qyx22122/projekt-RC/README.md

# projekt-RC
Projekt preučevanja in raziskovanja nizkocenovnih raketnih motorjev na trdo gorivo.
