qyx22122/projekt-RC/raziskovalna_naloga/predstavitev.tex

\documentclass[aspectratio=169]{beamer}

%Information to be included in the title page:
\title{Energijski izkoristek raketnih motorjev na trdno gorivo}
\author[Tibor Maček \and Leon Smrekar Voskobojnik]{Tibor Maček, 2. letnik \and Leon Smrekar Voskobojnik, 2. letnik \\[0.5cm] \small Mentor: Jure Ausec, univ. dipl. fiz.}

\institute{Gimnazija Vič}
\date{2026}

\usepackage[version=4]{mhchem}
\usepackage[slovenian]{babel}
\usepackage{graphicx, booktabs, physics, siunitx, amsmath, stackengine, geometry, csquotes, hyperref, tabularx}
\graphicspath{{./slike/}}

\hypersetup{
	colorlinks=false,
	linktoc=all,
}
\sisetup{output-decimal-marker={,}}

\usefonttheme[onlymath]{serif}

\usetheme{Berlin}
\usecolortheme{fly}

\begin{document}

\frame{\titlepage}

\section{Uvod}
\begin{frame}
\frametitle{Leteča raketa}
	\begin{figure}
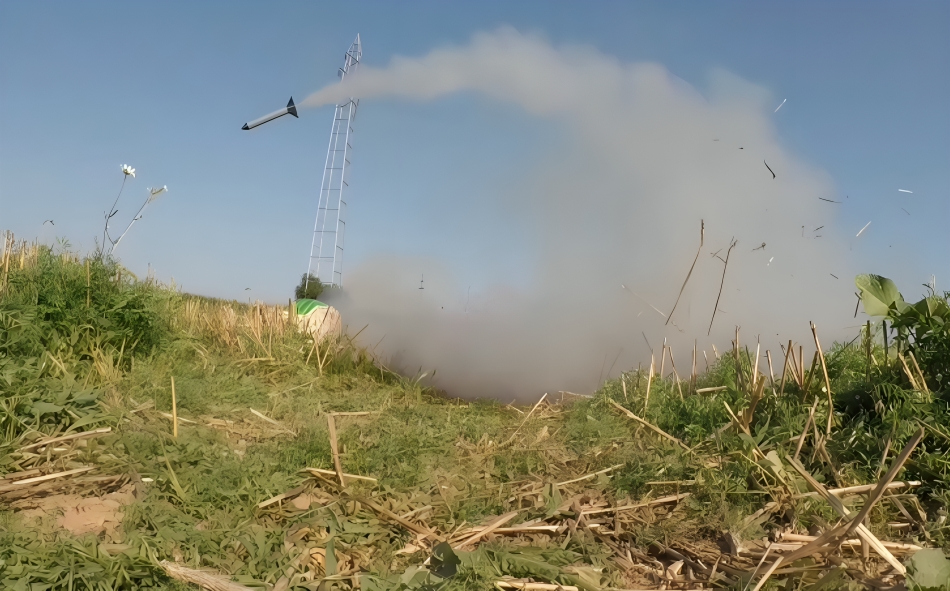
[picture p1: raziskovalna_naloga/slike/Raketa.png]
	

	\end{figure}
\end{frame}
\begin{frame}
\frametitle{Staljena raketa}
			\begin{figure}
			\centering
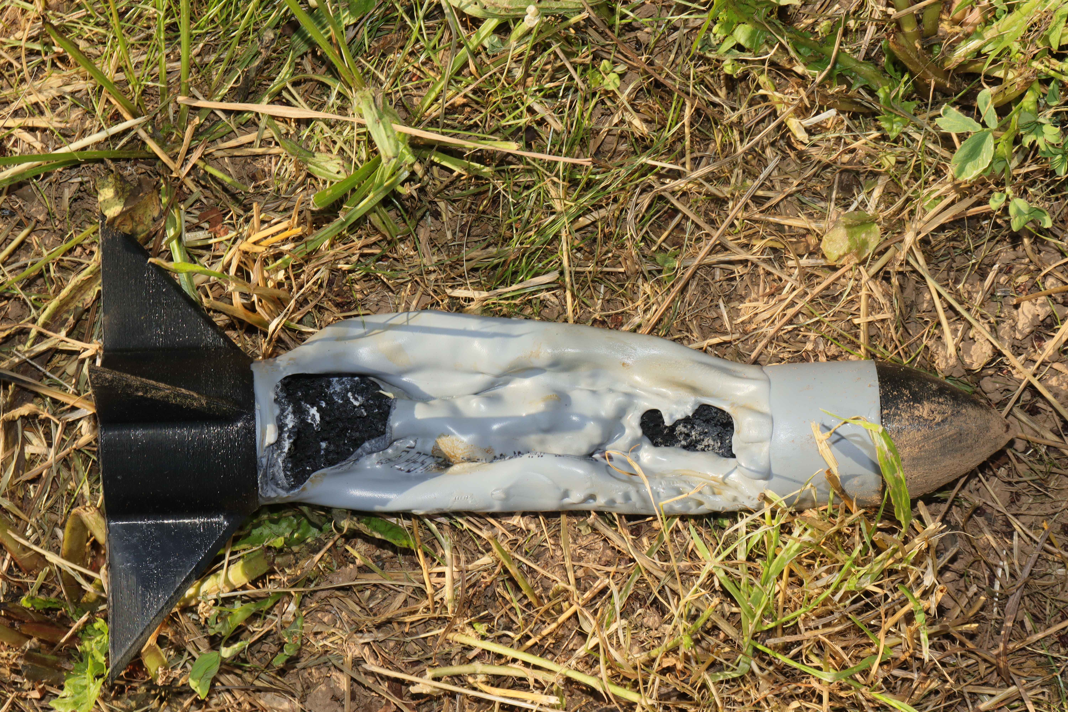
[picture p2: raziskovalna_naloga/slike/uporabljen_kondom.jpg]
			
			\end{figure}
\end{frame}

\section{Sestava motorja}
\begin{frame}
\frametitle{Sestava motorja}
	\begin{columns}
		\column{.5\textwidth}
				\begin{enumerate}
			\item Zunanja cev
				\begin{itemize}
					\item Notranji premer \SI{36}{mm}
					\item Debelina stene \SI{1,9}{mm}
					\item Dolžina \SI{125}{mm}
				\end{itemize} 
			\item Izolator
				\begin{itemize}
					\item Debelina \SI{1,75}{mm}
				\end{itemize} 
			\item Gorivna celica
				\begin{itemize}
					\item Masa \SI{75}{g}
					\item $60:40$ \ce{KNO3} : \ce{C12H22O11}
				\end{itemize} 
			\item Šoba
				\begin{itemize}
					\item Masa \SI{30}{g}
					\item Premer grla \SI{10}{mm}
				\end{itemize} 
		\end{enumerate}
		\column{.5\textwidth}
		\begin{flushleft}
			
		\end{flushleft}
	\end{columns}

\end{frame}

\section{Simuliranje}
\begin{frame}
\frametitle{Simuliranje v programu openMotor}
	\begin{figure}
	\centering
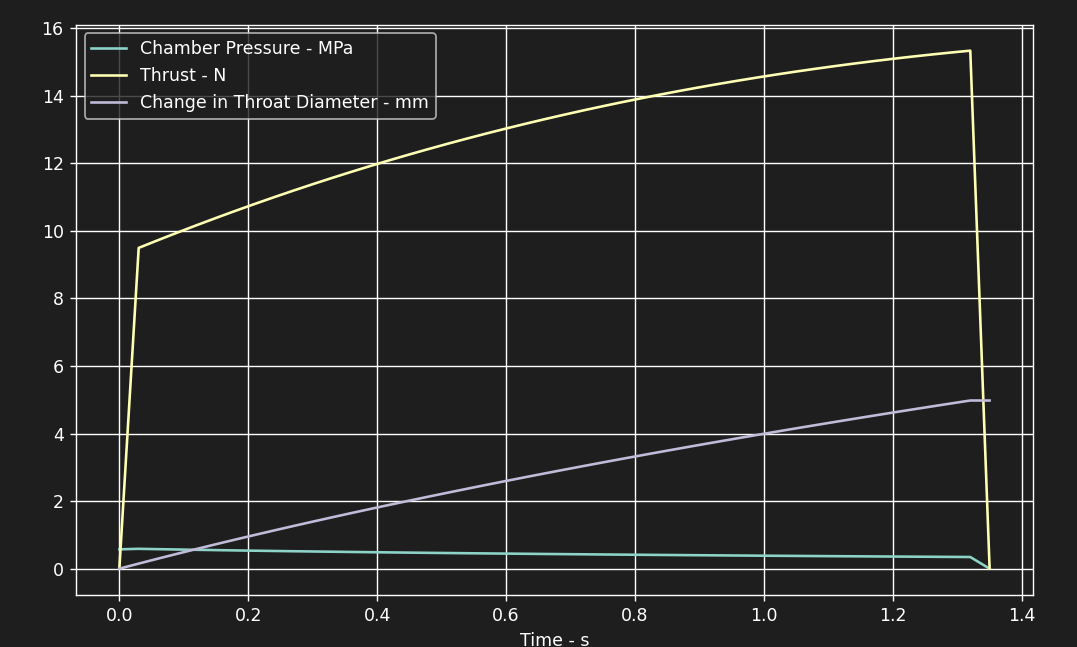
[picture p3: raziskovalna_naloga/slike/prilagojen_impulz_obrezan.png]
	
	
		\caption{Graf in regresija goriva - posnetek zaslona programa openMotor}
	\end{figure}
\end{frame}

\section{Testiranje izolatorjev}
\begin{frame}
\frametitle{Prvi in drugi test izolatorjev}
	\begin{figure}
	\centering
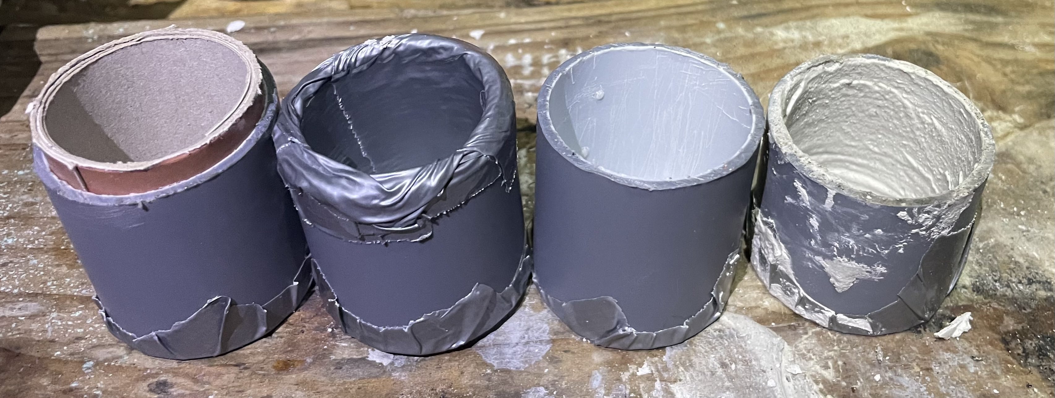
[picture p4: raziskovalna_naloga/slike/prvi_test.jpg]
	
	\end{figure}

	\begin{figure}
	\centering
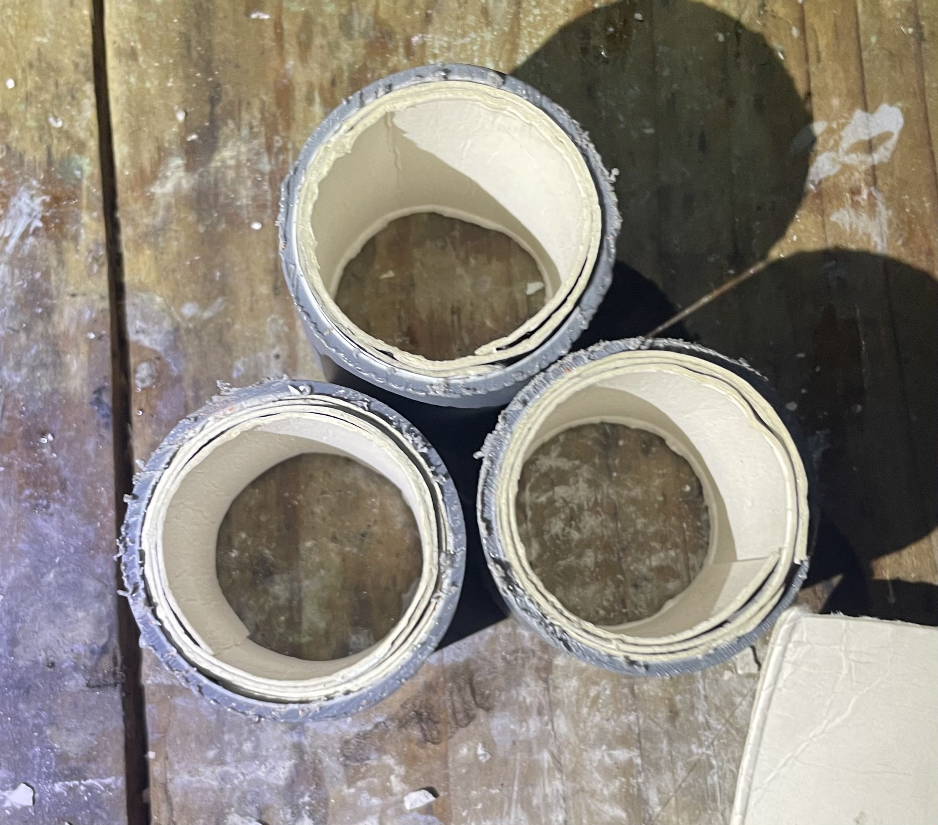
[picture p5: raziskovalna_naloga/slike/drugi_test.jpg]
	
	\hspace{0.3cm}
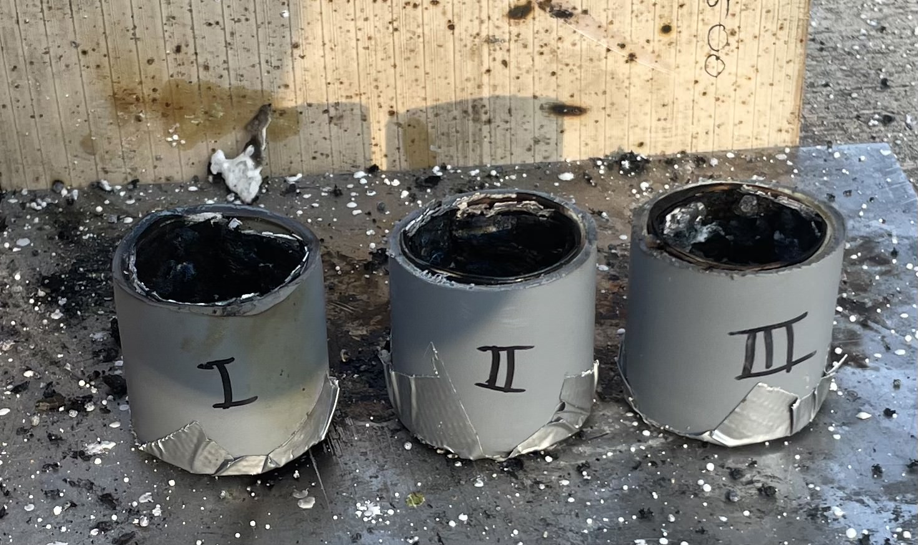
[picture p6: raziskovalna_naloga/slike/drugi_test_potem.jpg]
	
	\end{figure}
\end{frame}

\begin{frame}
\frametitle{Tretji in četrti test izolatorjev}
	\begin{figure}
	\centering
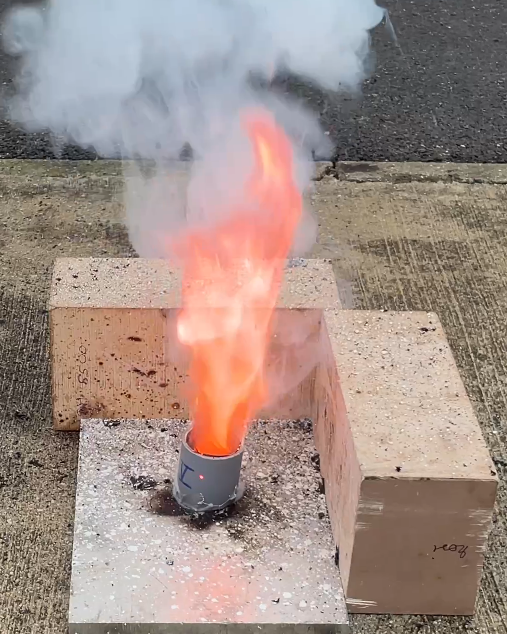
[picture p7: raziskovalna_naloga/slike/test3_5.png]
	
	\hspace{0.3cm}
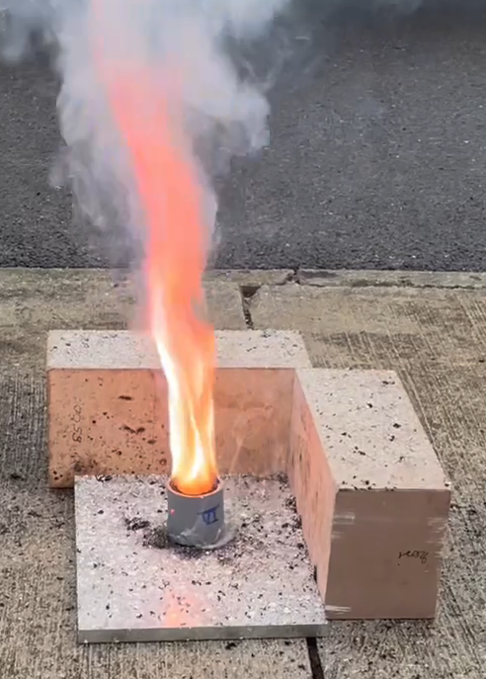
[picture p8: raziskovalna_naloga/slike/test3_6.png]
	
	\end{figure}

	\begin{figure}
	\centering
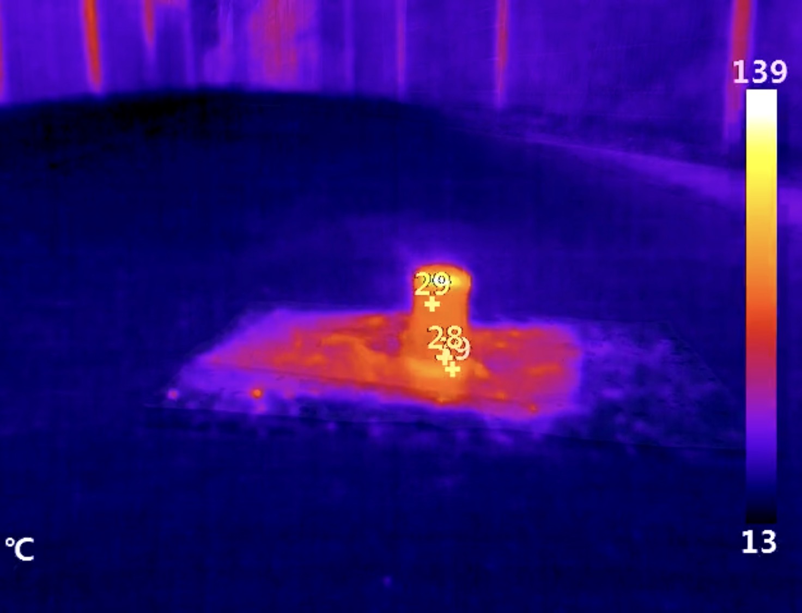
[picture p9: raziskovalna_naloga/slike/termalni_posnetek_takoj_po.jpg]
	
	\hspace{0.3cm}
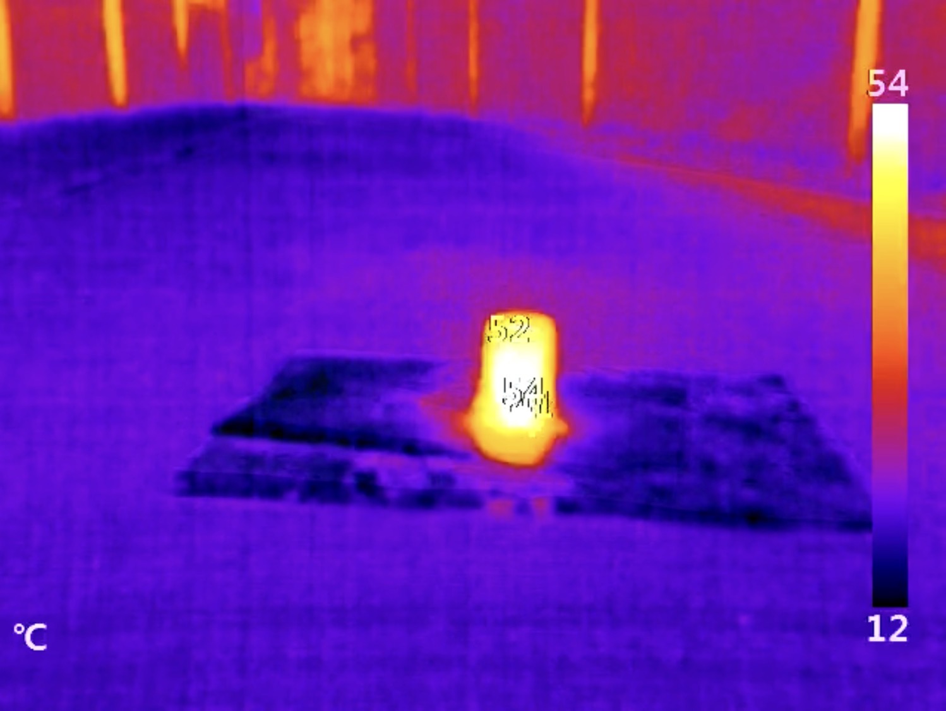
[picture p10: raziskovalna_naloga/slike/termalni_posnetek_kasneje.jpg]
	
	\end{figure}
\end{frame}

\section{Statično testiranje}

\begin{frame}
\frametitle{Statično testiranje}
	\begin{figure}
	\centering
	
	\caption{Prikaz povezanih pripomočkov za testiranje.}
	\label{setup}
	\end{figure}
\end{frame}

\begin{frame}
\frametitle{Prvi in drugi test motorja}
	\begin{figure}

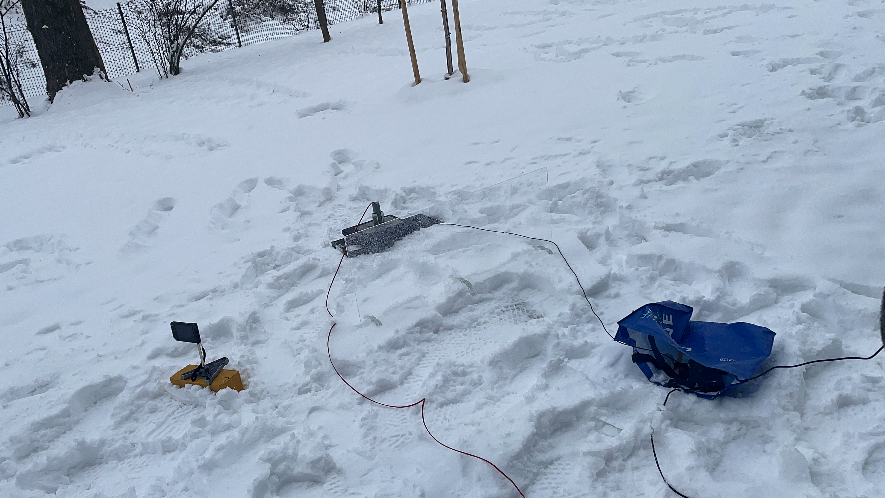
[picture p12: raziskovalna_naloga/slike/prvi_test_motorja.jpg]
	
	
	\caption{Prvo in drugo statično testiranje motorja.}
	\end{figure}
\end{frame}

\begin{frame}
\frametitle{Tretji test motorja}
	\begin{figure}
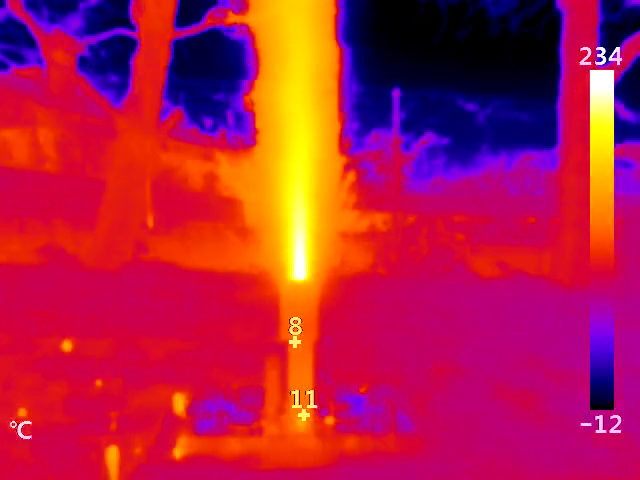
[picture p14: raziskovalna_naloga/slike/tretji_topl_gori.png]
	
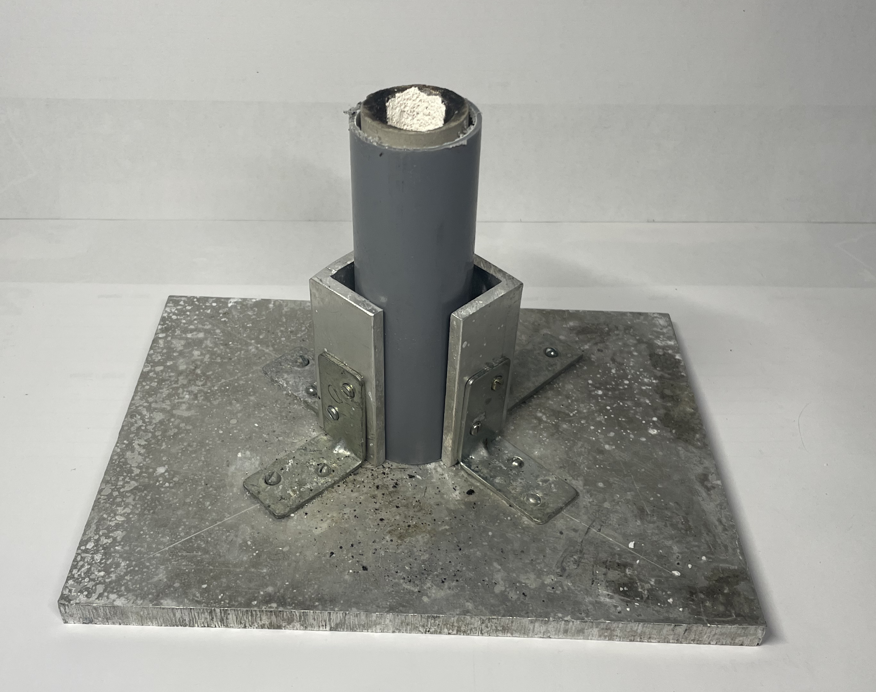
[picture p15: raziskovalna_naloga/slike/stojalo_motor.png]
	
	\caption{Tretji test sneman s termalno kamero, stojalo motorja}
	\end{figure}
\end{frame}

\begin{frame}
\frametitle{Tretji test motorja}
	\begin{figure}
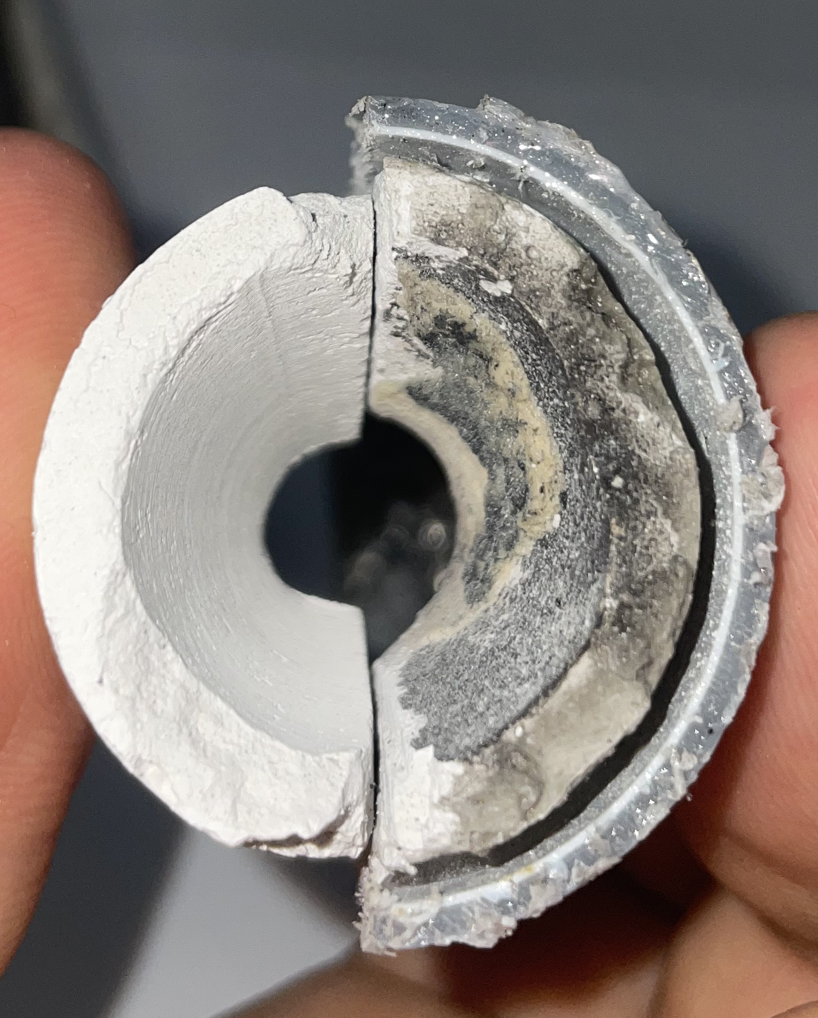
[picture p16: raziskovalna_naloga/slike/erozija_sobe.PNG]
	
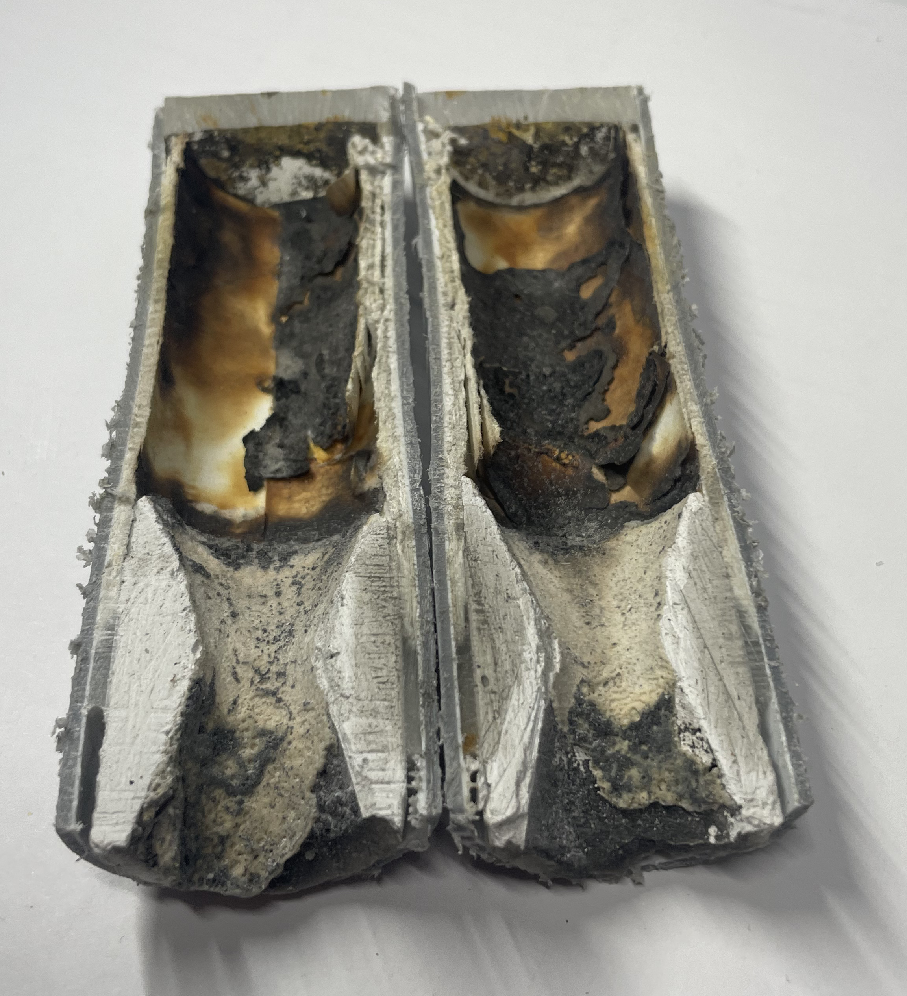
[picture p17: raziskovalna_naloga/slike/lezec.png]
	
	\caption{Primerjava sveže in erodirane šobe, prerezan testiran motor}
	\end{figure}
\end{frame}

\section{Analiza podatkov}
\begin{frame}
\frametitle{Analiza podatkov}
	\begin{figure}
	\centering
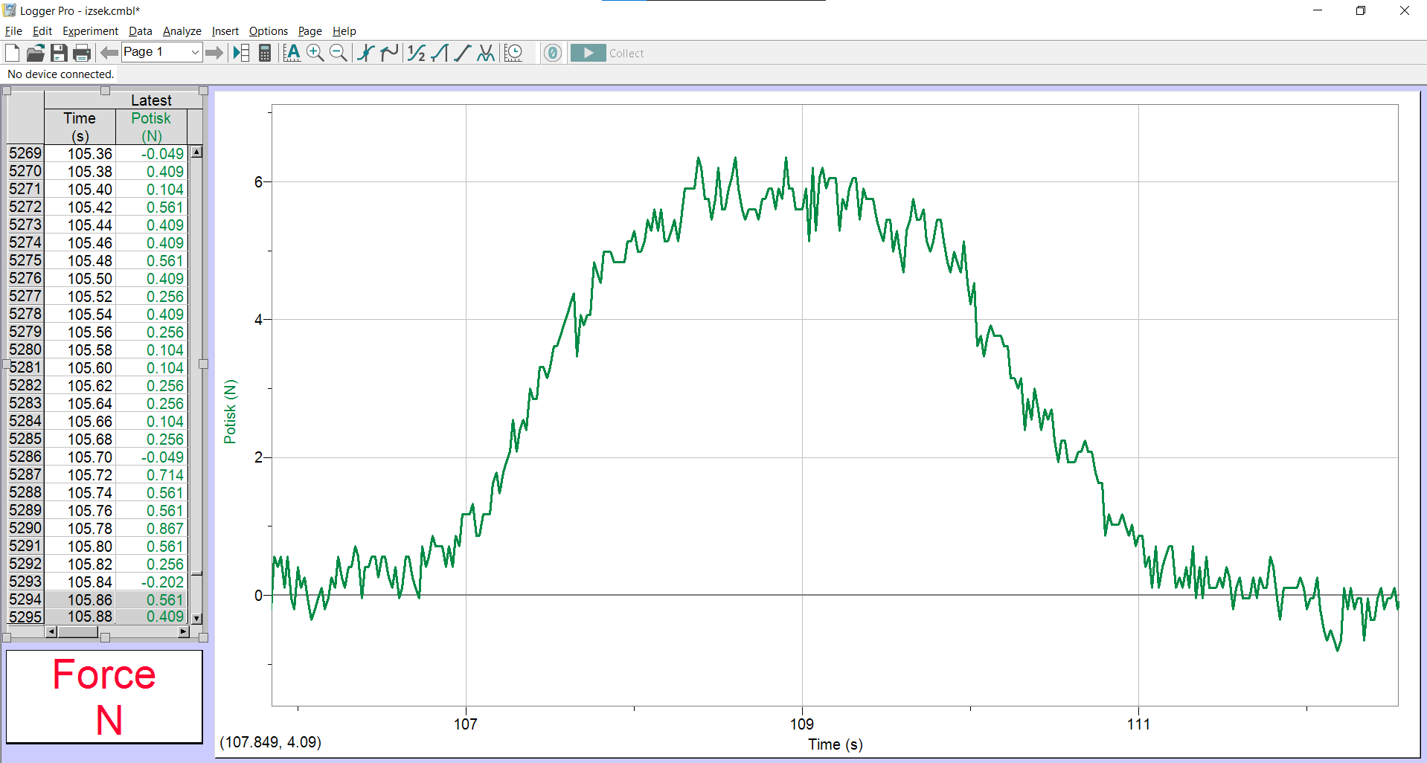
[picture p18: raziskovalna_naloga/slike/potisk.png]
	
	\end{figure}

	\begin{equation}
		 I = F \Delta t = \SI{17,3}{Ns} \pm \SI{1,6}{Ns}\nonumber
	\end{equation}
\end{frame}
\begin{frame}
\frametitle{Povprečni potisk in specifični impulz}

\begin{align}
\onslide<1->{
\bar{F} &= \frac{I}{t}
= \frac{\SI{17,3}{Ns} \pm \SI{1,6}{Ns}}
       {\SI{3,6}{s} \pm \SI{0,1}{s}}
= \SI{4,8}{N} \pm \SI{0,6}{N}
} \nonumber \\[1em]
\onslide<2->{
I_{SP} &= \frac{I}{m \cdot g_0}
= \frac{\SI{17,3}{Ns} \pm \SI{1,6}{Ns}}
       {(\SI{0,075}{kg} \pm \SI{0,001}{kg}) \cdot \SI{9.80665}{m/s^2}}
= \SI{23,5}{s} \pm \SI{2,3}{s}
} \nonumber
\end{align}
\end{frame}

\begin{frame}
\begin{align}
\frametitle{Izhodna hitrost izpuhov in sprememba hitrost rakete}
\onslide<1->{
\bar{v_e} &= \frac{I}{m}
= \frac{\SI{17,3}{Ns} \pm \SI{1,6}{Ns}}
       {\SI{0,075}{kg} \pm \SI{0,001}{kg}}
= \SI{230}{m/s} \pm \SI{23}{m/s}
} \nonumber \\[1em]
\onslide<2->{
\Delta v &= v_e \ln\!\left(\frac{m_0}{m_1}\right) = (\SI{230}{m/s} \pm \SI{23}{m/s})
   \cdot
   \ln\!\left(
   \frac{\SI{0,170}{kg} \pm \SI{0,001}{kg}}
        {\SI{0,095}{kg} \pm \SI{0,001}{kg}}
   \right) \nonumber \\[1em]
	&= \SI{134}{m/s} \pm \SI{17}{m/s}
} \nonumber
\end{align}
\end{frame}

\begin{frame}
				\begin{table}
					\centering
					\begin{tabular}{lll} 
						\hline
						Raketni motor & Vrsta & $I_{SP}$ [s] \\
						\hline \noalign{\vskip 0.3ex}
						NERVA NRX A6 & Nuklearni & 869\\ 
						RS-25 & Tekoče gorivo & 453 \\ 
						RD-843 & Tekoče gorivo & 315,5 \\
						Merlin 1D & Tekoče gorivo & 310 \\
						Avio Zefiro 9A & Trdno gorivo & 295,2\\
						Avio Zefiro 23 & Trdno gorivo & 287,5 \\
						Space Shuttle SRB & Trdno gorivo & 250 \\ 
						Najin motor & Trdno gorivo & 23,5 \\ 
						\hline
					\end{tabular}
				\end{table}
	\tiny
	\centering
	(https://www.dl1.en-us.nina.az/Specific\_impulse.html, 7. 2. 2026)

\end{frame}

\section{Zaključek}

\begin{frame}
\frametitle{Rezultati}
		\begin{itemize}
		\item Izdelava cenovno ugodnega motorja
		\item Dokaz papirja kot dobrega izolatorja
		\item Odkritje neprimernosti KD šobe za najin motor
		\item Omogočanje nadaljnjega testiranja motorja ostalim
		\item Ponovljiv način pridobivanja goriva
		\item Preverjena točnost simulacije
		\end{itemize}
\end{frame}

\begin{frame}
\frametitle{Opredelitev do preostalih hipotez}
	\begin{columns}
		\column{.5\textwidth}
		\begin{enumerate}
			\item Primerjava simulacije in izmerjenih podatkov\\
			\item Nizkocenovnost motorja \\
				\begin{itemize}
				\item Cena materialov enega motorja približno 1,15 evra.
				\end{itemize}
		\end{enumerate}
		\column{.5\textwidth}
			\begin{figure}
			\centering
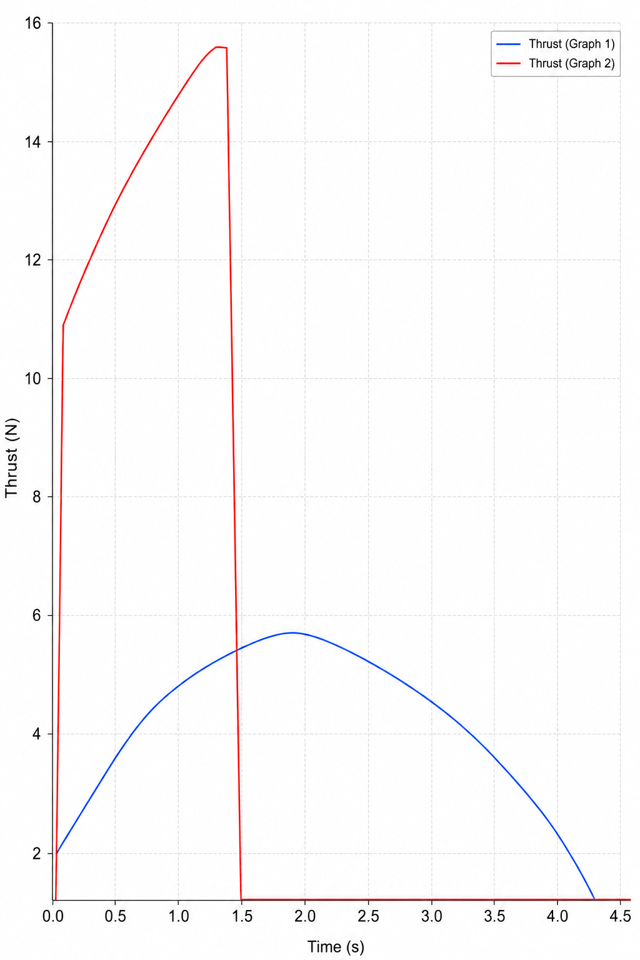
[picture p19: raziskovalna_naloga/slike/potisk_primerjava.png]
			
			\end{figure}
	\end{columns}
\end{frame}
\begin{frame}
\frametitle{Zaključek in ideje za naprej}
	Ideje za naprej :
		\begin{itemize}
		\item Drugi materiali za šobe
		\item Drugačna oblika šobe
		\item Raziskava vpliva vlage na gorivo
		\item Alternativna goriva
		\item Preizkusiti druge metode izdelave goriva 
		\item Dinamično testiranje motorja v raketi
		\end{itemize}
		
\end{frame}
\begin{frame}
\frametitle{Hvala za pozornost}
			\begin{figure}
			\centering
			
			\end{figure}
\end{frame}

\section{Dodatna Gradiva}
\begin{frame}
			\begin{figure}
			\centering
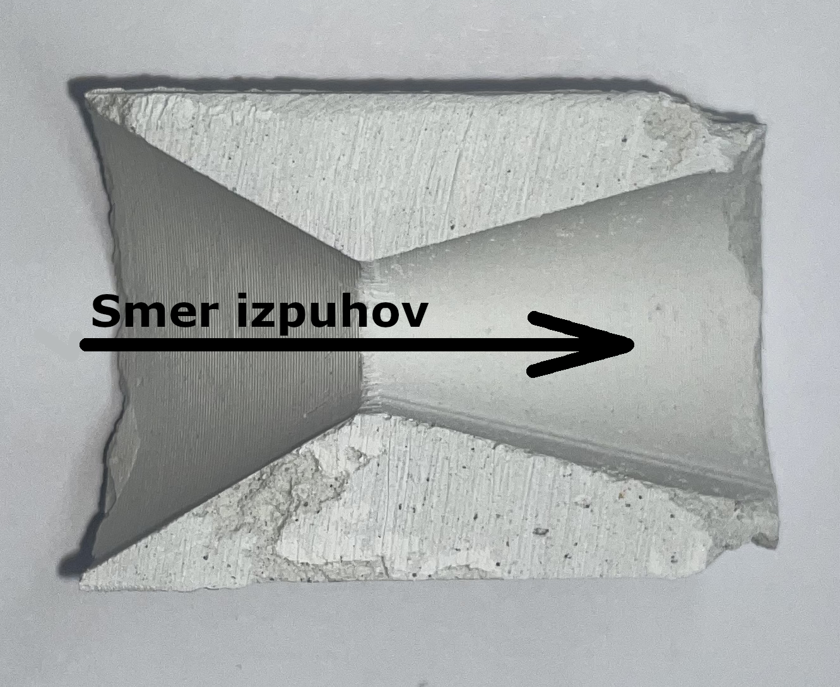
[picture p20: raziskovalna_naloga/slike/prerez_sobe_smer.png]
				
			\end{figure}

			\begin{equation} \label{eq:šoba-vA}
				(1 - M^2) \frac{\dd v}{v} = - \frac{\dd A}{A} \nonumber
			\end{equation}
\end{frame}
\begin{frame}

			\begin{figure}
			\centering
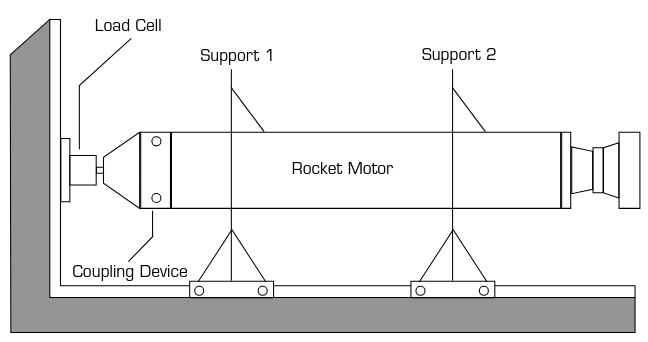
[picture p21: raziskovalna_naloga/slike/shema_merjenja_potiska.png]
			
			\caption{Shema tipičnega statičnega testa.}
			\end{figure}
\end{frame}
\begin{frame}

				\begin{figure}
				\centering
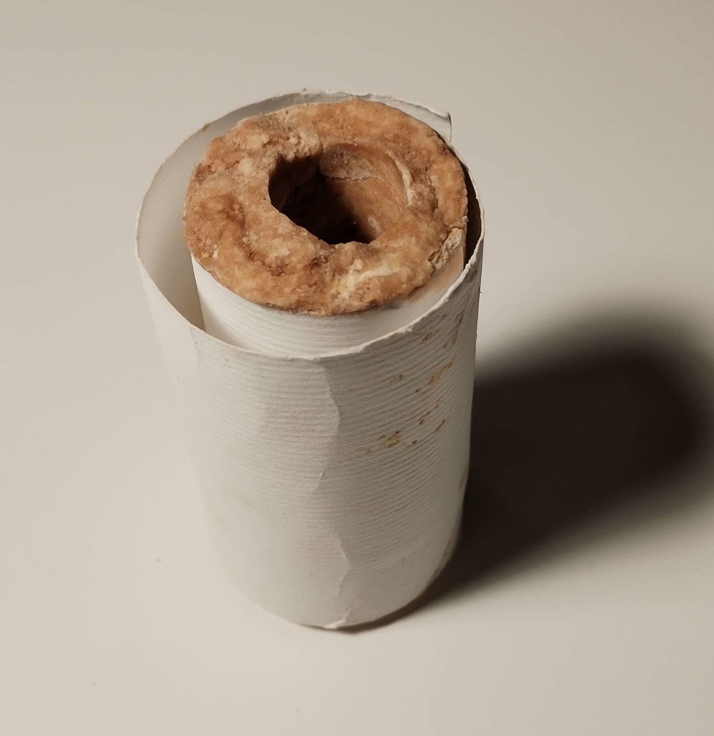
[picture p22: raziskovalna_naloga/slike/gorivna_celica_med.jpg]
				
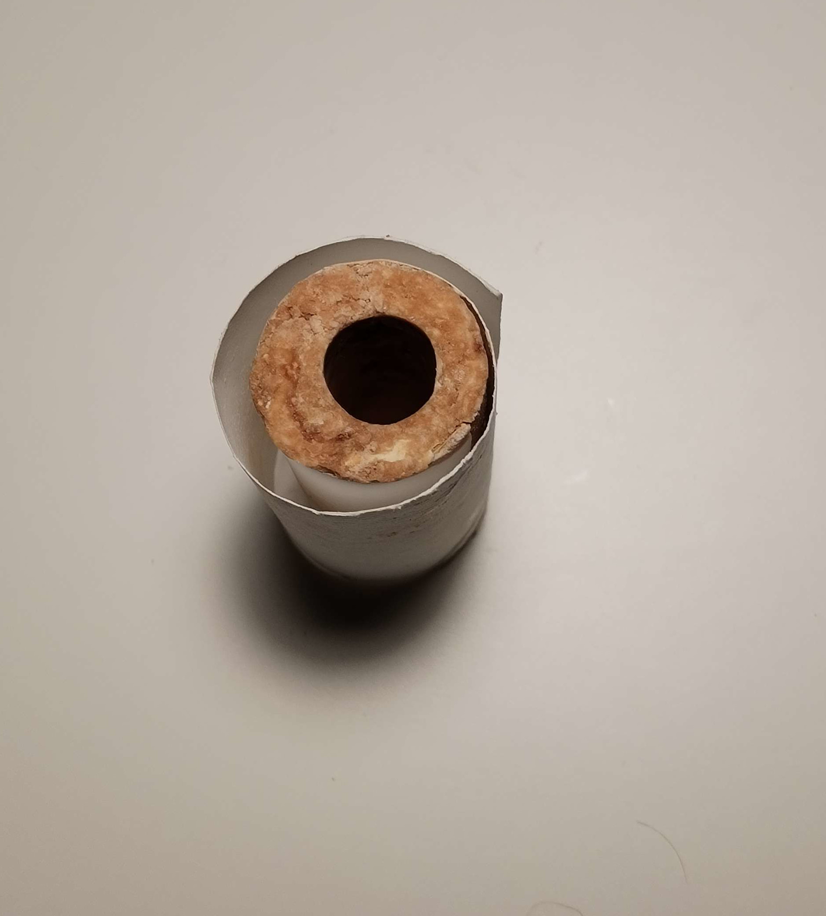
[picture p23: raziskovalna_naloga/slike/gorivna_celica_med2.jpg]
				
				\end{figure}

				\begin{figure}
				\centering
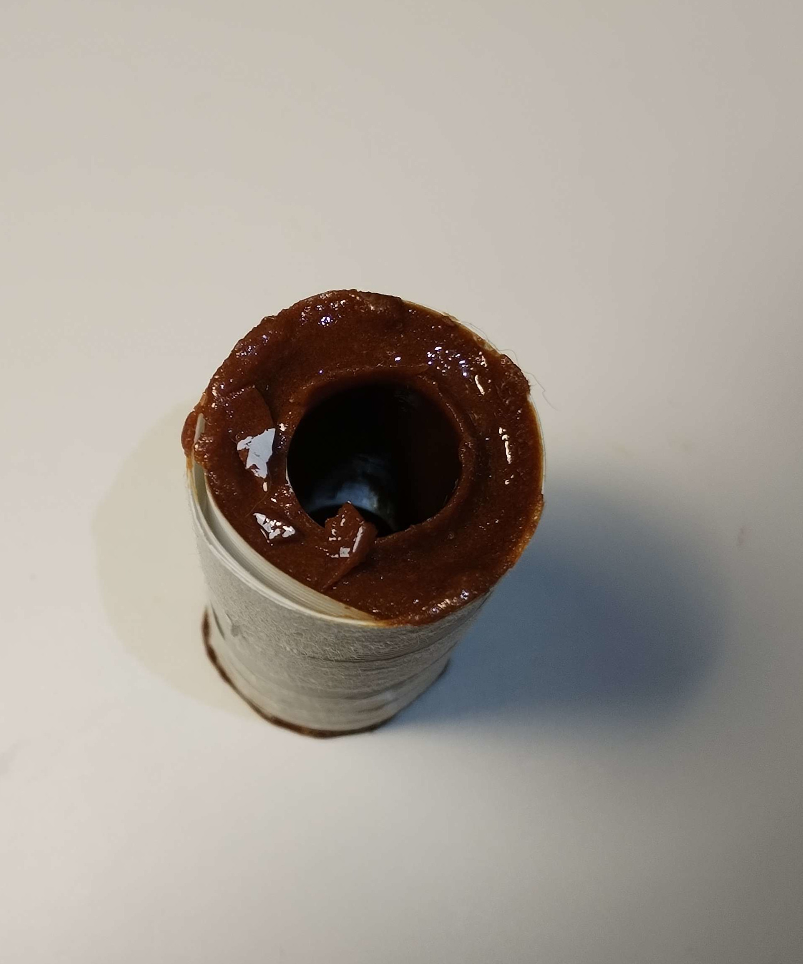
[picture p24: raziskovalna_naloga/slike/gorivna_celica.jpg]
				
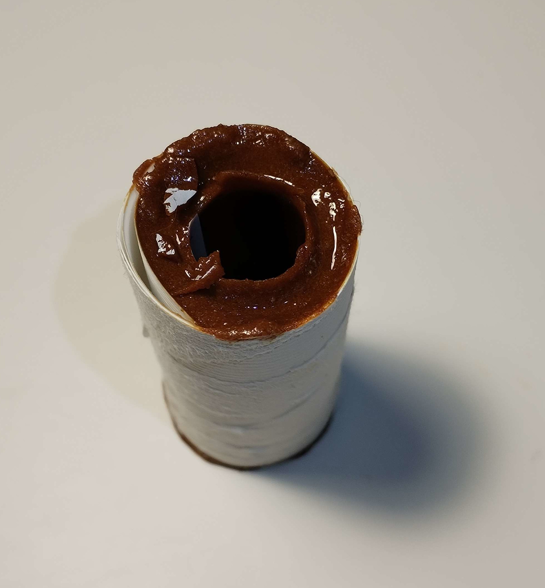
[picture p25: raziskovalna_naloga/slike/gorivna_celica2.jpg]
				
				\end{figure}
\end{frame}
\begin{frame}
			\begin{figure}
			\centering
			
			\caption{Digestorij (odduha), kjer je pripravljeno vse za pripravo gorivnih celic.}
			\end{figure}
\end{frame}

\begin{frame}

			\begin{figure}
			\centering
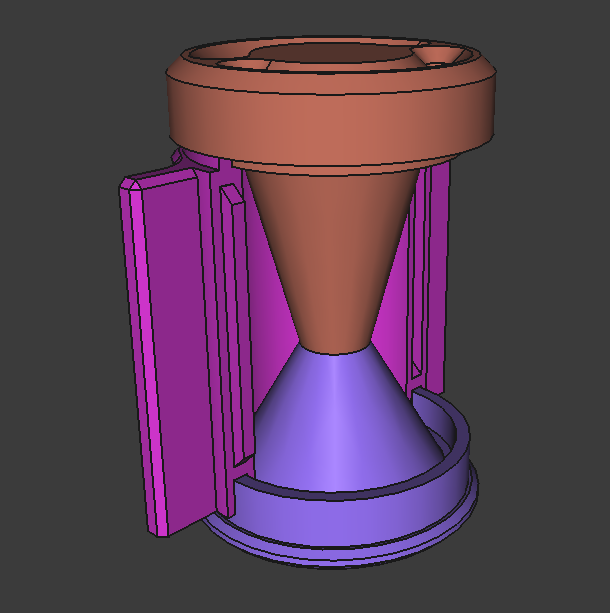
[picture p26: raziskovalna_naloga/slike/šoba_1.png]
			
			\hspace{0.3cm}
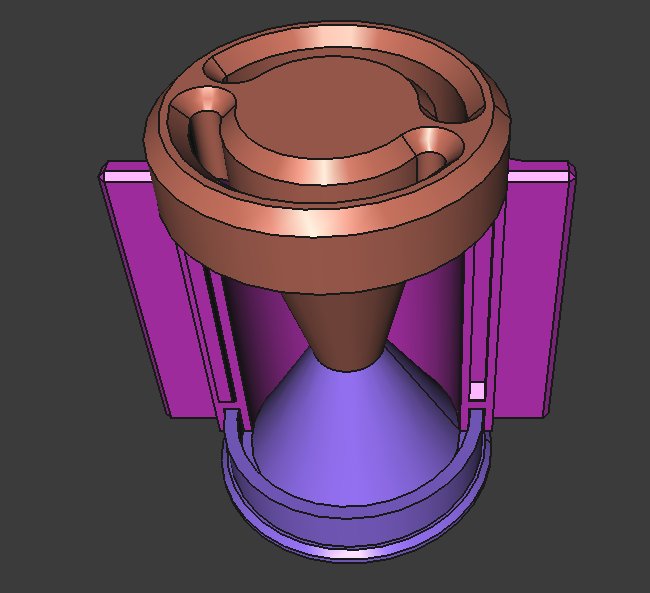
[picture p27: raziskovalna_naloga/slike/šoba_2.png]
			
			\end{figure}

			\begin{figure}
			\centering
			\hspace{0.3cm}
			
			\hspace{0.3cm}
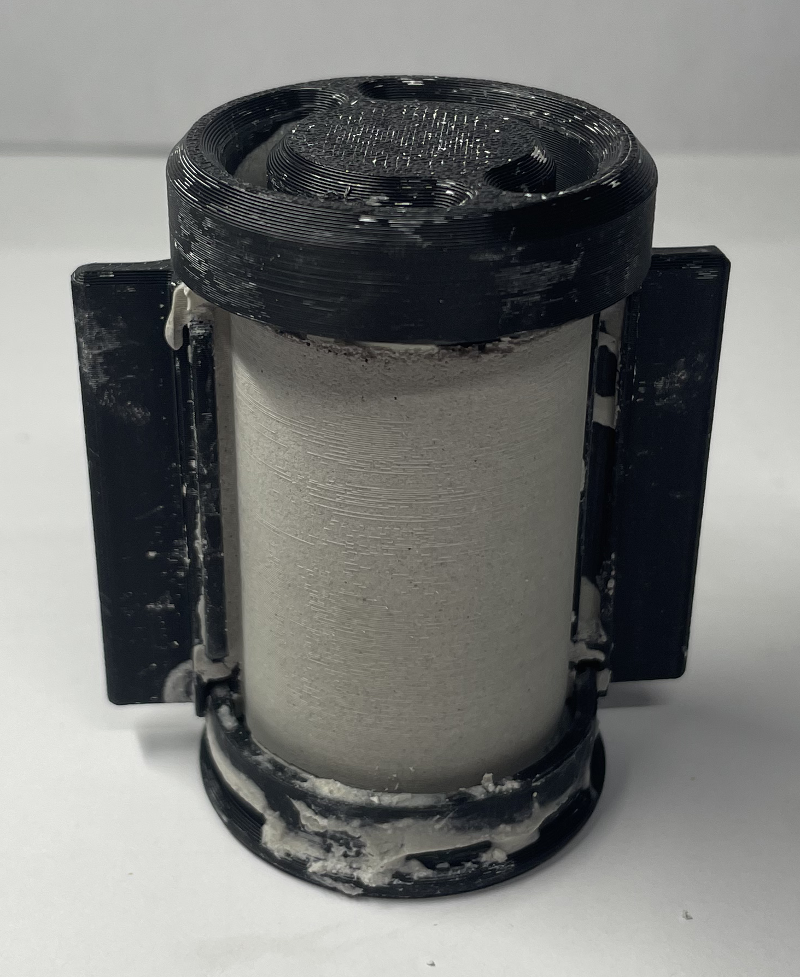
[picture p29: raziskovalna_naloga/slike/model_krilo_poln.png]
			
			\hspace{0.3cm}
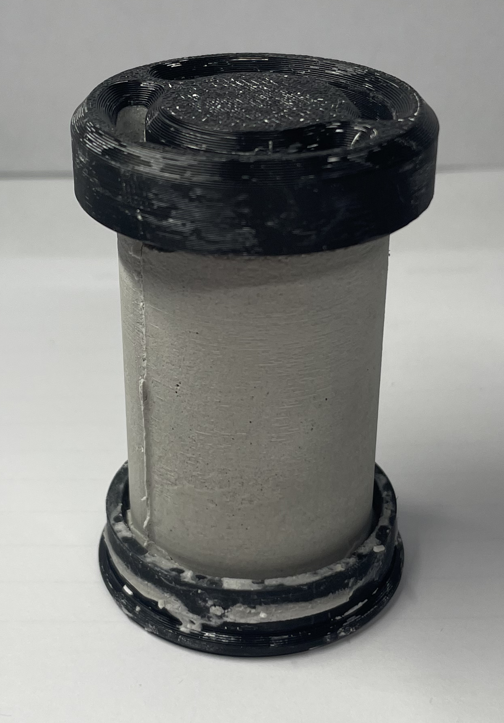
[picture p30: raziskovalna_naloga/slike/model_s_sobo.png]
			
			\end{figure}
\end{frame}
\begin{frame}
\ce{C12H22O11(s) + 6.288 KNO3(s) ->\\ -> 3.796 CO2(g) + 5.205 CO(g) + 7.794 H2O(g) + 3.065 H2(g) +\\+ 3.143 N2(g) + 2.998 K2CO3(l) + 0.274 KOH(g)}
\end{frame}

\end{document}
