qyx22122/projekt-RC/raziskovalna_naloga/EIRMNTG.tex

\documentclass[titlepage, a4paper, twoside, final, 12pt]{article}

\setcounter{secnumdepth}{2} %Globina uštevilčnja naslovov
\setcounter{tocdepth}{3} %Do katere globine bodo naslovi v kazalu

\usepackage[slovenian]{babel}
\usepackage{csquotes}
\usepackage[version=4]{mhchem}
\usepackage[backend=biber, date=iso, seconds=true]{biblatex}
\setcounter{biburllcpenalty}{7000}
\setcounter{biburlucpenalty}{8000}
\usepackage{graphicx}
\usepackage{geometry}
\usepackage{stackengine}
\usepackage{physics}
\usepackage{amsmath}
\usepackage{siunitx}
\sisetup{
	output-decimal-marker = {,},
}

\usepackage{float} %za hard override placementa slik /begin{figure}[H]
\usepackage{placeins} % za barierje placementa slik /FloatBarrier

\usepackage{fancyhdr}
\pagestyle{fancy}

\fancyhf{}              % clear all header and footer fields
\fancyhead[L]{Energijski izkoristek raketnega motorja na trdno gorivo}  % left header
\fancyhead[C]{}    % center header
\fancyhead[R]{Raziskovalna naloga} % right header

\fancyfoot[C]{\thepage}
\addtolength{\topmargin}{-2.49998pt}

\usepackage{hyperref}
\hypersetup{
	colorlinks=false,
	linktoc=all,
}

\usepackage[nameinlink]{cleveref} % za lepse, auto reference. sintaksa: v sliki /label{label} in potem /cref{label} za lepo naslavljanje slik in tabel

\graphicspath{{./slike/}}

\addbibresource{./literatura.bib}

\geometry{centering}

\begin{document}

\begin{titlepage}
	\begin{center}
		\vspace*{1cm}
		\huge
		\textbf{Energijski izkoristek raketnega motorja na trdno gorivo}
			
		\vspace{1.5cm}

		\normalsize
		Avtorja:
		
		\large
		\textbf{Leon Smrekar Voskobojnik, 2. letnik}

		\textbf{Tibor Maček, 2. letnik}
		\vspace{0.5cm}
		
		\normalsize
		Mentor:
	
		\large
		\textbf{Jure Ausec}
		\vfill
		%\includegraphics{kul slika}
		\normalsize
		Raziskovalna naloga s področja fizike
		\vspace{1.5cm}	

		
		\vspace{0cm}

		Gimnazija Vič
		2025/2026

	\end{center}
\end{titlepage}

\renewcommand{\thepage}{\Roman{page}}
\renewcommand{\abstractname}{Zahvala}
\begin{abstract}
	\thispagestyle{plain}
	\setcounter{page}{2}
	Zahvalila bi se rada za vso pomoč, ki sva je bila deležna ob raziskovanju in ustvarjanju naloge. 

	Posebno bi se rada zahvalila vsem uslužbencem Gimnazije Vič, ki so nama hitro priskočili na pomoč, in sicer prof. Alenki Ocvirk Zelič za lektoriranje povzetka in naloge,
	laborantki kemije Andreji Šporar za omogočanje dostopa do šolskega digestorija, 
	hišnikoma Slavku Gorniku in Bojanu Jakši za izdelavo stojala za testiranje,
	laborantu fizike Denisu Pavlinu za dostopnost, predloge in pomoč pri testiranju.
	Posebna zahvala pa mentorju Juretu Auscu za predloge, pregledovanje in predlaganje popravkov ter izboljšav, pomoč pri testiranju, prisotnost in posledično omogočanje uporabe digestorija tudi za petkove popoldneve ter za odgovarjanje na vsakršna vprašanja in vsespološno odzivnost.
\end{abstract}

	\renewcommand{\thepage}{\Roman{page}}
		\thispagestyle{plain}
		\setcounter{page}{3}
		\section*{Povzetek}
		V raziskovalni nalogi sva se poglobila v delovanje, simuliranje in testiranje raketnih motorjev na trdno gorivo. V teoretičnem delu sva opisala, na katerih fizikalnih zakonih temeljijo raketni motorji in kakšno funkcijo imajo posamezni deli raketnega motorja na trdno gorivo. Nato sva se lotila razvoja lastnega raketnega motorja na trdno gorivo, ki je narejen iz dostopnih in cenovno ugodnih materialov ter ne potrebuje manj dostopnih strojev, kot sta na primer stružnica in CNC rezkar. Testirala sva različne vrste in debeline izolatorjev, dokler nisva našla najprimernejšega. S simulacijo sva si pomagala pri načrtovanju šobe in ostalih kritičnih dimenzij motorja, ki sva ga nato tudi sestavila in testirala. Iz pridobljenih podatkov sva potrdila primernost izolatorja in izračunala učinkovitost motorja. Nazadnje sva primerjala izmerjene vrednosti s tistimi iz simulacije, da sva lahko prilagodila parametre simulacije za natančnejše napovedi.

		Ugotovila sva, da je raketo na trdno gorivo mogoče izdelati iz prostodostopnih in nizkocenovnih materialov. Na koncu predlagava še nekaj že ugotovljenih izboljšav in nakaževa možnosti za nadaljnje raziskovanje in testiranje.
		\\[2ex]
		Ključne besede: raketni motor, trdno gorivo, izolator, šoba, specifični impulz

\vspace{0.5cm}
\section*{Abstract}
		In our research project, we delved into the operation, simulation, and testing of solid fuel rocket engines. In the theoretical part, we described the physical laws on which rocket engines are based and the function of individual parts of a solid fuel rocket engine. We then set about developing our own solid fuel rocket engine, made from readily available and inexpensive materials and requiring no specialised equipment such as a lathe or CNC milling machine. We tested different types and thicknesses of insulators until we found the most suitable ones. We used simulation to help us design the nozzle and other critical dimensions of the engine, which we then assembled and tested. From the data obtained, we confirmed the suitability of the insulator and calculated the efficiency of the engine. Finally, we compared the measured values with those from the simulation so that we could adjust the simulation parameters for more accurate predictions.

		We found that a solid fuel rocket can be made from readily available and low-cost materials. Finally, we suggest some improvements that have already been identified and point out opportunities for further research and testing.
		\\[2ex]
		Keywords: rocket motor, solid fuel, insulator, nozzle, specific impulse

	\tableofcontents

	\listoftables

	\listoffigures

	\newpage

	\renewcommand{\thepage}{\arabic{page}}

		\section{Uvod}
		Z razvojem raketne znanosti se je razširilo tudi amatersko raketarstvo in z njim različne velikosti raket, različni materiali in tipi goriva. Skozi čas so
		materiali in znanje postajali vse bolj dostopni. V teh časih vsakdo lahko izdela model rakete, edina vprašanja so izbira materialov,
		porabljen čas in denar, kako varna bo izvedba in kako učinkovit bo motor. Čeprav obstajajo tudi majhni komercialni motorji, sva si želela narediti svoj, cenovno ugodnejši motor.
		Da bi prihranila na opremi, času in denarju nasploh, sva si izbrala najenostavnejše in najcenejše gorivo. Kaj kmalu se nama je porodilo vprašanje
		učinkovitosti in tako so nastali temelji za raziskovalno nalogo. Želela sva dokazati, da je tudi z malo sredstvi in iz
		prostodostopnih materialov mogoče narediti učinkovito in zmogljivo raketo. Tak motor je dostopnejši in posledično na voljo vsem, ki ga želijo uporabiti ali izvesti nadaljnje poizkuse.
		Motor sva tudi analizirala, tako s teoretičnega vidika, kot tudi s statičnim testiranjem.
		
		\subsection{Hipoteze}
		Že na začetku so se nama porodile številne hipoteze, ki sva jih skozi raziskovalno nalogo preizkusila in se na koncu do njih tudi opredelila.
		Postavila sva sledeče hipoteze:
		\begin{enumerate}
				\item Raketni motor na trdno gorivo je mogoče narediti iz nizkocenovnih in dostopnih materialov.
				\item Papir je primeren izolator in notranja plast zgorevalne komore raketnih motorjev na trdno gorivo.
				\item Šobe iz mavca lahko prenesejo tlak in visoke temperature, katerim so izpostavljene v motorju.
				\item Simulacije, pridobljene s programom openMotor, so primerljive z empiričnimi podatki.
		\end{enumerate}

		\section{Varnost}
		Za raketne pogone so značilne eksotermne kemijske reakcije in gorivo, ki ga uporabljava, ni nič drugačno. Ob vžigu gori z izredno vročim plamenom in
		ga je skoraj nemogoče pogasiti, saj gori neodvisno od kisika v ozračju, ker vsebuje oksidator, v najinem primeru \ce{KNO3}.
		Proces gorenja prikazuje enačba \ref{eq:gorjenje-goriva}, kjer med reaktanti ni elementarnega kisika (\ce{O2}).
		Ob nepravilnem ravnanju lahko zelo hitro dobimo tudi hujše opekline. Dober primer je vsuvanje mešanice v prevročo posodo pri pripravi goriva, saj se v tem primeru ta lahko spontano vžge.
		Kot produkt reakcije se sproščajo plini, ki dražijo oči in dihala. Testiranje v zaprtih prostorih je tako odsvetovano, tudi zaradi tveganja glede materialne škode.
		Pri prižigu v posodah, kjer omejujemo uhajanje plinov med njihovim nastankom tlak skokovito raste. Posledično reakcija pospešuje, kar povzroča še hitrejše nastajanje plinov.
		To vodi v pozitivno povratno zanko, ki se ponavadi konča z eksplozijo, pri kateri je nevarnost šrapnelov in poškodbe sluha zaradi udarnega vala.

%       poteka reakcija zaradi skokovitega naraščanja hitrosti nastajanja plinov še hitreje in s tem se tudi tlak dviguje pospešeno

		Da bi zagotovila tako lastno varnost, kot tudi preprečila materialno škodo, sva uporabljala minimalne količine goriva, potrebne za reprezentativnost. Pri pripravi goriva sva
		bila pozorna na temperaturo. Gorivo sva pripravljala v digestoriju, da sva se
		zavarovala pred prašnimi delci \ce{KNO3}. Testirala sva na prostem, testne modele
		varno pritrdila in bila pozorna, da ne bi presegla tlaka, ki ga prenese zunanja cev pri določeni temperaturi.

		\section{Teoretičeni del}
		Raketni motorji delujejo zaradi zakona o ohranitvi gibalne količine; motor pospeši vroče pline v nasprotno smer gibanja rakete in s tem poveča hitrost rakete.
		Pri raketnih motorjih na trdno gorivo ta plin pride iz reakcije goriva in oksidatorja, obeh v trdnem agregatnem stanju. V zgorevalni komori je zaradi tega ustvarjen povišan tlak.
		Vroči plini uhajajo skozi šobo, katere funkcija je izkoriščanje tlaka in temperature teh plinov, da jih pospeši do visokih hitrosti in jim s tem poveča gibalno količino.

			\subsection{Gorivo}
			Vrst trdnih goriv za raketne motorje je zelo veliko, a imajo v osnovi vsa podobno sestavo - so mešanica goriva in oksidatorja, potem pa se dodaja še
			katalizatorje in sredstva za strjevanje. Midva sva se odločila za gorivo, ki ga pogosto poimenujejo "rocket candy".
			Ponavadi je sestavljeno iz sladkorja oziroma ogljikovega hidrata (pogosti sladkorji so saharoza, sorbitol in dekstroza) ter kalijevega nitrata (\ce{KNO3}) ter občasno
			tudi nekaterih primesi (npr. \ce{Fe2O3}, ki je katalizator in pospešuje reakcijo).
			Kadar je "rocket candy" narejen iz sladkorja saharoze (\ce{C12H22O11}) in kalijevega nitrata, ga lahko poimenujemo kar s kratico KNSU (\ce{KNO3} in angl. sucrose).
			Po literaturi, ki sva jo našla, je optimalno razmerje saharoze in \ce{KNO3} 35/65 \cite{nakkaKNSU2025}, učinkovitost in hitrost gorjenja goriv pa je sorazmerno povezana s tlakom.\cite{nakka_thrust}
			\\Kemijsko enačbo za gorenje prikazuje enačba \ref{eq:gorjenje-goriva}.\cite{nakkaKNSUchem2025}
			\begin{align} \label{eq:gorjenje-goriva}
			\begin{split} 
					\ce{C12H22O11(s) + 6.288 KNO3(s) ->\\ -> 3.796 CO2(g) + 5.205 CO(g) + 7.794 H2O(g) + 3.065 H2(g) +\\+ 3.143 N2(g) + 2.998 K2CO3(l) + 0.274 KOH(g)}
			\end{split}
			\end{align}

			\begin{table}
			\centering
			\begin{tabular}{lll}
			\hline
			Snov & Agregatno stanje & Kemijska formula \\
			\hline \noalign{\vskip 0.3ex}
			Saharoza & trdno & \ce{C12H22O11} \\
			Kalijev nitrat & trdno & \ce{KNO3} \\
			Ogljikov dioksid & plinasto & \ce{CO2} \\
			Ogljikov monoksid & plinasto & \ce{CO} \\
			Vodna para & plinasto & \ce{H2O} \\
			Vodik & plinasto & \ce{H2} \\
			Dušik & plinasto & \ce{N2} \\
			Kalijev karbonat & tekoče & \ce{K2CO3} \\
			Kalijev hidroksid & plinasto & \ce{KOH} \\
			\hline
			\end{tabular}
			\caption{Seznam snovi, agregatnih stanj in kemijskih formul gorjenja goriva}
			\end{table}

			\subsection{Toplotni izolatorji} \label{tp_izo}
			Toplota večinoma potuje s konvekcijo, ki je značilna za tekočine, radiacijo in s prevajanjem ali kondukcijo, ki je značilna za materiale v trdnem agregatnem stanju.
			Pri kondukciji se toplotni tok $P$ računa po Fourierovem zakonu, z enačbo \ref{eq:t.prevodnost}, kjer je $\lambda$ toplotna prevodnost materiala, $S$ ploščina preseka, $\Delta T$ razlika
			v temperaturah krajišč in $d$ razdalja, skozi katero toplota potuje.\cite{Thermal_Conductivity}
			Kot toplotne izolatorje navadno označujemo materiale, ki slabo prevajajo toploto, oziroma imajo majhno vrednost $\lambda$.

			\begin{equation} \label{eq:t.prevodnost}
				P = \frac{\lambda S \Delta T}{d}
			\end{equation}

			Izolator ne sme biti predebel, saj je raketa s težjim ohišjem manj učinkovita. 
			Vsak izolator prav tako zavzema prostornino, ki bi jo lahko zasedalo gorivo. Če lahko enako maso goriva ulijemo v krajšo cev, to pomeni lažje ohišje in posledično učinkovitejši motor.
			Zato stremimo k tanjšim oziroma minimalnim debelinam izolatorjev in posledično tudi k materialom, ki so slabši toplotni prevodniki.

			\subsection{Šoba} \label{soba}
			Šoba je navzven enostaven del raketnega motorja, ki pa je izrednega pomena za pravilno delovanje, saj z omejevanjem in usmerjanjem nekaterih vročih produktov
			reakcije povzroči potisk, ki pospeši raketo.
			Od šobe je odvisen tlak v zgorevalni komori, od katerega je odvisna hitrost reakcije in njena učinkovitost. Šoba določa tudi največji doseženi tlak, ki ga morajo zdržati vsi ostali deli motorja.
			Šoba na notranji strani konvergira proti premeru grla
			in nato divergira do izhodnega premera - od tod tudi prideta imeni konvergentno-divergentna oz. KD šoba, poznana tudi kot De Laval šoba.
			Tekočine v taki šobi operirajo v dveh različnih režimih, ki jih opisuje spodnja enačba.\cite{nasa:nozzle_design}
			\begin{equation} \label{eq:šoba-vA}
				(1 - M^2) \frac{\dd v}{v} = - \frac{\dd A}{A}
			\end{equation}

			\begin{figure}
			\centering
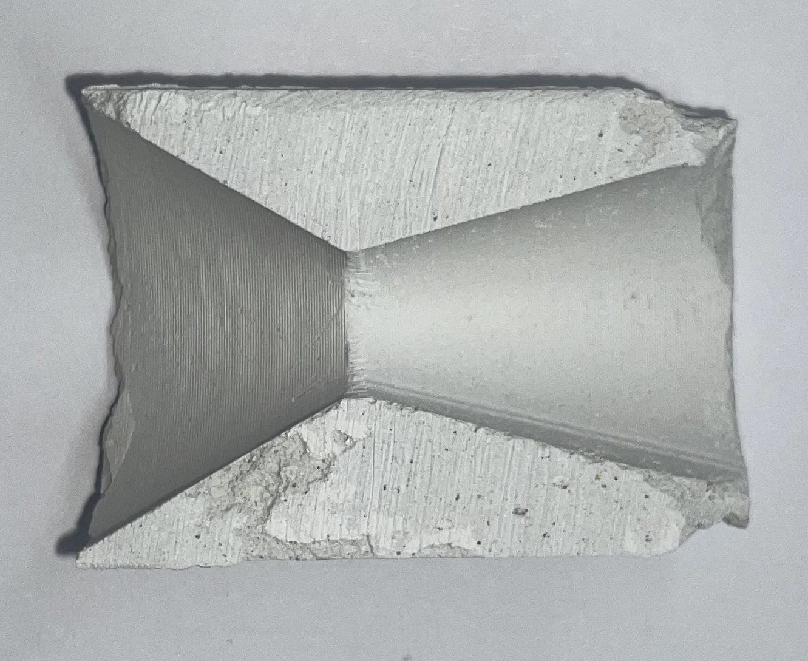
[picture p31: raziskovalna_naloga/slike/prerez_sobe.png]
			
			\caption[Prerez šobe]{Šoba iz mavca, prerezana na polovico. Od leve proti desni konvergira do grla, nato divergira.} \label{prerez_sobe}
			\end{figure}

			Enačba \ref{eq:šoba-vA} povezuje spremembo hitrosti tekočine ($\dd v$) s spremembo preseka šobe ($\dd A$). V enačbi \ref{eq:šoba-vA} nastopa tudi M,	
			kar je Machovo število in je po definiciji razmerje med hitrostjo tekočine in zvočno hitrostjo v tej tekočini.
			Machovo število lahko izračunamo z enačbo \ref{eq:Mach}, kjer je $v$ hitrost tekočine in $c$ zvočna hitrost v tej tekočini.
			\begin{equation} \label{eq:Mach}
				M = \frac{v}{c}
			\end{equation}

			Kadar je $M < 1$ je hitrost tekočine manjša od zvočne hitrosti in je prvi del enačbe \ref{eq:šoba-vA} pozitiven. To nam pove,
			da se v primeru zmanjšanja preseka hitrost tekočine poveča.

			Če pa je $M > 1$, tekočina teče z nadzvočno hitrostjo in je prvi del enačbe \ref{eq:šoba-vA} negativen. To nam pove, da se bo s povečanjem preseka
			povečala tudi hitrost tekočine.

			V našem primeru želimo, da tekočina doseže zvočno hitrost ($v = c$) ravno v grlu šobe, kjer je premer najmanjši. Tako bodo vroči plini, ki nastanejo pri reakciji,
			pospeševali do zvočne hitrosti v zožanju šobe in nato pospešili tudi preko zvočne hitrosti, ko se v končnem delu šobe presek spet povečuje.

			\subsection{Potisk}
			Potisk motorja je ena najpomembnejših lastnosti raketnega motorja. Izračunamo ga z enačbo \ref{eq:potisk_1}.\cite{nasa:rocket_thrust}
			\begin{equation} \label{eq:potisk_1}
				F = \dot{m} v_e + (P_e - P_a)A_e
			\end{equation}
			Tu je $v_e$ hitrost izpuhov relativno na raketo, $\dot{m}$ masni tok goriva, $P_e$ tlak plinov, ko zapustijo motor, $P_a$ tlak zunaj motorja (v najinem primeru je to kar atmosferski tlak)
			in $A_e$ površina izhodnega dela šobe.
			Če predpostavimo, da šoba izpušne pline spravi do atmosferskega tlaka, potem je člen $(P_e - P_a)A_e = 0$ in dobimo poenostavljeno obliko enačbe.
			\begin{equation} \label{eq:potisk_2}
				F = \dot{m} v_e
			\end{equation}

			\subsection{Statično testiranje raketnih motorjev}
			Statično testiranje raketnih motorjev je izrednega pomena v razvoju (novih) raketnih motorjev. Pri statičnem testiranju je
			motorju gibanje omejeno tako, da se lahko premika samo po osi, vzporedni s silo potiska, ki jo proizvaja. Motor potiska
			proti silomeru, ki ponavadi digitalne podatke pošilja do računalnika, ki jih shranjuje. Iz teh podatkov dobimo graf potiska
			v odvisnosti od časa. Pri dinamičnih testih je raketni motor nameščen na primerno raketo. Podatke tako dobimo iz merilcev lokacije in pospeška na raketi.
			Statično testiranje je bolj varno, saj lažje nadziramo in zavarujemo okolje okoli testnega mesta, zato sva se tudi midva odločila za tak postopek testiranja.\cite{static_firing}
			\begin{figure}
			\centering
			
			\caption[Shema statičnega testa]{Shema tipičnega statičnega testa.\cite{static_firing}} \label{statičen_test}
			\end{figure}

			Kot prikazuje slika \ref{statičen_test}, je najbolj pogosto raketni motor na vodoravnih tirnicah in potiska v isti smeri.
			Odločila sva se za vertikalno orientacijo motorja in da ta potiska navzdol, saj se nama je to zdelo bolj varno in praktično.
			Problem takšne postavitve je, da sva merila tudi silo teže motorja, ki pa se skozi čas gorenja spreminja. Sprememba teže motorja pa je enaka teži goriva (\SI{0,75}{N}),
			ki je zanemarljiva v primerjavi s potiskom motorja.

			\subsection{Simulacija v openMotor}
			Simulacije so v raketni znanosti zelo pomembno orodje, saj vnaprej povedo lastnosti motorja, ki so ključnega pomena za njegovo izdelavo.
			So tudi veliko bolj varne in bolj ekonomične od statičnega testiranja, kjer lahko motor nevarno in nepopravljivo spodleti.
			Ponavadi vzamejo tudi manj časa. Na žalost pa so v veliko primerih simulacije nepopolne, saj ne upoštevajo vseh pojavov, ki jih opazimo pri pravih raketnih motorjih,
			zato so statični in tudi dinamični testi motorjev nenadomestljiv del procesa njihovega razvoja.

			Odločila sva se za uporabo odprtokodnega programa openMotor, ki je namenjen simuliranju raketnih motorjev na trdno gorivo.
			Program sva naložila s svetovnega spleta.\cite{openMotor}
			OpenMotor najprej inicializira parametre simulacije, kot so lastnosti goriva in dimenzije šobe. Kot gorivo sva uporabila že obstoječi profil KNSU (kalijev nitrat in saharoza), ki je primerljiv z najinim gorivom.
			Potem openMotor simulira gorenje goriva v motorju po majhnih časovnih inkrementih. Najprej izračuna regresijo in masni pretok, tako da iterira skozi vse gorivne celice, ki so postavljene ena za drugo:
			\cite{openMotor}
			\begin{enumerate}
				\item Regresijo goriva izračuna tako, da pomnoži majhen korak v času s hitrostjo gorenja, ki je funkcija tlaka.
					Za tlak uporabi vrednost iz prejšnjega koraka simulacije.
				\item Masni pretok izračuna iz masnih pretokov gorivnih celic nad trenutno.
				\item Maso gorivne celice izračuna iz gostote goriva in regresije, ki je bila izračunana v tem koraku.
				\item Kot zadnji korak doda masni pretok skozi to celico v skupni masni pretok in izračuna novo geometrijo gorivne celice.
			\end{enumerate}

			Nato izračuna vrednost $K_n$, ki je razmerje med površino grla in vso gorenju izpostavljeno površino goriva. Ta vrednost je pomembna,
			saj je funkcija tlaka odvisna zgolj od nje in lastnosti goriva.\cite{openMotor} Potem izračuna tlak v motorju in izhodni tlak.
			Iz teh dveh tlakov izračuna potisk motorja, kot to opisuje enačba \ref{eq:potisk_1}.
			Na koncu izračuna še nanos žlindre na šobo, v najinem primeru \ce{K2CO3} in \ce{KOH}, kot je razvidno iz enačbe \ref{eq:gorjenje-goriva}, in se premakne za en časovni korak naprej. 

			Na koncu vsake iteracije preveri, če reakcija še poteka, in se glede na to odloči, ali naj simulacijo nadaljuje ali konča.
			Ob koncu simulacije openMotor preveri, ali so bile prekoračene vnaprej določene omejitve (npr. največji dovoljeni tlak).
			Na koncu izpiše podatke, izriše grafe in javi vse zaznane napake in opozorila.
			OpenMotor je izjemno orodje za amatersko raketarstvo, saj omogoča lažje in bolj varno načrtovanje raketnih motorjev.

			\subsection{Toplotna kamera}
			Za merjenje temperatur sva uporabljala toplotno kamero Seek ShotPRO. V razponu 233 K do 603 K zaznava z občutljivostjo manj kot 70 mK.
			Prav tako ima visoko resolucijo 320 x 240 (76 800 pikslov). Kamera zaznava dolgovaloven infrardeč spekter, natančneje valovne dolžine med 7,5 in 14 $\mu m$.\cite{seekshotpro_specsheet}
			S funkcijo snemanja sva dobila natančne podatke o spreminjanju temperature s časom. Ker pa ima kamera premajhno merilno območje
			za merjenje temperature izpuha motorja, sva merila predvsem temperaturo zunanje cevi in tako preverila, da se ne pregreva.

		\begin{figure}
		\centering
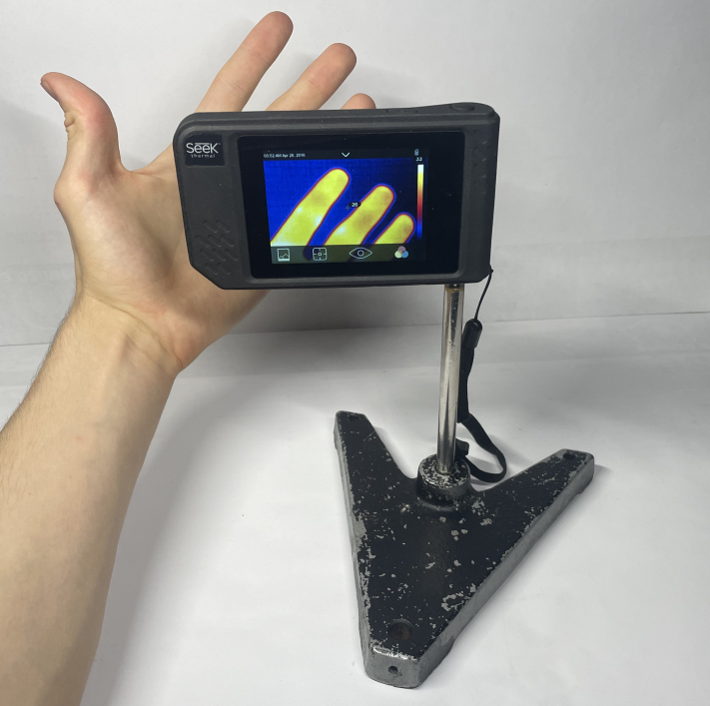
[picture p32: raziskovalna_naloga/slike/topl_roka.png]
		
		\caption{Prikaz toplotne kamere.}
		\end{figure}

			\subsection{Specifičen impulz}
			Impulz ali sunek sile je fizikalna količina, ki spreminja gibalno količino telesa. Izračunamo ga kot spremembo gibalne količine ali kot produkt sile in spremembe časa.
			To lahko zapišemo tudi v diferencialni obliki kot integral sile po času.
			\begin{equation}
				I = F \Delta t = G_1 - G_0 = \int F dt
			\end{equation}
				Iz impulza izpeljemo fizikalno količino, ki jo imenujemo specifični impulz. Ta nam pove razmerje med impulzom motorja in težo goriva.
				\cite{wiki:Specific_impulse2025}
			\begin{equation}\label{eq:ISP}
				I_{SP} = \frac{I}{m \vdot g_0}
			\end{equation}
				Specifični impulz je tudi razmerje med potiskom motorja in tokom teže goriva. To izpeljemo sledeče:
			\begin{align}
				I_{SP} &= \frac{F \Delta t}{m\vdot g_0} \nonumber \\[1em]
				I_{SP} &= \frac{F}{\frac{m}{\Delta t}\vdot g_0} \nonumber \\[1em]
				I_{SP} &= \frac{F}{\dv{m}{t}\vdot g_0} \nonumber \\[1em]
				I_{SP} &= \frac{F}{\dot{m}\vdot g_0} \label{eq:ISP_F}
			\end{align}
			
			Če v enačbo \ref{eq:ISP_F} vstavimo enačbo \ref{eq:potisk_2}, dobimo:
			\begin{equation} \label{eq:ISP_v}
				I_{SP} = \frac{v_e}{g_0}
			\end{equation}
		
			Tej količini sva v raziskovalni nalogi posvetila največ pozornosti.
		
				\subsubsection{Zakaj prav specifični impulz?}
				Specifičen impulz je sorazmeren z učinkovitostjo raketnega motorja in s tem tudi energijskim izkoristkom. Specifični impulz si lahko predstavljamo kot čas gorenja,
				med katerim bo motor, ki vsebuje gorivo s težo \SI{1}{N}, proizvajal potisk \SI{1}{N}. 
				Če imata dva motorja različna specifična impulza in enako maso goriva, bo motor z večjim specifičnim impulzom proizvedel večji sunek sile.\cite{nasa:specific_impulse}
				Za primerjavo so v tabeli \ref{tabela:ISP} navedene vrednosti specifičnega impulza za nekaj različnih raketnih motorjev.
				Specifičen impulz je priročen tudi zato, ker je merjen v sekundah, ki se uporabljajo tako v metričnem kot tudi v imperialnem sistemu. Z njim se da
				tudi oceniti količino goriva, ki je potrebna za določeno hitrosti rakete ($\Delta v$) in s tem za določen manever.
				To naredimo z enačbo Ciolkovskega.\cite{nasa:ideal_rocket_equation}
				\begin{equation} \label{eq:Ciolkovskega}
					\Delta v = v_e \ln{\frac{m_0}{m_1}} = I_{SP} g_0 \ln{\frac{m_0}{m_1}}
				\end{equation}
				$v_e$ je hitrost izpuhov relativno na gibanje rakete, $m_0$ začetna masa rakete in $m_1$ končna masa rakete.
				\begin{table}
					\centering
					\begin{tabular}{lll} 
						\hline
						Raketni motor & Vrsta & $I_{SP}$ [s] \\
						\hline \noalign{\vskip 0.3ex}
						NERVA NRX A6 & Nuklearni & 869 \\ 
						RS-25 & Tekoče gorivo & 453 \\ 
						RD-843 & Tekoče gorivo & 315,5 \\
						Merlin 1D & Tekoče gorivo & 310 \\
						Avio Zefiro 9A & Trdno gorivo & 295,2\\
						Avio Zefiro 23 & Trdno gorivo & 287,5 \\
						Space Shuttle SRB & Trdno gorivo & 250 \\ 
						\hline
					\end{tabular}
					\caption[Primeri specifičnih impulzov]{Primeri že testiranih raketnih motorjev in njihovih specifičnih impulzov.\cite{tabela_specific_impulse}}
					\label{tabela:ISP}
				\end{table}

		\section{Empirični del}
		
			\subsection{Zunanja cev}
			Za ohišje motorja sva uporabljala odtočne cevi iz plastike PP-H (polipropilen homopolimer), ki jih izdeluje podjetje Peštan. Kupila sva jih v trgovini s tehničnim blagom
			in jih razžagala na primerno dolžino - za prve teste izolatorja \SI{4}{cm}, potem \SI{6}{cm} ter \SI{12,5}{cm} za dejanski motor.
			Cev je certificirana s standardom EN 1451.\cite{Katalog_HTPP} Tako bi morala pri temperaturi \SI{353}{K} zdržati, četudi za kratek čas, tlak do \SI{6,0}{MPa}.\cite{EN1451} Kot primerjavo lahko vzamemo tretji test motorja. Temperatura zunanjosti zunanje cevi se med samim izgorevanjem spremeni za pičlih 2 K, iz 280 K do 282 K, kot vidno na slikah \ref{cetrti_temp}.
			Cevi sva izmerila notranji premer \SI{36}{mm} in debelino stene \SI{1.90}{mm}. Ko sva odžagala primerno dolžino cevi, sva plastiko,
			ki je bila natrgana pri žaganju, stopila oziroma odžgala s plamenom. 
			S tem sva cev polepšala, predvsem pa olajšala vstavljanje izolatorja.
			
				\subsubsection{Zaprtje cevi}
				Za pravilno delovanje raketnega motorja je potreben visok tlak, ki pa ni dosežen, če sta konca cevi odprta. Ker želimo tudi, da rezultanta sil na telo v fazi pospeševanja
				oziroma izgorevanja ni enaka nič, ni dovolj le zožanje koncev cevi, eno od strani je potrebno neprodušno zapreti na način, ki zdrži tudi visoke tlake, po možnosti brez
				mehanskih okvar. Za ta namen sva uporabila epoksi smolo, ki sva je v cev vlila toliko, da je ustvarila \SI{1,5}{cm} debelo plast.\cite{matweb_epoxy_cure_resin}
				Ker se epoksi ne spaja dobro s PP-H cevjo,
				sva del, ki sva ga zalila, prej napraskala z brusilnim papirjem granulacije 40.\cite{3m_lse_adhesion} Tako sva zagotovila zareze, v katere se je ujela smola.
				Ko se je strdila, spoj tako ni bil več odvisen od lepljenja na cev,
				ampak od lastnosti spojev cev s cevjo in smola s smolo. 

			\subsection{Izolator}
			Izolator je, sploh v amaterskem raketarstvu, nepogrešljiv del motorja. Da je material primeren za ohišje, mora imeti nizko gostoto
			in tudi tanke plasti morajo biti zmožne prenesti visoke tlake brez deformacij. Navedene lastnosti mora obdržati tudi pri velikih spremembah temperature.
			Ker so takšni materiali redki, težko dostopni oziroma dragi, pogosto niso primerni niti za velike organizacije,
			kaj šele za amaterje. Zato se tako profesionalno kot amatersko uporablja več različnih cenejših materialov v plasteh. Za prenašanje visokih tlakov uporabljava PP-H cev,
			za obvarovanje cevi pred visokimi temperaturami pa risalne liste (papir) z debelino \SI{0,03}{mm}, ki so razrezani na primerne velikosti in vstavljeni v cev
			tako, da tvorijo več plasti debel izolator.\cite{Thermal_conductivity_of_Paper} Skozi testiranje sva prišla do optimalne debeline \SI{1,75}{mm}. 
			Papirnat izolator pri najinem motorju je razdeljen na dva dela za lažje shranjevanje 
			in premikanje gorivnih celic po ulivanju. 

			Pomembno je poudariti, da papir ni edini izolator. Tudi samo gorivo upočasnjuje prehod toplote proti steni motorja,
			vendar pa se ta plast med gorenjem hitro zmanjšuje in večinoma ni zadostna.
			Prav tako je med gorivom in grlom šobe kratek pas cevi, ki bi bil brez papirnatega izolatorja zaščiten le s tanko plastjo mavca in tako izpostavljen
			občutno previsokim temperaturam že od začetka.

			Omeniti je treba tudi, da izolator med izgorevanjem zaradi visokih temperatur razpada, predvsem na elementarni ogljik, kar za naju ni prevelik problem,
			saj ima tudi ta zadovoljive izolacijske sposobnosti.\cite{Thermal_conductivity_of_Carbon}
			Ker sprva nisva vedela kateri izolatorji so primerni oziroma katerega bi lahko uporabila, sva testirala različne. Karton se je pokazal kot zelo obetaven,
			a ker je bilo iskanje lahko dostopnega, ugodnega in zanesljivega vira neuspešno in ker z debelejšimi plastmi nastajajo problemi, kot so gubanje zvitih plasti zaradi prevelike razlike
			v radijih zunanje in notranje ploskve ter opaznejši problem navoja (izolator je enakomerno razporejen toda različno oddaljen od zunanje cevi zaradi začetka in konca zvitja), 
			sva se odločila za relativno ugodno, predvsem pa lahko dostopno alternativo risalnih listov. Ker so večji in debelejši od pisarniškega papirja,
			se nama je zmanjšal tudi čas sestavljanja posameznih motorjev.

				\subsubsection{Prvi test}
				S tem testom sva testirala različne vrste izolatorjev. Preizkusila sva karton, debel nanos tekstilnega lepilnega traku in
				relativno tanek nanos električarskega mavca (isti mavec sva uporabljala za šobe). Imela sva tudi kontrolni model brez izolatorja. Za višino zunanje cevi sva določila \SI{4}{cm}, 
				zato da sva imela testne modele z manj goriva in je tveganje hujših nesreč ostalo minimalno. Testi so tako vsebovali približno 25 gramov goriva vsak.
				Po pričakovanjih se je zunanja cev kontrolnega vzorca med testiranjem vnela in se popolnoma stopila. Enako se je zgodilo z vzorcem z lepilnim trakom.
				Karton je zelo dobro deloval, mavec pa le delno, saj nima dovolj dobrih izolacijskih sposobnosti in
				se je zunanja cev delno stopila. Težava je tudi, da je nanašanje enakomerne, dovolj tanke plasti mavca zahtevno.
				Tako sva kot najboljšo možnost določila karton.

				\begin{figure}
				\centering
				
				\caption[Prvi test (različne vrste izolatorjev)]{Prvi test (različne vrste izolatorjev): karton, tekstilnini lepilni trak, kontrola, cement}
				\end{figure}

				%karton, silver tape, cement, kontrol (4cm x 4, 9. 11. 2025, 11. 11. 2025)
				\subsubsection{Drugi test}
				Da bi se zares prepričala o uporabnosti, sva poiskala nekaj odpadnega kartona in ga preprosto navila v zunanjo cev.
				Debelino sva izmerila in jo potem spreminjala kar s številom navojev. Zunanja cev prvega in drugega 
				se je vsaj malo stopila, tretji pa je ostal nepoškodovan, kot kaže tabela \ref{tabela_drugi_test}. Višina zunanje cevi in mase goriva je ostala enaka kot pri prvem testu. 
				S testom sva dobila boljšo predstavo o potrebni debelini izolatorja, ki je pomembna,
				kot opisano v poglavju \ref{tp_izo}.
				%različne debeline odpadnega kartona (4cm x 3, 11.11. 2025, 12. 11. 2025)

				\begin{table}
					\centering
					\begin{tabular}{llll} 
						\hline
						Število navojev & Debelina [mm] & Masa goriva [g] & Stanje zunanje cevi \\
						\hline \noalign{\vskip 0.3ex}
						5 & 2,9 & 25,5 & malo stopljena \\
						6 & 3,6 & 25,9 & minimalne deformacije \\
						7 & 4,2 & 25,5 & nepoškodovana \\
						\hline
					\end{tabular}
					\caption[Podatki o drugem testu izolatorjev]{Podatki o drugem testu izolatorjev}
					\label{tabela_drugi_test}
				\end{table}

				\begin{figure}
				\centering
				
				\hspace{0.3cm}
				
				\caption{Drugi test (različne debeline kartona): prej in potem.}
				\end{figure}

				\subsubsection{Tretji test}
				Ker je bilo prej omenjeno iskanje vira kartona neuspešno, sva začela s testiranjem papirja kot izolatorja.
				Pojavila se je tudi ideja, da bi posamezne plasti izolatorja spojila skupaj z epoksi smolo, s čimer bi izboljšala 
				strukturno povezanost. Ideja je bila podprta s hipotezo, da bo epoksi smola tudi izboljšala toplotno izolacijo. 
				Opravila sva šest testov, velikosti vzorcev in mase goriva so ostale enake.
				Precenila sva sposobnosti papirja in tako je bilo mnogo testnih primerov popolnoma stopljenih.
				Ugotovila sva tudi, da epoksi ne pripomore k izolacijskim sposobnostim, temveč jih poslabša.\cite{matweb_epoxy_cure_resin}
				Pri tem testu sva temperaturo merila tudi z laserskim termometrom. Če smo pozorni, lahko na slikah \ref {tretji_test_epoksi} na zunanjih ceveh opazimo piko laserja,
				ki je uperjen v zunanjo cev. 
				Merjenje z laserjem sva opustila, saj se je izkazalo za nenatančno, sploh pri merjenju z varnostne razdalje.
				%različne debeline risalnega papirja + epoksi (4cm x 6, 22. 11. 2025, 25. 11. 2025)

				\begin{figure}
				\centering
				
				\hspace{0.3cm}
				
				\caption[Tretji test (različne debeline papirja in epoksi smola)]{Tretji test (različne debeline papirja in epoksi smola): gorenje dveh primerov.}
				\label{tretji_test_epoksi}
				\end{figure}

				\subsubsection{Četrti test}
				Povečala sva debelino izolatorja, dolžino zunanje cevi testnih modelov na \SI{6}{cm} in količino goriva na približno 75 gramov, s čimer sva izboljšala reprezentativnost,
				saj sva podobne dimenzije gorivnih celic uporabila tudi v končni verziji motorja.
				Merila sva tudi temperaturo zunanje cevi s toplotno kamero. Tako sva dobila
				uporabne podatke za izbiranje varne debeline izolatorja, ki so prikazani v tabeli \ref{tabela_četrti_test}.
				%različne debeline risalnega papirje 2.0 (6cm x 4+1, 5. 12. 2025, 8. 12. 2025)ž

				\begin{figure}
				\centering
				
				\hspace{0.3cm}
				
				\caption[Četrti test: primerjava temperature zunanje cevi]{Četrti test: primerjava temperature zunanje cevi takoj po končanem izgorevanju in 80 sekund kasneje.}
				\end{figure}

				\begin{table}[H]
					\centering
					\begin{tabular}{llll} 
						\hline
						Število plasti & Debelina [mm] & Masa goriva [g] & Najvišja dosežena temperatura [K] \\
						\hline \noalign{\vskip 0.3ex}
						8 & 1,3 & 75,4 & 321 \\
						9 & 1,6 & 75,0 & 385 \\
						10 & 1,8 & 75,2 & 312 \\
						11 & 2,0 & 75,4 & 303 \\
						12 & 2,1 & 75,1 & 303 \\
						\hline
					\end{tabular}
					\caption[Podatki o četrtem testu izolatorjev]{Podatki o četrtem testu izolatorjev. \\ (Pri prvem testu opazimo zelo nizko najvišjo doseženo temperaturo, kar je posledica neprimerno pripravljenega (prežganega) goriva.)}
					\label{tabela_četrti_test}
				\end{table}

			\FloatBarrier
			\subsection{Simuliranje motorja}
			Za simuliranje sva se odločila, ker nisva želela prekoračiti zmogljivosti zunanje cevi in ker sva želela oceniti, kakšen potisk lahko pričakujeva od motorja.
			S programom openMotor sva si pomagala tudi pri izbiri količine goriva (\SI{75}{g}), ki sva jo nato uporabila v vseh statičnih testih motorja.
			Že v teoretičnem delu sva omenila profil KNSU, ki obstaja v openMotorju in je po sestavi primerljiv z najinim gorivom.
			Premer luknje v gorivu sva nastavila na \SI{15}{mm}, dolžino \SI{70}{mm} pa sva dobila tako, da sva jo spreminjala, dokler nisva dobila primerne mase (\SI{75}{g}) 
			in tlaka znotraj omejitev cevi.
			Premer grla šobe sva določila kot \SI{10}{mm}, ker sva zaradi varnosti želela ohraniti nizek tlak. Iz simulacije sva dobila podatke o maksimalnem tlaku, ki je \SI{1,11}{MPa}.
			Kot se jasno vidi iz slike \ref{graf_originalen}, naj bi motor proizvedel do približno \SI{100}{N} potiska. Gorenje naj bi trajalo okoli \SI{1,11}{s}.
			
			\begin{figure}
			\centering
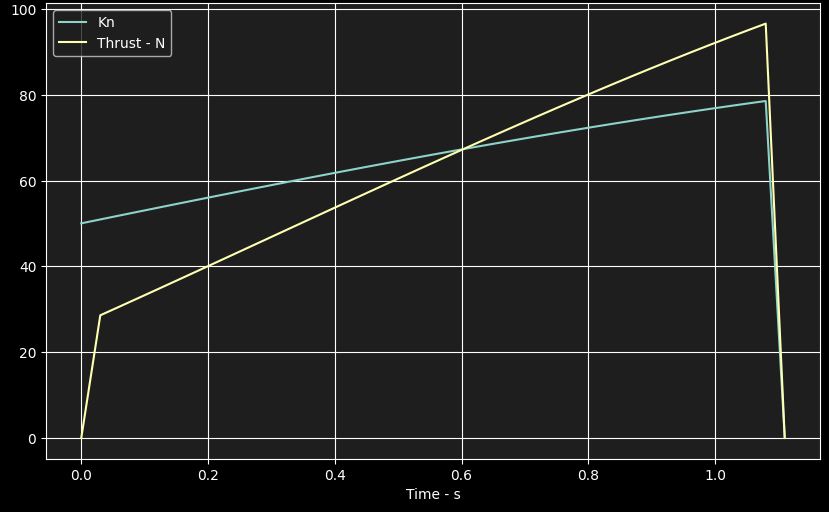
[picture p33: raziskovalna_naloga/slike/graf_originalen.png]
			
			\caption{Simulacija: graf potiska in vrednosti $K_n$ v odvisnosti od časa.}
			\label{graf_originalen}
			\end{figure}

			\subsection{Gorivo} \label{gorivo}
			Raketna goriva so mešanice goriva in oksidatorja zato, da oksidacija ni odvisna od kisika v ozračju. Posledično lahko reakcija poteka tudi v zaprtih posodah. Skupina goriv, v kateri je tudi KNSU,
			je sestavljena iz karbohidrata oziroma sladkorja saharoze in oksidatorja kalijevega nitrata. KNSU sva izbrala, ker je saharoza najcenejši in najdostopnejši karbohidrat. Najboljše razmerje je 65/35 v prid \ce{KNO3},
			a sva se midva odločila za razmerje 60/40, saj sva sicer imela večje težave s pripravo in ulivanjem. Za lažjo predstavo: skozi raziskovalno nalogo sva porabila 2 kg  \ce{KNO3} oziroma pripravila 3,3 kg goriva.
			Pripravljala sva med 100 g in 300 g
			goriva naenkrat, priprava takšne količine pa traja med 60 in 80 minut. Tako lahko ocenimo, da je bilo od 20 do 25 ur dela potrebnih le za pripravo goriva na različne načine.
			Ker je bilo veliko poizkusov priprave ponesrečenih, je bil velik delež tega goriva zavržen.
			Gorivo gori po enčbi \ref{eq:gorjenje-goriva}.

				\subsubsection{Priprava goriva}
				Gorivne celice, ki sva jih uporabljala v motorju, so imele maso \SI{75}{g}. Zaradi izgub pri pripravi in ulivanju začneva s skupno maso goriva \SI{100}{g}.
				Najprej sva odtehtala \SI{40}{g} saharoze in jih stresla v \SI{1}{L} čašo. Ker je za ta proces potrebno, da se vsa saharoza raztopi, sva dodala \SI{20}{g} vode.\cite{wiki:Sucrose}
				Nato sva v čaši segrevala raztopino na električnem grelcu, dokler ni začela vreti. Takrat sva zmanjšala gretje in počasi brez mešanja izparila vso vodo.

				S tem dolgotrajnim postopkom izparevanja vode sva dosegla, da je saharoza neposredno prešla iz raztopljene oblike v tekoče agregatno stanje. To se je zgodilo, ne
				da bi se ta oborila, kar pripomore k homogenosti taline. Ker je segrevanje počasno in kontrolirano, predvsem zaradi vode, ki ima visoko specifično in izparilno toploto,
				je talina zelo blede rjavkaste barve in ne temne karamelne barve, kot sva jo dobila pri poskusih brez vode. Težava z najinimi testi brez vode je bila,
				da se saharoza ni talila enakomerno in je bilo potrebno več časa za pripravo pri višjih temperaturah, kar pa je pomenilo, da se je saharoza bolj karamelizirala; vidno na sliki \ref{gorivna_celica}.
				Talina je tako bila že temne karamelne barve, a so bile v njej še vedno majhne grude nestaljene saharoze. Enaka težava se je pojavila tudi, če sva saharozo fino zmlela v terilnici.
				Barva takega goriva je bila temno rjava ali skoraj črna. Izkazalo se je, da mešanje v fazi izparevanja ni primerno, saj je povzročilo hitro oboritev saharoze.
				Goriva, kjer se je saharoza oborila, ni bilo mogoče več rešiti, saj sva prišla do enake težave kot pri testih brez vode.

				Naslednji korak je bil dodajanje \ce{KNO3}. Preden sva začela segrevati raztopino saharoze, sva zatehtala \SI{60}{g} \ce{KNO3} in ga v terilnici fino zmlela. To sva počela v odduhi oziroma digestoriju,
				saj prašni delci \ce{KNO3} dražijo dihala in oči. Ko se je vrenje upočasnilo in je talina začela dobivati blago barvo, sva začela počasi dodajati \ce{KNO3}.
				To sva počela postopno. Dodala sva približno eno žlico \ce{KNO3} in ga popolnoma vmešala. Pri tem je zelo pomembno, da med dodajanjem mešanico še vedno grejemo na nizki moči.
				V enem od testov se nama je gorivo v tem koraku strdilo, kar je vodilo do komplikacij, saj goriva nisva več mogla spraviti v tekoče stanje, ne da bi ga prežgala. Ko sva dodala ves \ce{KNO3}, je bilo gorivo končano.
				Rezultat je bil 100 g zelo viskozne zmesi, ki ima barvo podobno kristaliziranemu medu, kot je vidno na sliki \ref{gorivna_celica_med}. Postopek priprave goriva je bil najtežji del te raziskovalne naloge,
				ker je zelo nepredvidljiv in vzame veliko časa.

				\begin{figure}
				\centering
				
				
				\caption{Primer ne preveč karamelizirane gorivne celice z notranjim izolatorjem.}
				\label{gorivna_celica_med}
				\end{figure}

				\begin{figure}
				\centering
				
				
				\caption{Primer preveč karamelizirane gorivne celice z notranjim izolatorjem.}
				\label{gorivna_celica}
				\end{figure}

				\subsubsection{Ulivanje goriva}
				Gorivne celice so sestavljene iz goriva in notranjega izolatorja, kot je razvidno iz sheme na slikah \ref{shema_motorja}, \ref{gorivna_celica} in \ref{gorivna_celica_med}.
				Modelčki za vlivanje goriva so narejeni tako, da posnemajo zgradbo pravega motorja. Sestavljata jih zunanja cev in zunanji izolator enake debeline, kot je v motorju.
				V zunanji izolator sva nato vstavila notranji izolator, ki po vlivanju ostane pritrjen na gorivo. Za tako konfiguracijo z dvema izolatorjema sva se odločila
				zaradi lažjega transporta in shranjevanja gorivnih celic.
				Spodnja stran modelčka je zaprta s tekstilnim lepilnim trakom.
				Zaradi visoke viskoznosti goriva ga je bilo nemogoče ulivati, zato sva si pomagala z žlico, da sva ga spravila v modelček.
				Nato sva s plastično epruveto, ki ima premer \SI{15}{mm}, naredila luknjo v gorivo in jo v njem pustila, dokler se ni ohladilo.
				Iz hladnega in dokončno strjenega goriva sva odstranila epruveto in gorivno celico posušila v eksikatorju z uporabo silika gela.
				Gorivo sva transportirala v tesno zaprtih posodah ob prisotnosti silika gela, vse dokler jih nisva vgradila v motor, saj je mešanica nase sposobna vezati vodo iz zraka in se gorivo      tako zelo posabša.

			\begin{figure}
			\centering
			
			\caption{Digestorij (odduha), kjer je pripravljeno vse za pripravo gorivnih celic.}
			\end{figure}
			
			\subsection{Šoba}
			Šoba je pomemben del motorja, saj z omejevanjem in usmerjanjem nekaterih vročih produktov 
			reakcije povzroči potisk, ki pospeši raketo. Šoba prav tako uravnava tlak znotraj motorja, ki je sorazmeren z učinkovitostjo, kot sva opisala v poglavju \ref{soba}. Tako je izpostavljena visokim temperaturam in silam, 
			zaradi česar zanjo niso primerni vsi materiali. Prav tako je uhajanje plinov in drugih produktov reakcije, 
			ki jih le-ti nosijo s sabo, tako nasilno, da pogosto močno erodira površino šobe. 
			Še posebej je na udaru grlo, ki, ko je razširjeno, ne opravlja več svoje funkcije. To se je dogajalo tudi najinim šobam, kar je razvidno s slike \ref{erodirana_šoba}. Ker sva nameravala šobo tudi zalepiti na zunanjo cev, sva že od samega začetka 
			vedela, da bodo šobe za enkratno uporabo. Tako dražji materiali nikoli niso prišli v poštev. 

			Vendar pa imajo tudi dražje alternative svoje slabosti. Čeprav grafit dobro prenaša temperaturo in je lahek, je struženje grafita izjemno umazan proces.
			Nastali grafitni prah je tudi abraziven 
			za vsa vodila stružnice in zanjo zato nevaren.\cite{graphite_machining_damage}
			Zaradi krhkosti je vsakršna obdelava zahtevna, čeprav težje kot mavec tudi erodira.\cite{graphite_properties_brittle} %Mislim da je grafit praktično odporen na erozijo. Glej BPS space
			Kovine so pretežke in imajo prenizka tališča. Njih struženje prav tako vzame veliko časa. Želela sva se držati tudi cilja prostodostopnosti.
			Na idejo nama je prišel cement, ki je pogost material za šobe v amaterskem raketarstvu.
			Ker pa ima cement daljši čas strjevanja in večja zrna, sva se odločila za električarski mavec. Da bi mavec zavzel želeno obliko, pa sva ga ulivala v kalupe.
			ki sva jih sama zmodelirala v odprtokodnem programu za modeliranje FreeCAD in jih je naredil 3D tiskalnik (Bambu Lab A1). Uporabljala 
			sva plastiko PLA (polilaktična kislina), saj je enostavna za tiskanje in dovolj trpežna za najino uporabo. Model je sestavljen iz štirih delov, zato da je šobo kasneje sploh možno dobiti iz modela.

			\begin{figure}
			\centering
			
			\caption[Primerjava sveže in erodirane šobe]{Primerjava sveže (premer grla 10 mm) in erodirane (premer grla 15 mm) šobe}
			\label{erodirana_šoba}
			\end{figure}
			\subsubsection{Ulivanje šob}
			Ulivanje šob je v primerjavi z ulivanjem goriva zelo enostavno. Ko imamo čist kalup, zatehtamo mavec ter vodo in ju zmešamo v razmerju $1/0,7$. Pripravljeno mešanico vlijemo v kalup, 
			kot prikazuje slika \ref{napolnjen_kalup}. Opazimo lahko, da mešanica ne doseže roba kalupa, saj pokrov izpodrine del mešanice. Pravšnja masa mešanice za eno šobo je približno 30 gramov.
			Da šoba nima nepravilnosti zaradi ujetih zračnih mehurčkov, kalup, v katerem je mešanica, večkrat potolčemo ob trdno podlago. Mešanica se strjuje približno 15 minut. Po tem času lahko iz kalupa vzamemo šobo tako, 
			da daljše ploščato kovinsko orodje zataknemo med pokrov in ročaja in na tako ustvarjen vzvod delujemo s silo. Enako naredimo s spodnjim pokrovom kalupa. Potem lahko isto orodje vtaknemo še med ročaja in ju po istem
			principu ločimo. Najina zasnova modela je namenjena pridobivanju nepoškodovanih šob, saj je jemanje iz kalupa zanje najnevarnejše. Če se je šoba dobro strdila jo bomo ven dobili celo, lahko pa se nam tudi razlomi. Pri majhnih šobah je težava tudi, da se oddrobijo njeni tanjši deli. Za šobe sva uporabljala električarski mavec Murexin Gips GI 70, 
			ki je bil, enako kot cevi, kupljen v trgovini s tehničnim blagom.\cite{murexin_gips}

			\begin{figure}
			\centering
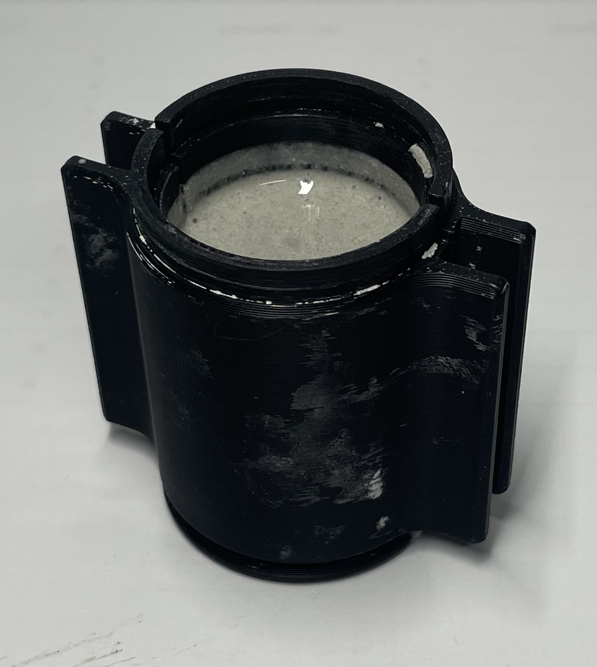
[picture p34: raziskovalna_naloga/slike/model_poln.png]
			
			\caption{Napolnjen kalup}
			\label{napolnjen_kalup}
			\end{figure}

			\begin{figure}
			\centering
			
			\hspace{0.3cm}
			
			\caption{Načrt kalupa za ulivanje šob}
			\end{figure}

			\begin{figure}
			\centering
			
			\hspace{0.3cm}
			
			\hspace{0.3cm}
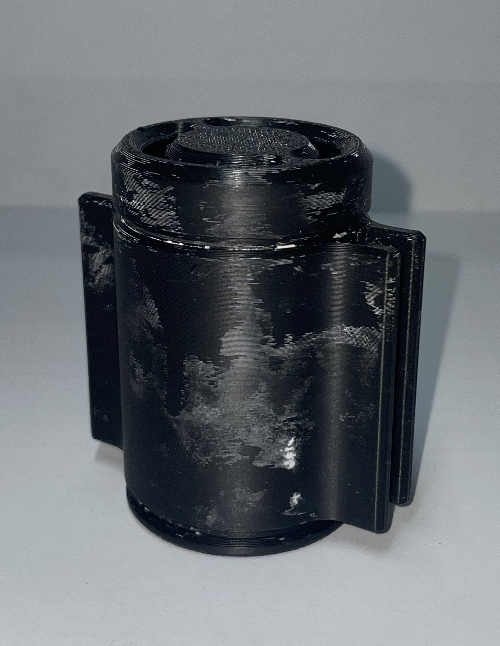
[picture p35: raziskovalna_naloga/slike/model.png]
			
			\caption{Razstavljen 3D tiskan plastičen kalup za ulivanje šob.}
			\end{figure}

			\begin{figure}
			\centering
			\hspace{0.3cm}
			
			\hspace{0.3cm}
			
			\hspace{0.3cm}
			

			\caption{Prikaz šobe brez posameznih kosov modela.}
			\end{figure}

		\subsection{Sestavljanje motorja} \label{sestavljanje_motorja}
		V spodaj napraskano zunanjo cev primerne dolžine nalijemo epoksi smolo, tako da tvori \SI{1,5}{cm} debelo plast. Da se smola ne razlije, odprtino zalepimo s tekstilnim lepilnim trakom. 
		Ko se smola strdi, lahko v zunanjo cev vstavimo izolator, zvit v tulec.
		V tako pripravljeno ohišje potisnemo gorivno celico, ki ima svojo plast izolatorja, in potem v cev, na gorivo, vstavimo šobo.
		Na koncu v prostor med šobo in zunanjo cev s pomočjo kapalke za enkratno uporabo dodamo še epoksi smole. 
		Tako sestavljen motor je po strjevanju smole pripravljen na testiranje. Paziti pa moramo, da ni predolgo izpostavljen kakršnikoli vlagi,
		saj to močno vpliva na hitrost gorenja in izkoristek.

		\begin{figure}
		\centering
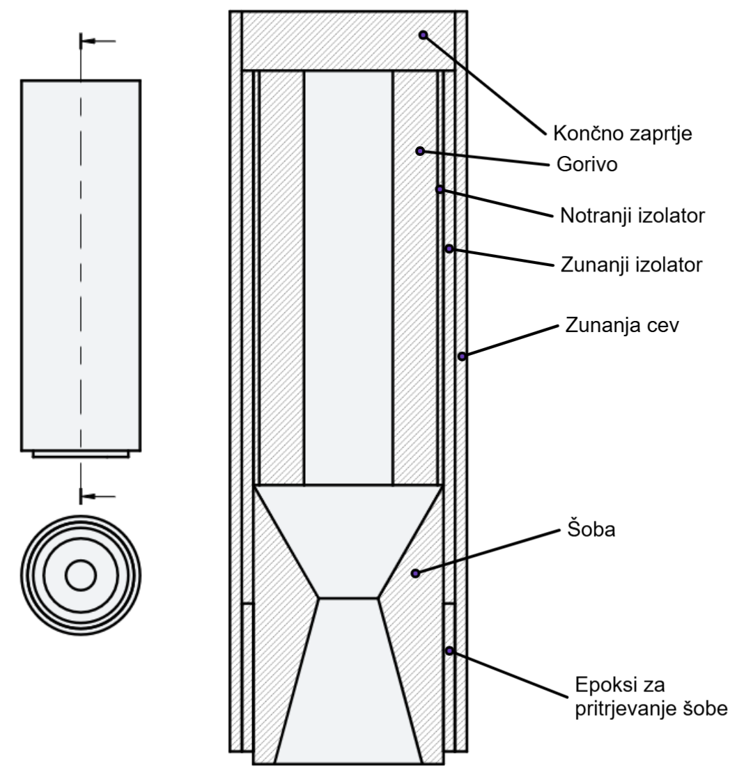
[picture p36: raziskovalna_naloga/slike/QFau_oznacen_final.png]
		
		\caption{Shema motorja.} \label{shema_motorja}
		\end{figure}

		\subsection{Merjenje potiska}
		Za merjenje potiska sva uporabila Vernierjev Force Plate, katerega natančnost je \SI{0,3}{N} na intervalu \SI{-85}{N} do \SI{850}{N} ali \SI{1}{N} na intervalu \SI{-350}{N} do \SI{3500}{N}.
		Ker najini motorji ne proizvedejo več kakor 850N potiska, sva lahko merila z natančnostjo \SI{0,3}{N}. Za držanje motorja sta nama hišnika Gimnazije Vič po najinem načrtu
		izdelala stojalo iz aluminija.
		Stojalo je narejeno iz dveh L-profilov in štirih kotnikov, kot je videno na sliki \ref{stojalo}.
		V aluminijasto ploščo in L-profila so izvrtane luknje in narejeni navoji. Z vijaki so kotniki pritrjeni na ploščo in L-profili na kotnike.
		Za tako držalo sva se odločila, ker varno drži motor med testiranjem ter ne zadržuje tlaka. Držalo je tudi narejeno tako,
		da ima dve reži, skozi kateri lahko termalna kamera meri temperaturo cevi motorja.
		Stojalo sva postavila na Force Plate in se zaščitila s pleksi steklom. Force Plate sva preko Vernirjevega vmesnika povezala z računalnikom,
		na katerem je program LoggerPro beležil in shranjeval podatke o potisku motorja, sproti pa tudi izrisoval graf.

		\begin{figure}
		\centering
		
		\begin{minipage}{0.45\textwidth}
			\centering
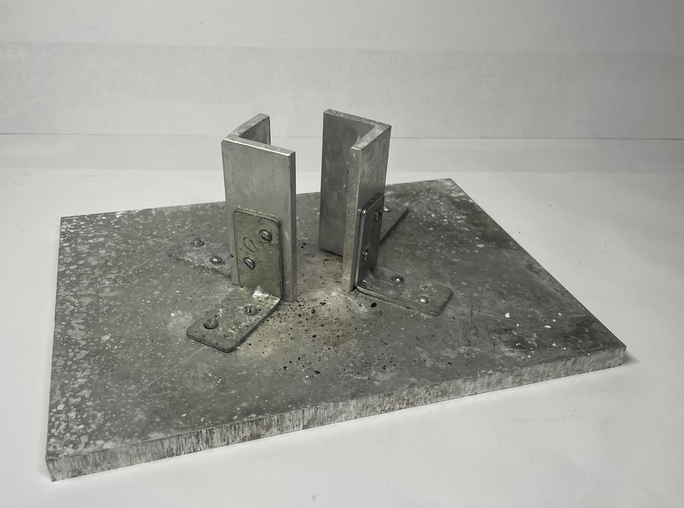
[picture p37: raziskovalna_naloga/slike/stojalo.png]
			
			\hspace{0.3cm}
			
		\end{minipage}
		\hspace{1cm}
		\begin{minipage}{0.45\textwidth}
			\centering
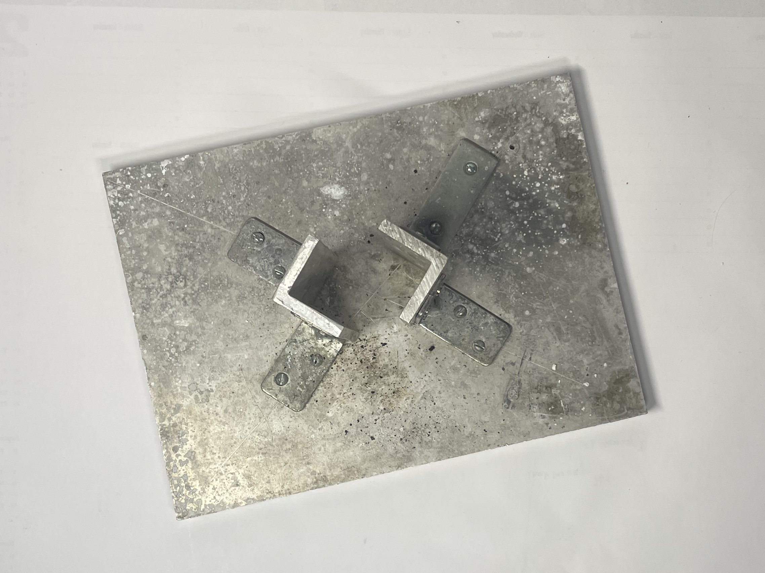
[picture p38: raziskovalna_naloga/slike/stojalo2.png]
			
			\hspace{0.3cm}
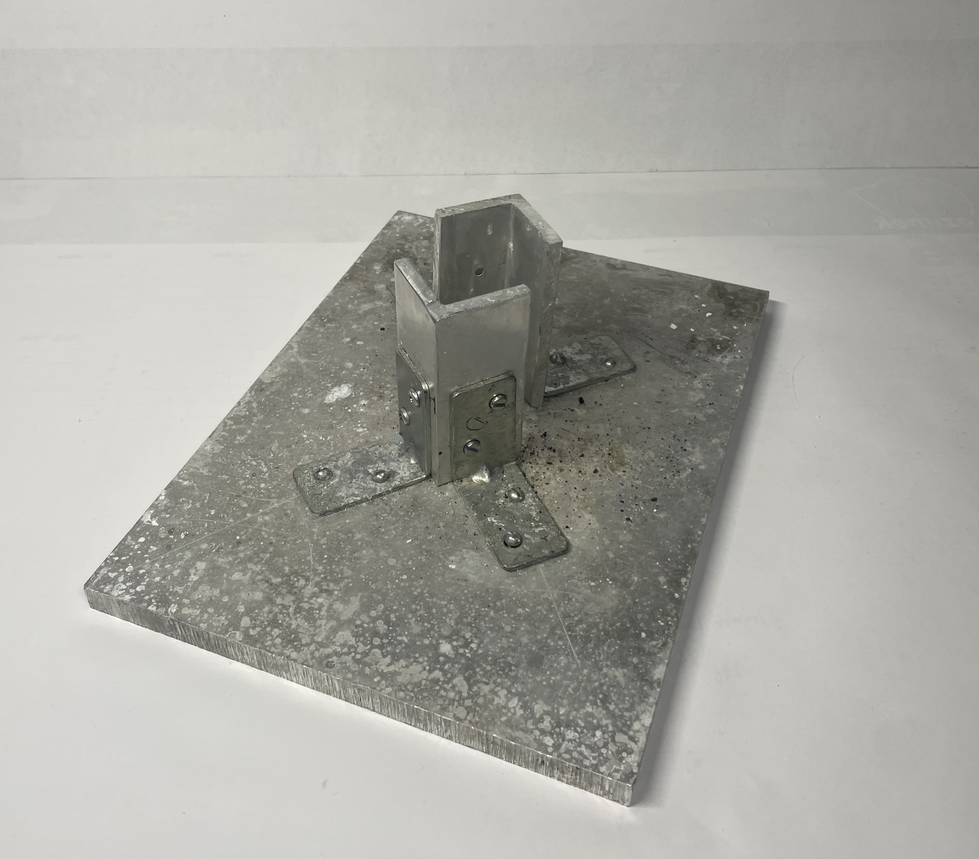
[picture p39: raziskovalna_naloga/slike/stojalo3.png]
			
		\end{minipage}
		
		\caption[Stojalo iz aluminija]{Stojalo iz aluminija iz različnih zornih kotov in prikaz stojala z motorjem}
		\label{stojalo}
		\end{figure}

		\subsection{Vžig motorja}
		Ker bi bil vžig z vžigalico lahko nevaren zaradi potencialne eksplozije, sva se odločila poizkusiti elektronski vžig.
		Za to sva pripravila elektronsko "vžigalico". Izdelala sva jo iz dvožilnega mehkožilnega kabla, tako da sva vzela po eno nit iz vsake žile in ju zvezala.
		Ker se je presek žice močno zmanjšal se je njen upor povečal. To pove sledeča enačba: \cite{wiki:resistance}

			\begin{figure}
			\centering
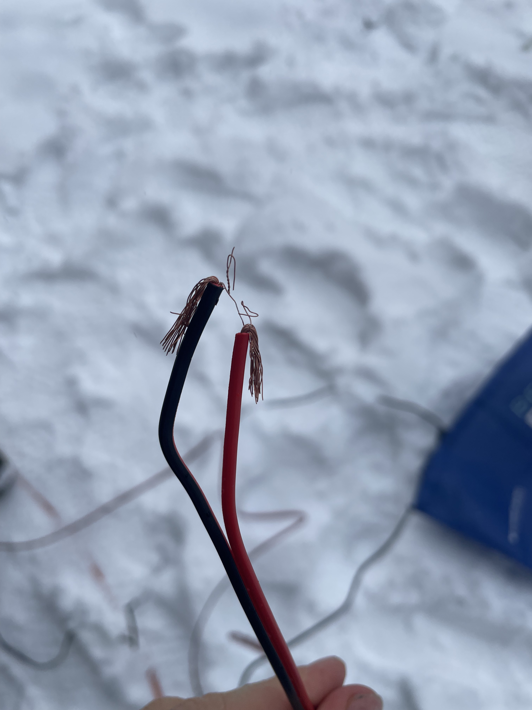
[picture p40: raziskovalna_naloga/slike/zicka.png]
			
			\caption{Žička za elektronski vžig}
			\label{zicka}
			\end{figure}

		\begin{equation}
			R = \frac{\zeta l}{S}
		\end{equation}
		kjer je $R$ upornost, $\zeta$ specifična upornost, $l$ dolžina vodnika in $S$ presek vodnika.
		Iz upornosti lahko izračunamo električno moč: \cite{wiki:joule_heating}
		\begin{equation}
			P = I^2 R
		\end{equation}
		kjer je P moč in I električni tok. V tem primeru je produkt moči in časa enak toploti, ki jo prejme tanka žica vžigalice ($Q = P t$).
		Zaradi nje se vžigalica segreje, kot opiše enačba \ref{eq:toplota}.\cite{openstax_heat}
		\begin{equation} \label{eq:toplota}
			Q = m c \Delta T
		\end{equation}
		kjer je $Q$ toplota, $m$ masa, $c$ specifična toplota in $\Delta T$ sprememba temperature.
		Žica nato segreje gorivo, s katerim je v kontaktu, in ga segreva do temprature vžiga, ki je nad \SI{300}{\degreeCelsius}.\cite{nakkaKNSUchem2025}
		Žica je priklopljena na vir enosmerne napetosti, ki lahko proizvede vsaj \SI{10}{A} toka, ta pa segreje žico, ki vžge gorivo.
		Ta metoda vžiga se je izkazala za relativno neponovljivo. Po premisleku sva prišla do zaključka, da žica ne pride v stik z gorivom ali pa prehitro pregori. Posledično sva bila prisiljena prižgati motor tako, da sva vanj skozi šobo spustila košček gorečega goriva, ki sva ga prižgala z vžigalnikom. %Izboljšava: dodaj kapljo ogriva direktno na žico

		\subsection{Statično testiranje}

			\begin{figure}
			\centering
			
			\caption{Prikaz povezanih pripomočkov za testiranje.}
			\label{setup}
			\end{figure}

		S statičnim testiranjem sva pridobila podatke o potisku motorja, času gorenja in temperaturi zunanje cevi motorja.
		To sva merila z prej opisanim merilnikom sile Force Plate in termalno kamero. Motorje sva vžigala z elektronskim vžigom.
			\subsubsection{Prvi test}
			V prvem statičnem testu sva se namenila testirati samo en motor. Ta je bil sestavljen, kot je opisano v odstavku \ref{sestavljanje_motorja}. Meniva, da je dež zelo slabo vplival na gorenje goriva, saj nisva izmerila nič potiska, oziroma
			potisk, ki sva ga izmerila, ni bil večji od merske napake. Gorenje motorja je bilo tudi vidno manj čisto, kot bi želela. Ta test sva tudi posnela s termalno kamero in potrdila delovanje izolatorja, 
			ki je ohranil zunanjo cev pri nizkih temperaturah.
			V tem testu sva izvedela, kako pomembna je izbira dneva z dobrim vremenom in kako močno vpliva vlaga na kvaliteto delovanja najinega motorja.
			Tu sva tudi opazila pomanjkljivosti vžiga z najinim elektronskim vžigom, ki se je prej izkazal za uspešnega, a nama je zdaj povzročal veliko težav.
			Pokazala se je tudi ena od slabosti z vertikalno orientacijo motorja v stojalu, saj je dež padal naravnost v motor in pripomogel k njegovemu slabšemu delovanju.
			\begin{figure}
			\centering
			
			\caption{Prvo statično testiranje motorja.}
			\end{figure}

			\subsubsection{Drugi test}
			Za drugi test sva izbrala dan s primernejšim vremenom. Pripravila sva tri motorje, enake kot v prvem testu.
			Gorivo v teh testih je bilo slabše kvalitete, saj metode iz odstavka \ref{gorivo} še nisva dokončno razvila.
			Zato je bilo gorivo bolj karamelizirano. V času izdelave motorjev za drugi test se še nisva zavedala, kako katastrofalen vpliv ima vlaga na gorenje goriva.
			Ker gorivnih celic in kasneje sestavljenih motorjev nisva shranjevala v tesno zaprtih posodah ob prisotnosti silika gela,
			predvidevava, da so absorbirali veliko količino vlage. To sva opazila tudi kot nečisto gorenje, primarno pa kot primankljaj potiska.
			Vsi trije motorji niso proizvedli potiska, kot posledica premajhnega tlaka v komori, ki ga je povzročila počasnejša reakcija.
			Kljub težavam s potiskom motorja je izolator varoval zunanjo cev, kot sva pričakovala.

			\subsubsection{Tretji test}
			V tretjem testu sva metodo iz odstavka \ref{gorivo} dodelala do opisanega stanja. To se je izkazalo za neprecenljivo, saj je zelo izboljšalo kvaliteto goriva.
			Gorivne celice in motor sva prav tako začela shranjevati v neprodušno zatesnjenih posodah v prisotnosti silika gela.
			Gorivne celice tretjega testa žal takoj po ulitju nisva dala v eksikator, kot sva kasnejše celice, ampak sva to naredila en dan kasneje.
			Ta je bila zaradi nepremišljenosti z najine strani že vstavljena v cev in se je zato na zadnji strani slabše posušila, kar bi lahko pripomoglo k odklonu
			izmerjenih podatkov od začetne simulacije. Tretji test je bil za razliko od prvega in drugega delno uspešen. Izmerila sva krivuljo potiska, ki je vidna na sliki \ref{graf:potisk}.
			Temperatura površine zunanje cevi je bila tudi pri tem motorju zmerna, kar dokončno potrdi izolativne sposobnosti papirja kot izolatorja v raketnem motorju.
			Večina papirja, kot je vidno na sliki \ref{prerezan}, kjer sva motor iz tretjega testa prerezala po dolžini za analizo, je preživelo visok tlak in temperaturo ekstremnih pogojev v
			raketnem motorju in s tem opravilo svojo nalogo z odliko.
			\begin{figure}
			\centering
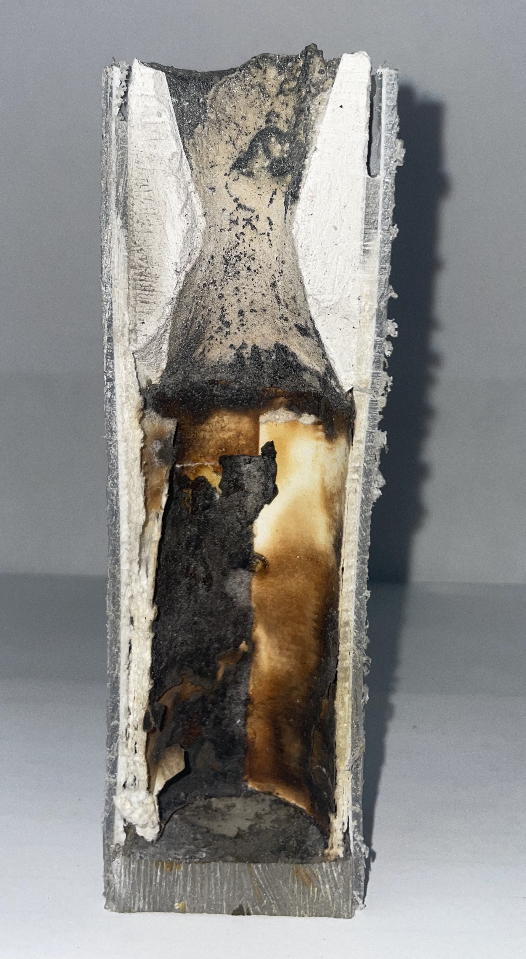
[picture p41: raziskovalna_naloga/slike/pokoncno_prerezan.png]
			
			
			\caption{Prerezan motor tretjega testa.}
			\label{prerezan}
			\end{figure}
		
			\begin{figure}
			\centering
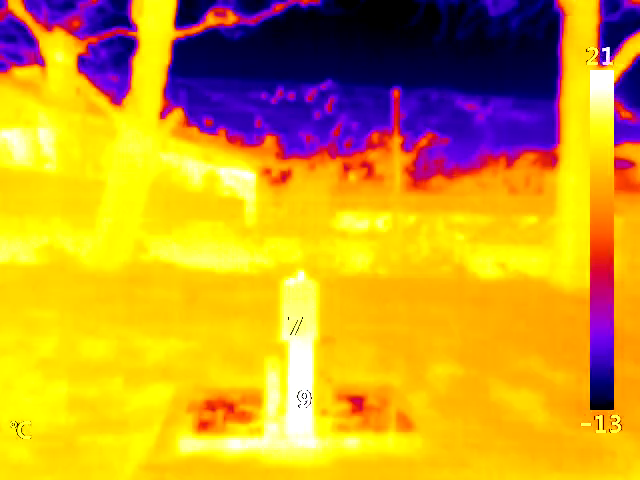
[picture p42: raziskovalna_naloga/slike/tretji_topl_prej.png]
			
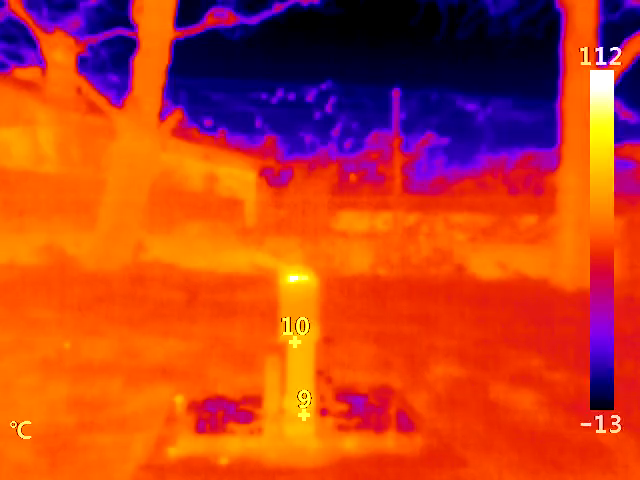
[picture p43: raziskovalna_naloga/slike/tretji_topl_potem.png]
			
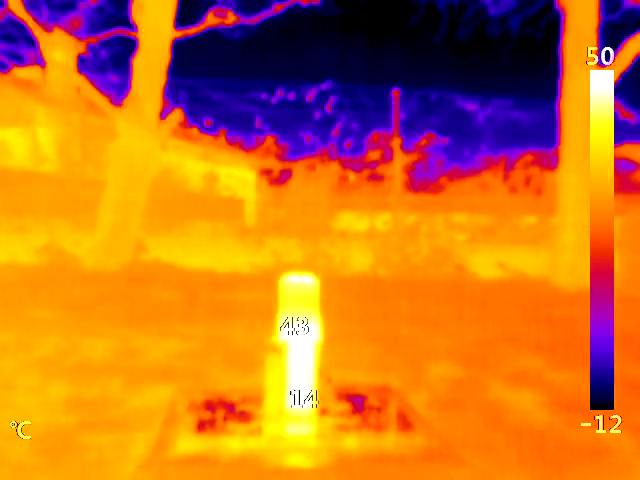
[picture p44: raziskovalna_naloga/slike/tretji_topl_kasnej.png]
			
			\caption[Tretji test: prikaz delovanja izolatorja]{Tretji test: prikaz delovanja izolatorja. Na levi strani vidimo temperaturo zunanje cevi pred vžigom, v sredini takoj po končanem izgorevanju in na desni 30 sekund po koncu izgorevanja}
			\label{cetrti_temp}
			\end{figure}

			\begin{figure}
			\centering
			
			\caption{Tretji test: prikaz motorja med gorenjem.}
			\end{figure}

			Iz prerezanega motorja sva izmerila tudi končni premer grla šobe, ki je \SI{15}{mm}. To je kar \SI{5}{mm} več od začetnega premera, kar nakazuje na močno erozijo šobe in relativno slabo vzdržljivost šob iz mavca.
			To je drugi razlog za neskladnost izmerjenih in v simulaciji izračunanih vrednosti. V prerezu motorja sva tudi dobro videla, da je epoksi smola, tako zaprtje cevi kot tudi ta, ki je držala šobo,
			preživela tlak in temperaturo in ostala praktično nespremenjena.
			\begin{figure}[H]
			\centering
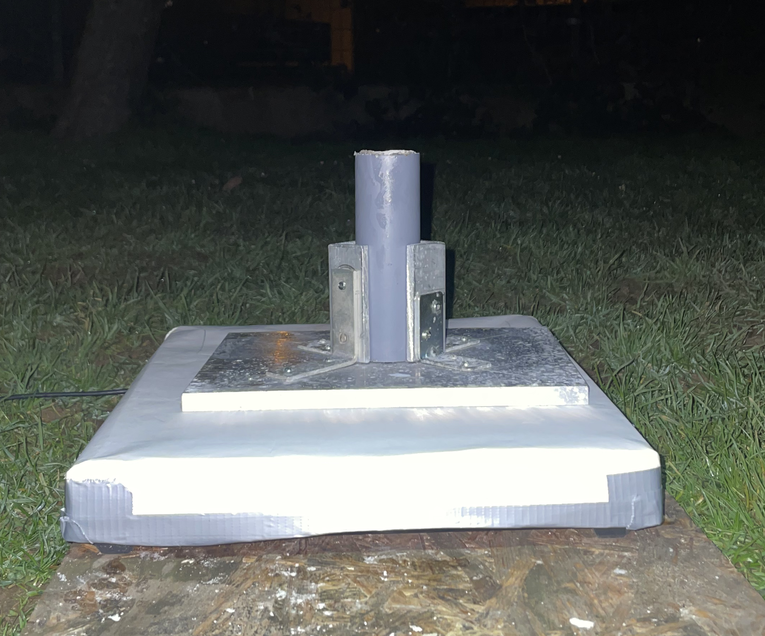
[picture p45: raziskovalna_naloga/slike/tretji_test_motorja.png]
			
			\caption{Tretje statično testiranje motorja}
			\end{figure}

		\subsection{Analiza podatkov}
		Z meritvijo pridobljene podatke sva analizirala v programu Logger Pro verzije 3.16.2, ki nama omogoča funkcije, kot sta integriranje podatkov po času in
		avtomatsko ustvarjanje polinoma, ki se prilega podatkom. Velika večina ostalih verzij programa ni kompatibilnih z Vernierjevim LabPro vmesnikom, ki ga lahko vidimo na sliki \ref{setup}.
		Podatke sva najprej pomaknila navzgor za \SI{1,0}{N}, saj ničla, ki sva jo nastavila ob testiranju, ni bila skladna z resničnostjo.
		Da sva ugotovila, da ničla odstopa za približno 1 N, sva graf zgladila in odčitala, za koliko jo morava dvigniti, kot je lahko vidno na sliki \ref{graf:zglajen}.
		Z zglajenimi podatki sva tudi odčitala največji potisk, ki je \SI{6,3}{N} $\pm$ \SI{0,3}{N}. Motor je vse skupaj gorel približno \SI{3,6}{s} $\pm$ \SI{0,1}{s}.
		Nato sva odsek grafa, kjer je motor proizvajal potisk, integrirala in dobila, da je impulz, ki ga je proizvedel motor tretjega testa, enak \SI{17,26}{Ns} $\pm$ \SI{1,55}{Ns}.
		Kako sva integrirala, je jasno razvidno iz grafa na sliki \ref{graf:integral}.
		Iz impulza in časa gorenja lahko izračunamo povprečno potisno silo motorja:
		\begin{equation}
			\bar{F} = \frac{I}{t} = \frac{\SI{17,26}{Ns} \pm \SI{1,55}{Ns}}{\SI{3,6}{s} \pm \SI{0,1}{s}} = \SI{4,8}{N} \pm \SI{0,6}{N}
		\end{equation}

		Iz enačbe \ref{eq:ISP} sva izračunala tudi specifični impulz.
		\begin{equation}
			I_{SP} = \frac{I}{m \vdot g_0} = \frac{\SI{17,26}{Ns} \pm \SI{1,55}{Ns}}{(\SI{0,075}{kg} \pm \SI{0,001}) \vdot \SI{9.80665}{m/s^2}} = \SI{23,5}{s} \pm \SI{2,3}{s}
		\end{equation}

		Če enačimo enačbi \ref{eq:ISP} in \ref{eq:ISP_v}, dobimo enačbo, s katero lahko izračunamo povprečno izhodno hitrost plinov relativno na raketo.
		\begin{equation}
			\bar{v_e} = \frac{I}{m} = \frac{\SI{17,26}{Ns} \pm \SI{1,55}{Ns}}{\SI{0,075}{kg} \pm \SI{0,001}{kg}} = \SI{230}{m/s} \pm \SI{23}{m/s}
		\end{equation}

		Z enačbo Ciolkovskega \ref{eq:Ciolkovskega} sva izračunala tudi spremembo hitrosti ($\Delta v$), ki nam pove, za koliko se bo hitrost motorja povečala, če nanj ne deluje nobena druga zunanja sila.
		Za $m_0$ sva vzela maso \SI{170}{g} $\pm$ \SI{1}{g} in za $m_1$ sva vzela maso \SI{95}{g} $\pm$ \SI{1}{g}.
		\begin{equation}
			\Delta v = v_e \ln{\frac{m_0}{m_1}} = (\SI{230}{m/s} \pm \SI{23}{m/s})\vdot \ln{\frac{\SI{0,170}{kg} \pm \SI{0,001}{kg}}{\SI{0,095}{kg} \pm \SI{0,001}{kg}}} = \SI{134}{m/s} \pm \SI{17}{m/s}
		\end{equation}

		\begin{figure}
		\centering
		
		\caption{Posnetek zaslona grafa potiska v odvisnosti od časa.} \label{graf:potisk}
		\end{figure}

		\begin{figure}
		\centering
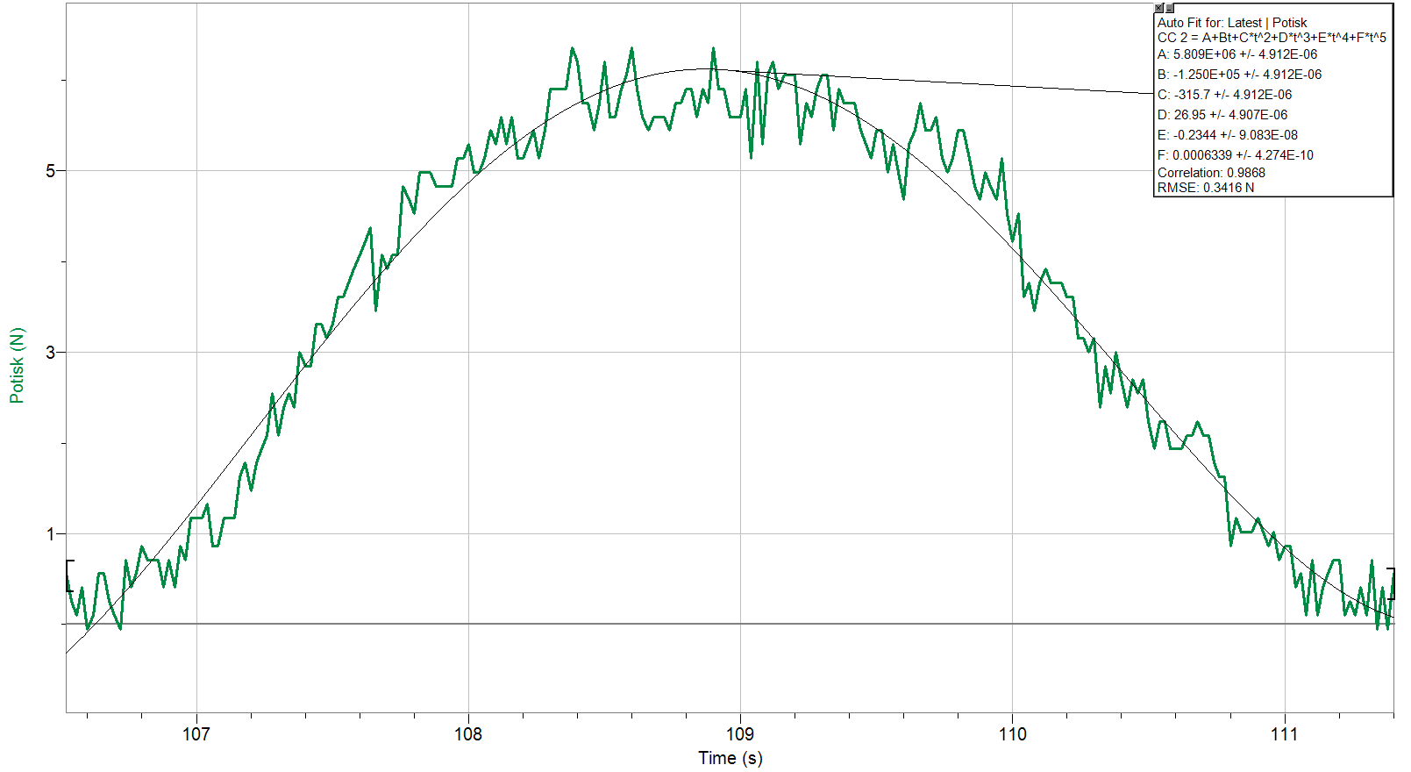
[picture p46: raziskovalna_naloga/slike/potisk_zglajen.png]
		
			\caption{Graf potiska v odvisnosti od časa in zglajeni podatki.} \label{graf:zglajen}
		\end{figure}

		\begin{figure}
		\centering
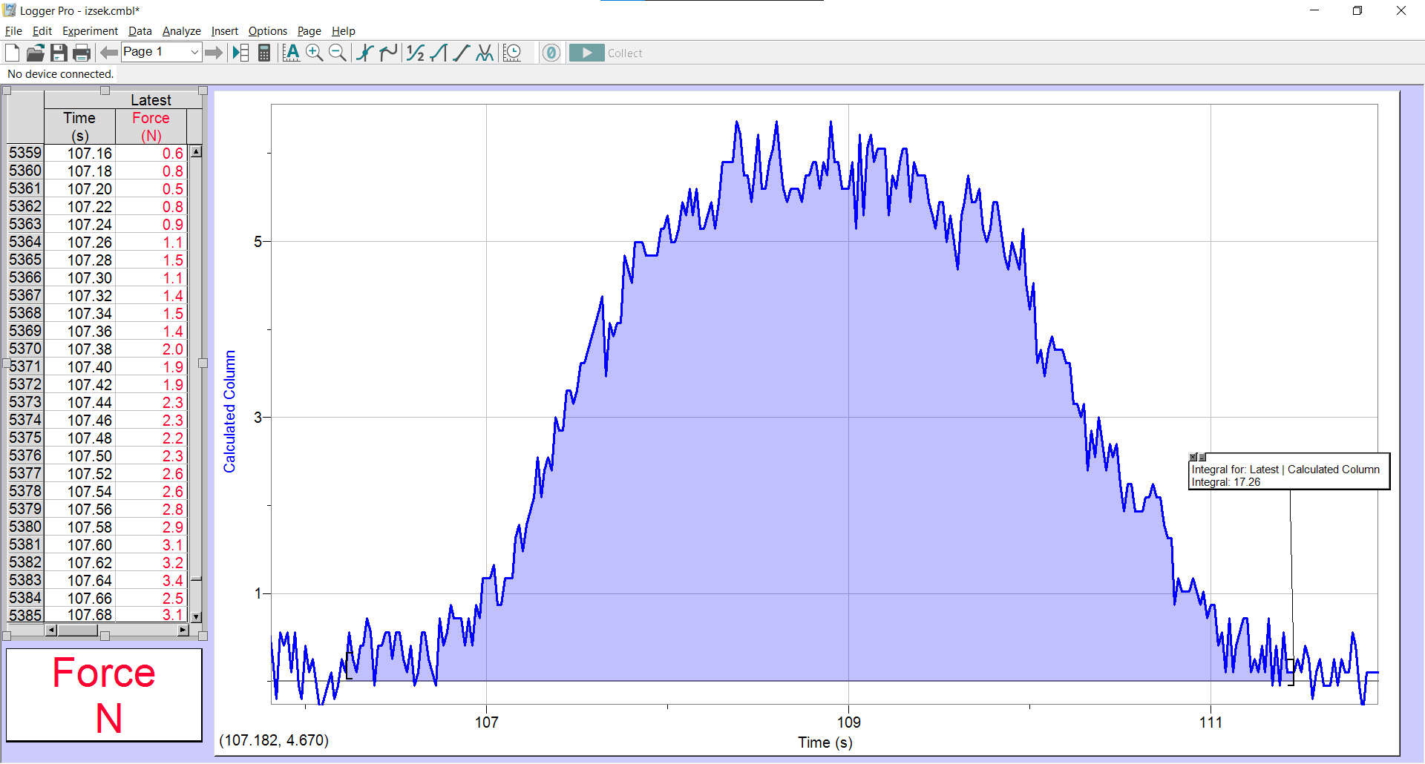
[picture p47: raziskovalna_naloga/slike/integral.png]
		
			\caption{Integral grafa potiska v odvisnosti od časa po času.} \label{graf:integral}
		\end{figure}

		\subsubsection{Prilagajanje simulacije}
		Izkazalo se je, da je motor tretjega testa proizvedel drugačno krivuljo potiska, kot sva jo pričakovala.
		Največji doseženi potisk je bil manjši in čas gorenja daljši. Tako impulz kot tudi specifični impulz sta bila manjša od pričakovanih vrednosti.
		Simulacijo sva se odločila prilagoditi, da bi bolje opisovala pridobljene podatke.
		Najprej sva spreminjala vrednost koeficienta erozije grla ("Throat Erosion Coefficien" v openMotorju), ki v simulaciji določa, kako hitro bodo izpuhi šobo erodirali.
		Z metodo poizkušanja sva prišla do vrednosti \SI[per-mode = symbol]{4,25}{\micro\meter\per\second\per\milli\pascal}, ki se je ujemala z najinimi podatki,
		in sicer se je skozi celo gorenje premer šobe spremenil za \SI{5}{mm}. Zanimivo je, kako linearna je erozija šobe, kar je posledica skoraj konstantnega tlaka.
		Ker simulacije nisva mogla prilagoditi na tak način, da bi v vseh aspektih ponazarjala resničnost, sva se odločila resničnosti približati na dva različna načina.

		Najprej sva nastavila parametre simulacije tako, da je bil največji doseženi potisk enak kot ta, ki sva ga izmerila.
		To sva v glavnem dosegla s spreminjanjem učinkovitosti šobe. Prišla sva do vrednosti 28,7 \%.
		Na sliki \ref{graf:prilagojeno_potisk} je posnetek zaslona, na katerem je graf potiska, erozije šobe in tlaka v komori v odvisnosti od časa, ki ga izriše openMotor.

		Nato sva poskusila prilagoditi simulacijo še na način, da bo impulz motorja enak kot sva ga izmerila pri statičnem testiranju.
		Za to sva spet spreminjala učinkovitost šobe. Prišla sva do vrednosit 33,2 \%.

		Obeh načinov nisva mogla združiti, saj se je najino gorivo obnašalo drugače od profila KNSU v openMotorju. Glavna razlika je bila v času gorenja, ki ga nisva mogla dovolj podaljšati.
		V primeru, ko sva to poizkusila, sva prišla do rezultata, da večina goriva ne zgori, kar pa po najinih meritvah ne drži.

		\begin{figure}
		\centering
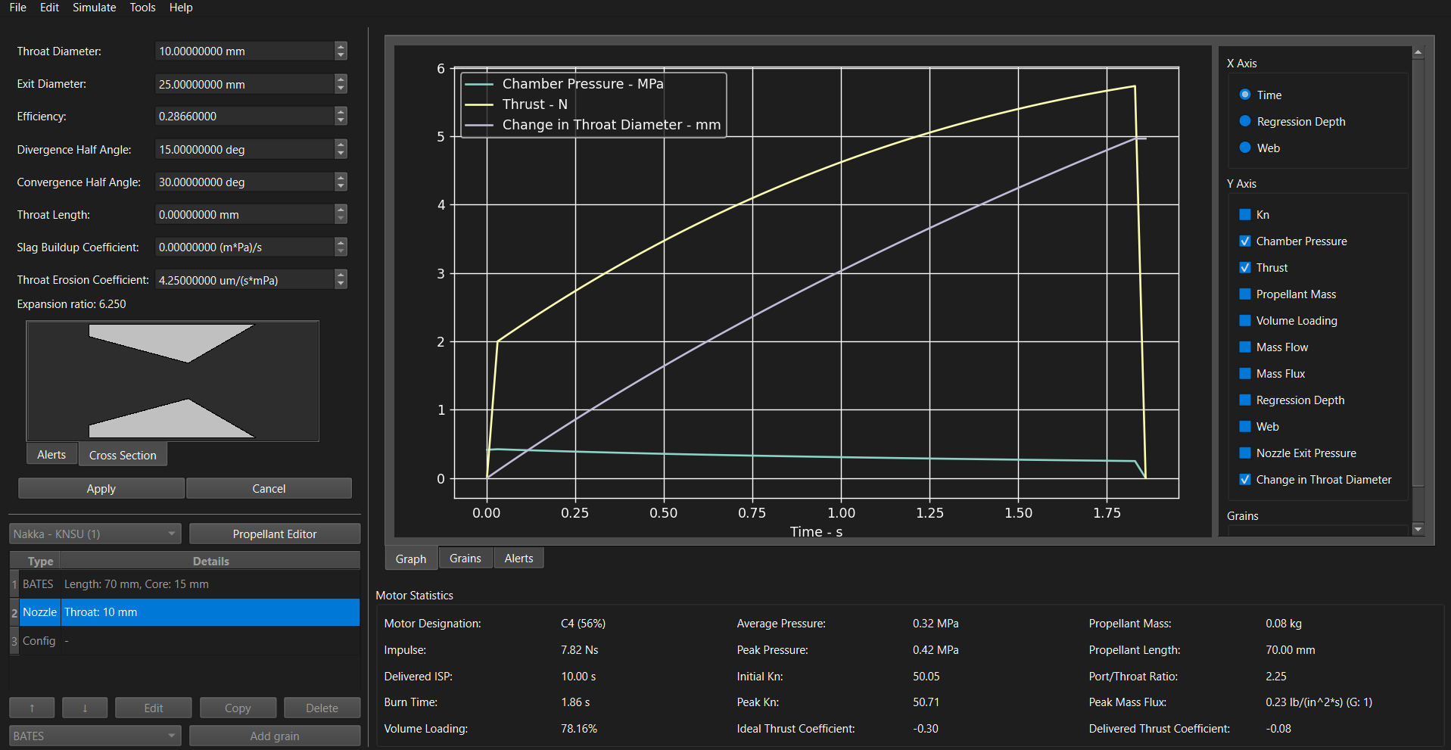
[picture p48: raziskovalna_naloga/slike/prilagojeno_potisk.png]
		
			\caption{Simulacija, prilagojena za pravilen maksimalen potisk.}
			 \label{graf:prilagojeno_potisk}
		\end{figure}

		\begin{figure}
		\centering
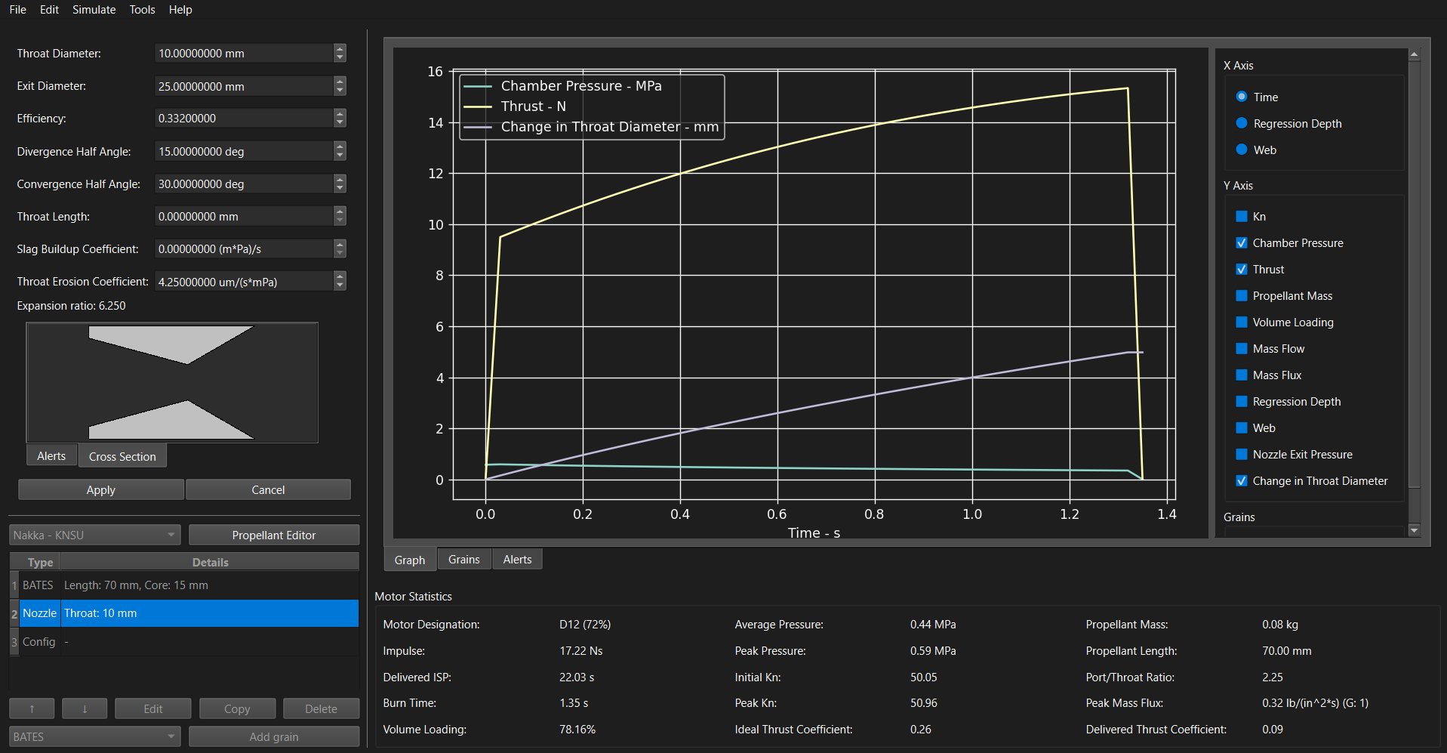
[picture p49: raziskovalna_naloga/slike/prilagojen_impulz.png]
		
			\caption{Simulacija, prilagojena za pravilen impulz.} \label{graf:prilagojen_impulz}
		\end{figure}

		\subsubsection{Neprimernost konvergentno-divergentne šobe}
		Ko sva prilagajala simulacijo, nama je openMotor javil opozorilo na nizek izhodni tlak in možnost odmika izpuhov od strani šobe.
		Po premisleku sva s pomočjo enačbe \ref{eq:šoba-vA} prišla do zaključka, da izpuhi ne dosegajo pravilnih hitrosti v šobi.
		Ker je tlak prenizek, izpuhi v grlu šobe ne dosežejo zvočne hitrosti, kar pomeni, da v divergentnem delu šobe izpuhi
		ne pospešujejo, ampak kvečjemu izgubljajo hitrost, kot nam pravi prej omenjena enačba. Tako sva prišla do zaključka,
		da je KD šoba v tem primeru škodi učinkovitosti motorja in da bi šoba brez divergentnega dela imela boljši izkoristek.
		To sva tudi simulirala in opazila, da se je impulz povečal na \SI{19,64}{Ns}, kar je 14 \% več kot izmerjen impulz
		s KD šobo.

	\section{Rezultati}
	Skozi ustvarjanje te raziskovalne naloge sva prišla do številnih rezultatov, s katerimi sva lahko ovrednotila vse štiri hipoteze.
	Raketni motor, ki sva ga razvila, ima veliko potenciala za izbošanje, a vsaj v zdajšnji obliki ni primerljiv z učinkovitostjo komercialnih motorjev za raketno modelarstvo.
	Proizvedel je \SI{17,26}{Ns} impulza, kar ga uvršča v kategorijo D (10,1 - 20,0 Ns).\cite{wiki:MRMC} Ker je razmerje med potiskom in težo motorja večje od ena (približno 2,8 ob začetku gorenja),
	vemo, da bi ta motor začel pospeševati. Ta motor bi zato lahko bil vgrajen v lahko raketo, ki bi poletela. To je v skladu z najino prvo hipotezo, da je raketni motor na trdno gorivo mogoče narediti iz nizkocenovnih in dostopnih materialov.

	Velik del te naloge je bil posvečen testiranju izolatorjev, kjer sva prišla do rezultata, da je risalni papir debeline \SI{1,75}{mm} primeren izolator za raketne motorje na trdno gorivo.
	Do teh podatkov sva prišla s testiranjem izolatorjev in jih potrdila z vsemi petimi motorji, ki so bili uporabljeni v statičnih testiranjih. To je v skladu s hipotezo 2, da je papir primeren izolator in notranja plast zgorevalne komore raketnih motorjev na trdno gorivo.

	Proces priprave goriva nama je vzel daleč največ časa, saj je bilo potrebno veliko poizkušanja, da sva prišla do deluječe metode. Tudi metoda, do katere sva prišla, je zamudna in ne deluje dobro za večje količine goriva.
	
	Zadnji pomemben del raketnega motorja, ki sva mu namenila čas, je šoba. Šobe, ki sva jih naredila iz mavca, so se izkazale za neprimerne.
	Pri njih sva opazila močno erozijo, zaradi katere je tlak znotraj motorja manj predvidljiv.
	Tako sva hipotezo 3, da šobe iz mavca lahko prenesejo tlak in visoke temperature, ki so jim izpostavljene v motorju, lahko ovrgla.

	Hipotezo 4 lahko delno ovrževa, saj je simulacija potrebovala prilagoditve in še po njih ni mogla točno napovedati pridobljenih podatkov.
	Predvidevava, da je težava v profilu KNSU in v lastnostih najinega motorja. Ta je relativno majhen in ima zelo nizek tlak v zgorevalni komori.
	Najino gorivo je najverjetneje imelo tudi pri tretjem testu težave z vlago. Ugotovila sva, da je pri teh pogojih openMotor nezanesljiv.
	
	\section{Zaključek}
%	V nalogi sva raziskovala energijski izkoristek raketnega motorja na trdno gorivo. Seznanila sva se s teorijo in jo opisala. Motor, ki sva ga ob pomoči literature in raziskovanja opisanega v nalogi zasnovala sama in katerega izdelavo sva 
%podrobno opisala, sva testirala in zbrala meritve. Namen naloge sva izpolnila, prav tako sva ovrednotila hipoteze.
% Veliko sva se naučila tudi o načrtovanju raket. Vse to nama 
%	bo v pomoč pri naslednjih raziskavah in poizkusih, za katere so se nama porodile ideje. Motor se lahko izboljša, uporabi se lahko še druga goriva, z primesmi. Za šobe se lahko uporablja še druge materiale in kombinacije materialov (primer dodatka %jeklene volne v mavec za dodano trdnos), debelina izolatorja se lahko izpopolni. V prihodnosti imava namen izvesti tudi dinamične teste z letalnim računalnikom in izdelati sistem za nadzorovanje leta. %Ideje za nadalno raziskovanje (različna goriva, %različni materiali za šobe, pridobivanje podatkov z dinamičnimi testi, sistem za nadzorovanje leta rakete)

V okviru te raziskovalne naloge sva na podlagi teorije, literature in testiranja zasnovala in razvila raketni motor na trdno gorivo, zgrajen iz dostopnih in nizkocenovnih materialov. Motor sva tudi testirala, proizvedel je impulz 17,26 Ns, kar ga postavi v kategorijo D, in dokazuje, 
da je mogoče izdelati funkcionalen motor tudi z  minimalnimi sredstvi in malo specializirane opreme. Z zaokroževanjem navzgor sva ocenila ceno enega motorja na 115 centov. Omenila bi, da kar 54 centov zneska predstavlja epoksi smola.

Skozi raziskovanje sva hipoteze ovrednotila in prišla do raznih zaključkov. Papir debeline 1,75 mm se je izkazal za učinkovit izolator, šobe iz mavca pa so se zaradi erozije izkazale za dokaj  	.
Simulacije z openMotorjem so zahtevale prilagoditve in niso bile zadostno natančne za nizkotlačne sisteme in za preveč karamelizirana goriva, sploh pa ne podpirajo spreminjanja hitrosti gorenja.

Z raziskovalno nalogo sva pridobila mnogo znanja in izkušenj. Porodile so se nama tudi ideje za izboljšave in nadaljna raziskovanja.
Navedene ideje bi lahko pripomogle k izboljšanju učinkovitosti, zanesljivosti in ponovljivosti amaterskih raketnih motorjev. 

\begin{itemize}
	\item \textbf{Materiali za šobe:} Preizkusiti dodajanje jeklene volne v mavec, ojačanje grla s kovinsko podložko, druge materiale.
	\item \textbf{Oblika šobe:} Raziskati enostavnejšo, konvergentno šobo (brez divergentnega dela), ki bi pri nizkih tlakih lahko povečala izkoristek.
	\item \textbf{Sistem vžiga:} Razviti zanesljivejši sistem elektronskega vžiga z nanosom majhne količine goriva na zvezani žički.
	\item \textbf{Dinamično testiranje:} Vgraditi motor v model rakete in meriti dinamično zmogljivost (pospešek, višino, trajanje leta).
	\item \textbf{Vpliv vlage:} Kvantitativno analizirati vpliv vlažnosti goriva na hitrost gorenja in specifični impulz.
	\item \textbf{Alternativna goriva:} Preizkusiti druga razmerja kalijeveg nitrata /saharoze ali dodatke za izboljšanje učinkovitosti.
	\item \textbf{Izdelava goriva:} Raziskati druge priprave in metode izdelave goriva, poiskati hitrejši način.
\end{itemize}

		Skozi pisanje naloge sva pridobila veliko znanja, izkušenj in idej za prihodne raziskave. Raziskovanje je bilo večinoma zanimivo in zabavno, a tudi naporno.
		Sploh nama je težave delalo gorivo, ki nama je preprečilo večji obseg testiranja in vzelo ogromno časa.
		Vendar pa nameravava v prihodnosti opraviti nadaljne raziskave in jih tudi razširiti, pri tem pa bova podatke in motor s pridom uporabila.

	\printbibliography
	[
	heading=bibintoc,
	title={Literatura}
	]

\end{document}
