qyx22122/projekt-RC/raziskovalna_naloga/EIRMNTG_brez_imen.tex

\documentclass[titlepage, a4paper, twoside, final, 12pt]{article}

\setcounter{secnumdepth}{2} %Globina uštevilčnja naslovov
\setcounter{tocdepth}{3} %Do katere globine bodo naslovi v kazalu

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

\usepackage{fancyhdr}
\pagestyle{fancy}

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

\fancyfoot[C]{\thepage}
\addtolength{\topmargin}{-2.49998pt}

\usepackage{hyperref}
\hypersetup{
	colorlinks=false,
	linktoc=all,
}

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

\graphicspath{{./slike/}}

\addbibresource{./literatura.bib}

\geometry{centering}

\begin{document}

\begin{titlepage}
	\begin{center}
		\vspace*{1cm}
		\huge
		\textbf{Energijski izkoristek raketnega motorja na trdno gorivo}
			
		\vspace{15cm}

		\normalsize
		Raziskovalna naloga s področja fizike.

		2025/2026

	\end{center}
\end{titlepage}

\renewcommand{\thepage}{\Roman{page}}
\renewcommand{\abstractname}{Zahvala}
\begin{abstract}
	\thispagestyle{plain}
	\setcounter{page}{2}
	Zahvalila bi se rada za vso pomoč, ki sva je bila deležna ob raziskovanju in ustvarjanju naloge. 
\end{abstract}

	\renewcommand{\thepage}{\Roman{page}}
		\thispagestyle{plain}
		\setcounter{page}{3}
		\section*{Povzetek}
		V raziskovalni nalogi sva se poglobila v delovanje, simuliranje in testiranje raketnih motorjev na trdno gorivo. V teoretičnem delu sva opisala, na katerih fizikalnih zakonih temeljijo raketni motorji in kakšno funkcijo imajo posamezni deli raketnega motorja na trdno gorivo. Nato sva se lotila razvoja lastnega raketnega motorja na trdno gorivo, ki je narejen iz dostopnih in cenovno ugodnih materialov ter ne potrebuje manj dostopnih strojev, kot sta naprimer stružnica in CNC rezkar. Testirala sva različne vrste in debeline izolatorjev, dokler nisva našla najprimernejšega. S simulacijo sva si pomagala pri načrtovanju šobe in ostalih kritičnih dimenzij motorja, ki sva ga nato tudi sestavila in testirala. Iz pridobljenih podatkov sva potrdila primernost izolatorja in izračunala učinkovitost motorja. Nazadnje sva primerjala izmerjene vrednosti s tistimi iz simulacije, da sva lahko prilagodila parametre simulacije za natančnejše napovedi.

		Ugotovila sva, da je raketo na trdno gorivo mogoče izdelati iz prostodostopnih in nizkocenovnih materialov. Na koncu predlagava še nekaj že ugotovljenih izboljšav in nakaževa možnosti za nadaljnje raziskovanje in testiranje.
		\\[2ex]
		Ključne besede: raketni motor, trdno gorivno, izolator, šoba, specifični impulz

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

	\tableofcontents

	\listoftables

	\listoffigures

	\newpage

	\renewcommand{\thepage}{\arabic{page}}

		\section{Uvod}
		Z razvojem raketne znanosti se je razširilo tudi amatersko raketarstvo in z njim različne velikosti raket, različni materiali in tipi goriva. Skozi čas so
		materiali in znanje postajali vse bolj dostopni. V teh časih vsakdo lahko izdela model rakete, edino vprašanje je izbira materialov,
		porabljen čas in denar, kako varna bo izvedba in kako učinkovit bo motor. Čeprav obstajajo tudi majhni komercialni motorji, sva si želela narediti cenovno ugoden motor.
		Da bi prihranila na opremi, času in denarju nasploh, sva si izbrala najenostavnejše in najcenejše gorivo. Kaj kmalu se nama je porodilo vprašanje
		učinkovitosti in tako so nastali temelji za raziskovalno nalogo. Želela sva dokazati, da je tudi z malo sredstvi in iz
		prostodostopnih materialov mogoče narediti učinkovito in zmogljivo raketo. Tak motor je dostopnejši in posledično na voljo vsem, ki ga želijo uporabiti ali izvesti nadaljne poizkuse.
		Motor sva tudi analizirala, tako iz teoretičnega vidika, kot tudi s statičnim testiranjem.
		
		\subsection{Hipoteze}
		Že na začetku so se nama porodile številne hipoteze, ki sva jih skozi raziskovalno nalogo preizkusila in se na koncu do njih tudi opredelila.
		Postavila sva sledeče hipoteze:
		\begin{enumerate}
				\item Raketni motor na trdno gorivo je mogoče narediti iz nizkocenovnih in dostopnih materialov.
				\item Papir je primeren izolator in notranja plast zgorevalne komore raketnih motorjev na trdno gorivo.
				\item Šobe iz mavca lahko prenesejo tlak in visoke temperature, katerim so izpostavljene v motorju.
				\item Simulacije pridobljene s programom openMotor so primerljive empiričnim podatkom.
		\end{enumerate}

		\section{Varnost}
		Za raketne pogone so značilne eksotermne kemijske reakcije in gorivo, ki ga uporabljava, ni nič drugačno. Ob vžigu gori z izredno vročim plamenom in
		ga je skoraj nemogoče pogasiti, saj gori neodvisno od kisika v ozračju, ker vsebuje oksidator, v najinem primeru \ce{KNO3}.
		Proces gorenja prikazuje enačba \ref{eq:gorjenje-goriva}, kjer med reaktanti ni elementarnega kisika (\ce{O2}).
		Ob nepravilnem ravnanju lahko zelo hitro dobimo tudi hujše opekline. Dober primer je vsuvanje mešanice v prevročo posodo pri pripravi goriva, saj se v tem primeru lahko spontano vžge.
		Kot produkt reakcije se sproščajo plini, ki dražijo oči in dihala. Testiranje v zaprtih prostorih je tako odsvetovano, tudi zaradi tveganja materialne škode.
		Pri prižganju v posodah, kjer omejujemo uhajanje plinov, poteka reakcija zaradi skokovitega naraščanja plinov še hitreje in s tem se tudi tlak dviguje pospešeno.
		To vodi v pozitivno povratno zanko, ki se ponavadi konča z eksplozijo, pri kateri je nevarnost šrapnelov in poškodbe sluha zaradi udarnega vala.

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

		\section{Teoretičeni del}
		Raketni motorji delujejo zaradi zakona o ohranitvi gibalne količine; motor pospeši vroče pline v nasprotno smer gibanja rakete in s tem poveča hitrost rakete.
		Pri raketnih motorjih na trdno grivo ta plin pride iz reakcije goriva in oksidatorja, obeh v trdnem agregatnem stanju. V zgorevalni komori je zaradi tega ustvarjen povišan tlak.
		Vroči plini uhajajo skozi šobo, katere funkcija je izkoriščanje tlaka in temperature teh plinov, da jih pospeši do visokih hitrosti in jim s tem poveča gibalno količino.

			\subsection{Gorivo}
			Vrst trdnih goriv za raketne motorje je zelo veliko, ampak imajo vsa v osnovi podobno sestavo - so mešanica goriva in oksidatorja, potem pa se dodaja še
			katalizatorje in sredstva za strjevanje. Midva sva se odločila za gorivo, ki ga pogosto poimenujejo "rocket candy".
			Ponavadi je sestavljeno iz sladkorja oziroma ogljikovega hidrata (pogosti sladkorji so saharoza, sorbitol in dekstroza) ter kalijevega nitrata (\ce{KNO3}) ter občasno
			tudi nekaterih primesi (npr. \ce{Fe2O3}, ki je katalizator in pospešuje reakcijo).
			Kadar je "rocket candy" narejen iz sladkorja saharoze (\ce{C12H22O11}) in kalijevega nitrata, ga lahko poimenujemo kar s kratico KNSU (\ce{KNO3} in angl. sucrose).
			Po literaturi, ki sva jo našla, je optimalno razmerje saharoze in \ce{KNO3} 35/65 \cite{nakkaKNSU2025}, učinkovitost in hitrost gorjenja goriv pa je sorazmerno povezana s tlakom.\cite{nakka_thrust}
			\\Kemijsko enačbo za gorenje prikazuje enačba \ref{eq:gorjenje-goriva}.\cite{nakkaKNSUchem2025}
			\begin{align} \label{eq:gorjenje-goriva}
			\begin{split} 
					\ce{C12H22O11(s) + 6.288 KNO3(s) ->\\ -> 3.796 CO2(g) + 5.205 CO(g) + 7.794 H2O(g) + 3.065 H2(g) +\\+ 3.143 N2(g) + 2.998 K2CO3(l) + 0.274 KOH(g)}
			\end{split}
			\end{align}

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

			\begin{equation} \label{eq:t.prevodnost}
				P = \frac{\lambda S \Delta T}{d}
			\end{equation}

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

			\subsection{Šoba} \label{soba}
			Šoba je navzven enostaven del raketnega motorja, ki pa je izrednega pomena za pravilno delovanje, saj z omejevanjem in usmerjanjem nekaterih vročih produktov
			reakcije povzroči potisk, ki pospeši raketo.
			Od šobe je odvisen tlak znotraj zgorevalne komore, od katerega je odvisna hitrost rekacije in njena učinkovitost. Šoba določa tudi največji doseženi tlak, katerega morajo zdržati vsi ostali deli motorja.
			Šoba na notranji strani konvergira proti premeru grla
			in nato divergira do izhodnega premera - od tod tudi prideta imeni kovergentno-divergentna oz. KD šoba, poznana tudi kot De Laval šoba.
			Tekočine v taki šobi operirajo v dveh različnih režimih, ki jih opisuje spodnja enačba.\cite{nasa:nozzle_design}
			\begin{equation} \label{eq:šoba-vA}
				(1 - M^2) \frac{\dd v}{v} = - \frac{\dd A}{A}
			\end{equation}

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

			Če pa je $M > 1$, tekočina teče z nadzvočno hitrostjo in je prvi del enačbe \ref{eq:šoba-vA} negativen. To nam pove, da se bo s povečanje preseka
			povečala tudi hitrost tekočine.

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

			\subsection{Potisk}
			Potisk motorja ja ena najpomembnejših lastnosti raketnega motorja. Izračunamo ga z enačbo \ref{eq:potisk_1}.\cite{nasa:rocket_thrust}
			\begin{equation} \label{eq:potisk_1}
				F = \dot{m} v_e + (P_e - P_a)A_e
			\end{equation}
			Tu je $v_e$ hitrost izpuhov relativno na raketo, $\dot{m}$ masni tok goriva, $P_e$ tlak plinov, ko zapustijo motor, $P_a$ tlak zunaj motorja (v najinem primeru je to kar atmosferski tlak)
			in $A_e$ površina izhodnega dela šobe.
			Če predpostavimo, da šoba izpušne pline spravi do atmosferskega tlaka, potem je člen $(P_e - P_a)A_e = 0$ in dobimo poenostavljeno obliko enačbe.
			\begin{equation} \label{eq:potisk_2}
				F = \dot{m} v_e
			\end{equation}

			\subsection{Statično testiranje raketnih motorjev}
			Statično testiranje raketnih motorjev je izrednega pomena v razvoju (novih) raketnih motorjev. Pri statičnem testiranju je
			motorju omejeno gibanje tako, da se lahko premika samo po osi vzporedni s silo potiska, ki jo proizvaja. Motor potiska
			proti silomeru, ki ponavadi digitalne podatke pošilja do računalnika, ki jih shranjuje. Iz teh podatkov dobimo graf potiska
			v odvisnosti od časa. Pri dinamičnih testih je raketni motor nameščen na primerno raketo. Podatke tako dobimo iz merilcev lokacije in pospeška na raketi.
			Statično testiranje je bolj varno, saj lažje nadziramo in zavarujemo okolje okoli testnega mesta, zato sva se tudi midva odločila za tak postopek testiranja.\cite{static_firing}
			\begin{figure}
			\centering
			
			\caption[Shema statičnega testa]{Shema tipičnega statičnega testa.\cite{static_firing}} \label{statičen_test}
			\end{figure}

			Kot prikazuje slika \ref{statičen_test}, je najbolj pogosto raketni motor na vodoravnih tirnicah in potiska v isti smeri.
			Odločila sva se za vertikalno orientacijo motorja in da ta potiska navzdol, saj se nama je to zdelo bolj varno in praktično.
			Problem takšne postavitve je, da sva merivla tudi silo teže motorja, ki pa se skozi čas gorenja spreminja. Sprememba teže motorja pa je enaka teži goriva (\SI{0,75}{N}),
			ki je zanemarljiva v primerjavi z potiskom motorja.

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

			Odločila sva se za uporabo odprtokodnega programa openMotor, ki je namenjen simuliranju raketnih motorjev na trdno gorivo.
			Program sva naložila s svetovnega spleta.\cite{openMotor}
			OpenMotor najprej inicializira parametre simulacije, kot so lastnosti goriva in dimenzije šobe. Kot gorivo sva uporabila že obstoječi profil KNSU (kalijev nitrat in saharoza), ki je primerljiv najinemu gorivu.
			Potem openMotor simulira gorenje goriva v motorju po majhnih časovnih inkrementih. Najprej izračuna regresijo in masni pretok, tako da iterira skozi vse gorivne celice, ki so postavljene ena za drugo:
			\cite{openMotor}
			\begin{enumerate}
				\item regresija goriva; to izračuna tako, da pomnoži majhen korak v času s hitrostjo gorenja, ki je funkcija tlaka.
					Za tlak uporabi vrednost iz prejšnjega koraka simulacije.
				\item Masni pretok, ki ga izračuna iz masnih pretokov gorivnih celic nad trenutno.
				\item Maso gorivne celice; to izračuna iz gostote goriva in regresije, ki je bila izračunana v tem koraku.
				\item Kot zadnji korak doda masni pretok skozi to celico v skupen masni pretok in izračuna novo geometrijo gorivne celice.
			\end{enumerate}

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

			\subsection{Toplotna kamera}
			Za merjenje temperatur sva uporabljala toplotno kamero Seek ShotPRO. V razponu 233 K do 603 K zaznava z občutljivostjo manj kot 70 mK.
			Prav tako ima visoko resolucijo 320 x 240 (78 600 pikslov). Kamera zaznava dolgovaloven infrardeč spekter, natančneje valovne dolžine med 7,5 in 14 $\mu m$.\cite{seekshotpro_specsheet}
			S funkcijo snemanja sva dobila natančne podatke o spreminjanju temperature s časom. Ker pa ima kamera premajhno merilno območje
			za merjenje temperature izpuha motorja, sva merila predvsem temperaturo zunanje cevi in tako preverila, da se ne pregreva.

		\begin{figure}
		\centering
		
		\caption{Prikaz toplotne kamere.}
		\end{figure}

			\subsection{Specifičen impulz}
			Impulz ali sunek sile je fizikalna količina, ki spreminja gibalno količino telesa. Izračunamo ga kot spremembo gibalne količine ali kot produkt sile in spremembe časa.
			To lahko zapišemo tudi v diferencialni obliki,
			kot integral sile po času.
			\begin{equation}
				I = F \Delta t = G_1 - G_0 = \int F dt
			\end{equation}
				Iz impulza izpeljemo fizikalno količino, ki jo imenujemo specifični impulz. Ta nam pove razmerje med impulzom motorja in težo goriva.
				\cite{wiki:Specific_impulse2025}
			\begin{equation}\label{eq:ISP}
				I_{SP} = \frac{I}{m \vdot g_0}
			\end{equation}
				Specifični impulz je tudi razmerje med potiskom motorja in tokom teže goriva. To izpeljemo sledeče:
			\begin{align}
				I_{SP} &= \frac{F \Delta t}{m\vdot g_0} \nonumber \\[1em]
				I_{SP} &= \frac{F}{\frac{m}{\Delta t}\vdot g_0} \nonumber \\[1em]
				I_{SP} &= \frac{F}{\dv{m}{t}\vdot g_0} \nonumber \\[1em]
				I_{SP} &= \frac{F}{\dot{m}\vdot g_0} \label{eq:ISP_F}
			\end{align}
			
			Če v enačbo \ref{eq:ISP_F} vstavimo enačbo \ref{eq:potisk_2} dobimo:
			\begin{equation} \label{eq:ISP_v}
				I_{SP} = \frac{v_e}{g_0}
			\end{equation}
		
			Tej količini sva v raziskovalni nalogi posvetila največ pozornosti.
		
				\subsubsection{Zakaj prav specifični impulz?}
				Specifičen impulz je sorazmeren z učinkovitostjo raketnega motorja in s tem tudi energijskim izkoristkom. Specifični impulz si lahko predstavljamo kot čas gorenja,
				med katerim bo motor, ki vsebuje gorivo s težo \SI{1}{N}, proizvajal potisk \SI{1}{N}. 
				Če imata dva motorja različna specifična impulza in enako maso goriva, bo motor z večjim specifičnim impulzom proizvedel večji sunek sile.\cite{nasa:specific_impulse}
				Za primerjavo so v tabeli \ref{tabela:ISP} navedene vrednosti specifičnega impulza za nekaj različnih raketnih motorjev.
				Specifičen impulz je priročen tudi zato, ker je merjen v sekundah, ki se uporabljajo tako v metričnem kot tudi v imperialnem sistemu. Z njim se da
				tudi oceniti količino goriva, ki je potrebno za določeno hitrosti rakete ($\Delta v$) in s tem za določen manever.
				To naredimo z enačbo Ciolkovskega.\cite{nasa:ideal_rocket_equation}
				\begin{equation} \label{eq:Ciolkovskega}
					\Delta v = v_e \ln{\frac{m_0}{m_1}} = I_{SP} g_0 \ln{\frac{m_0}{m_1}}
				\end{equation}
				Kjer je $v_e$ hitrost izpuhov relativno na gibanje rakete, $m_0$ začetna masa rakete in $m_1$ končna masa rakete.
				\begin{table}
					\centering
					\begin{tabular}{lll} 
						\hline
						Raketni motor & Vrsta & $I_{SP}$ [s] \\
						\hline \noalign{\vskip 0.3ex}
						NERVA NRX A6 & Nuklearni & 869 \\ 
						RS-25 & Tekoče gorivo & 453 \\ 
						RD-843 & Tekoče gorivo & 315,5 \\
						Merlin 1D & Tekoče gorivo & 310 \\
						Avio Zefiro 9A & Trdno gorivo & 295,2\\
						Avio Zefiro 23 & Trdno gorivo & 287,5 \\
						Space Shuttle SRB & Trdno gorivo & 250 \\ 
						\hline
					\end{tabular}
					\caption[Primeri specifičnih impulzov]{Primeri že testiranih raketnih motorjev in njihovih specifičnih impulzov.\cite{tabela_specific_impulse}}
					\label{tabela:ISP}
				\end{table}

		\section{Empirični del}
		
			\subsection{Zunanja cev}
			Za ohišje motorja sva uporabljala odtočne cevi iz plastike PP-H (polipropilen homopolimer) ki jih izdeluje podjetje Peštan. Kupila sva jih v trgovini s tehničnim blagom
			in jih razžagala na primerno dolžino - za prve teste izolatorja \SI{4}{cm}, potem \SI{6}{cm} ter \SI{12,5}{cm} za dejanski motor.
			Cev je certificirana s standardom EN 1451.\cite{Katalog_HTPP} Tako bi morala pri temperaturi \SI{353}{K} zdržati, četudi za kratek čas, tlak do \SI{6,0}{MPa}.\cite{EN1451} Kot primerjavo lahko vzamemo tretji test motorja. Temperatura zunanjosti zunanje cevi se med samim izgorevanjem spremeni za pičlih 2 K, iz 280 K do 282 K, kot vidno na slikah \ref{cetrti_temp}.
			Cevi sva izmerila notrananji premer \SI{36}{mm} in debelino stene \SI{1.90}{mm}. Ko sva odžagala primerno dolžino cevi, sva plastiko,
			ki je bila natrgana pri žaganju, stopila oziroma odžgala s plamenom. 
			S tem sva cev polepšala, predvsem pa olajšala vstavljanje izolatorja.
			
				\subsubsection{Zaprtje cevi}
				Za pravilno delovanje raketnega motorja je potreben visok tlak, ki pa ni dosežen, če sta konca cevi odprta. Ker želimo tudi, da rezultanta sil na telo v fazi pospeševanja
				oziroma izgorevanja ni enaka nič, ni dovolj le zožanje koncev cevi, eno od strani je potrebno neprodušno zapreti na način, ki tudi zdrži visoke tlake, po možnosti brez
				mehanskih okvar. Za ta namen sva uporabila epoksi smolo, katere sva v cev vlila toliko, da je ustvarila \SI{1,5}{cm} debelo plast.\cite{matweb_epoxy_cure_resin}
				Ker se epoksi ne spaja dobro na PP-H cev,
				sva del, ki sva ga zalila, prej napraskala z brusilnim papirjem granulacije 40.\cite{3m_lse_adhesion} Tako sva zagotovila zareze, v katere se je ujela smola.
				Ko se je strdila, spoj tako ni bil več odvisen od lepljenja na cev,
				ampak od lastnosti spojev cev s cevjo in smola s smolo. 

			\subsection{Izolator}
			Izolator je, sploh v amaterskem raketarstvu, nepogrešljiv del motorja. Da je material primeren za ohišje, mora imeti nizko gostoto
			in tudi tanke plasti morajo biti zmožne prenesti visoke tlake brez deformacij. Navedene lastnosti mora obdržati tudi pri velikih spremembah temperature.
			Ker so takšni materiali redki, težko dostopni oziroma dragi, pogosto niso primerni niti za velike organizacije,
			kaj šele za amaterje. Zato se tako profesionalno, kot amatersko uporablja več različnih, cenejših materialov, v plasteh. Za prenašanje visokih tlakov uporabljava PP-H cev,
			za obvarovanje cevi pred visokimi temperaturami pa risalne liste (papir) z debelino \SI{0,03}{mm}, ki so razrezani na primerne velikosti in vstavljeni v cev
			tako, da tvorijo več plasti debel izolator.\cite{Thermal_conductivity_of_Paper} Skozi testiranje sva prišla do optimalne debeline \SI{1,75}{mm}. 
			Papirnat izolator pri najinem motorju je razdeljen na dva dela za lažje shranjevanja 
			in premikanja gorivnih celic po ulivanju. 

			Pomembno je poudariti, da papir ni edini izolator. Gorivo samo tudi upočasnjuje prehod toplote proti steni motorja,
			vendar pa se ta plast med gorenjem hitro zmanjšuje in večinoma ni zadostna.
			Prav tako je med gorivom in grlom šobe kratek pas cevi, ki bi bil brez papirnatega izolatorja zaščiten le s tanko plastjo mavca in tako izpostavljen
			občutno previsokim temperaturam že od začetka.

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

			\FloatBarrier
			\subsection{Simuliranje motorja}
			Za simuliranje sva se odločila, ker nisva želela prekoračiti zmogljivosti zunanje cevi in ker sva želela oceniti, kakšen potisk lahko pričakujeva od motorja.
			S programom openMotor sva si pomagala tudi izbrati količino goriva (\SI{75}{g}), ki sva jo nato uporabila v vseh statičnih testih motorja.
			Že v teoretičnem delu sva omenila profil KNSU, ki obstaja v openMotorju in je po sestavi primerljiv najinemu gorivu.
			Premer luknje v gorivu sva nastavila na \SI{15}{mm}, dolžino \SI{70}{mm} pa sva dobila tako, da sva jo spreminjala, dokler nisva dobila primerne mase (\SI{75}{g}) 
			in tlaka znotraj omejitev cevi.
			Premer grla šobe sva določila kot \SI{10}{mm}, ker sva zaradi varnosti želela ohraniti nizek tlak. Iz simulacije sva dobila podatke o maksimalnem tlaku, ki je \SI{1,11}{MPa}.
			Kot se jasno vidi iz slike \ref{graf_originalen}, naj bi motor proizvedel do približno \SI{100}{N} potiska in gorenje naj bi trajalo okoli \SI{1,11}{s}.
			
			\begin{figure}
			\centering
			
			\caption{Simulacija: graf potiska in vrednosti $K_n$ v odvisnosti od časa.}
			\label{graf_originalen}
			\end{figure}

			\subsection{Gorivo} \label{gorivo}
			Raketna goriva so mešanice goriva in oksidatorja zato, da oksidacija ni odvisna od kisika v ozračju. Posledično lahko reakcija poteka tudi v zaprtih posodah. Skupina goriv, v kateri je tudi KNSU,
			je sestavljena iz karbohidrata oziroma sladkorja saharoze in oksidatorja kalijevega nitrata. KNSU sva izbrala, ker je saharoza najcenejši in najdostopnejši karbohidrat. Najboljše razmerje je 65/35 v prid \ce{KNO3},
			a sva se midva odločila za razmerje 60/40, saj sva sicer imela večje težave s pripravo in ulivanjem. Za lažjo predstavo: skozi raziskovalno nalogo sva porabila 2 kg  \ce{KNO3} oziroma pripravila 3,3 kg goriva.
			Pripravljala sva med 100 g in 300 g
			goriva naenkrat, priprava takšne količine pa traja med 60 in 80 minut. Tako lahko ocenimo, da je med 20 in 25 ur dela bilo potrebnih le za pripravo goriva na različne načine.
			Ker je bilo veliko poizkusov priprave ponesrečenih je velik delež tega goriva bil zavržen.
			Gorivo gori po enčbi \ref{eq:gorjenje-goriva}.

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

				S tem dolgotrajnim postopkom izparevanja vode sva dosegla, da je saharoza neposredno prešla iz raztopljene oblike v tekoče agregatno stanje. To se je zgodilo, ne
				da bi se ta oborila, kar pripomore k homogenosti taline. Ker je segrevanje počasno in kontrolirano, predvsem zaradi vode, ki ima visoko specifično in izparilno toploto,
				je talina zelo blede rjavkaste barve in ne temne karamelne barve, kot sva jo dobila pri poskusih brez vode. Težava z najinimi testi brez vode je bila,
				da se saharoza ni talila enakomerno in je bilo potrebno več časa čakati pri višjih temperaturah, kar pa je pomenilo, da se je ta bolj karamelizirala, kot vidno na sliki \ref{gorivna_celica}.
				Talina je tako bila že temne karamelne barve, a so v njej še vedno bile majhne grude nestaljene saharoze. Enaka težava se je pojavila tudi, če sva saharozo fino zmlela v terilnici.
				Barva takega goriva je bila temno rjava ali skoraj črna. Izkazalo se je, da mešanje v fazi izparevanja ni primerno, saj je povzročilo hitro oboritev saharoze.
				Goriva, kjer se je saharoza oborila, ni bilo mogoče več rešiti, saj sva prišla do enake težave kot pri testih brez vode.

				Naslednji korak je dodajanje \ce{KNO3}. Preden sva začela segrevati raztopino saharoze, sva zatehtala \SI{60}{g} \ce{KNO3} in ga v terilnici fino zmlela. To sva počela v odduhi oziroma digestoriju,
				saj prašni delci \ce{KNO3} dražijo dihala in oči. Ko se je vrenje upočasnilo in je talina začela dobivati blago barvo, sva začela počasi dodajati \ce{KNO3}.
				To sva počela postopno. Dodala sva približno eno žlico \ce{KNO3} in ga popolnoma vmešala. Pri tem je zelo pomembno, da med dodajanjem mešanico še vedno grejemo na nizki moči.
				V enem od testov se nama je gorivo v tem koraku strdilo, kar je vodilo do komplikacij, saj goriva nisva več mogla spraviti v tekoče stanje, ne da bi ga prežgala. Ko sva dodala ves \ce{KNO3} je bilo gorivo končano.
				Rezultat je 100 g zelo viskozne zmesi, ki ima barvo podobno kristaliziranemu medu, kot je vidno na sliki \ref{gorivna_celica_med}. Postopek priprave goriva je bil najtežji del te raziskovalne naloge,
				ker je zelo nepredvidljiv in vzame veliko časa.

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

				\subsubsection{Ulivanje goriva}
				Gorivne celice so sestavljene iz goriva in notranjega izolatorja, kot je razvidno iz sheme na slikah \ref{shema_motorja}, \ref{gorivna_celica} in \ref{gorivna_celica_med}.
				Modelčki za vlivanje goriva so narejeni tako, da posnemajo zgradbo pravega motorja. Sestavlja jih zunanja cev in zunanji izolator enake debeline, kot je v motorju.
				V zunanji izolator sva nato vstavila notranji izolator, ki bo po vlivanju ostal pritrjen na gorivo. Za tako konfiguracijo z dvema izolatorjema sva se odločila
				zaradi lažjega transporta in shranjevanja gorivnih celic.
				Spodnja stran modelčka je zaprta s tekstilnim lepilnim trakom.
				Zaradi visoke viskoznosti goriva ga je bilo nemogoče ulivati, zato sva si pomagala z žlico, da sva ga spravila v modelček.
				Nato sva s plastično epruveto, ki ima premer \SI{15}{mm}, naredila luknjo v gorivo in jo v njem pustila, dokler se ni ohladilo.
				Iz hladnega in dokončno strjenega goriva sva odstranila epruveto in gorivno celico posušila v eksikatorju z uporabo silika gela.
				Gorivo sva transportirala v tesno zaprtih posodah ob prisotnosti silika gela, vse dokler jih nisva vgradila v motor, saj je mešanica nase sposobna vezati vodo iz zraka, in gorivo se tako zelo posabša.

			\begin{figure}
			\centering
			
			\caption{Digestorij (odduha), kjer je pripravljeno vse za pripravo gorivnih celic.}
			\end{figure}
			
			\subsection{Šoba}
			Šoba je pomemben del motorja, saj z omejevanjem in usmerjanjem nekaterih vročih produktov 
			reakcije povzroči potisk, ki pospeši raketo. Šoba prav tako uravnava tlak znotraj motorja, ki je sorazmeren z učinkovitostjo, kot sva opisala v poglavju \ref{soba}. Tako je izpostavljena visokim temperaturam in silam, 
			zaradi česar zanjo niso primerni vsi materiali. Prav tako je uhajanje plinov in drugih produktov reakcije, 
			ki jih le-ti nosijo s sabo, tako nasilno, da pogosto močno erodira površino šobe. 
			Še posebej je na udaru grlo, ki, ko je razširjeno, ne opravlja več svoje funkcije. To se dogaja tudi najinim šobam, kar je razvidno s slike \ref{erodirana_šoba}. Ker sva nameravala šobo tudi zalepiti na zunanjo cev sva že od samega začetka 
			vedela, da bodo šobe za enkratno uporabo. Tako dražji materiali nikoli niso prišli v poštev. 

			Vendar pa imajo tudi dražje alternative svoje slabosti. Čeprav grafit dobro prenaša temperaturo in je lahek, je struženje grafita izjemno umazan proces.
			Nastali grafitni prah je tudi abraziven 
			za vsa vodila stružnice in zanjo posledično nevaren.\cite{graphite_machining_damage}
			Zaradi krhkosti je vsakršna obdelava zahtevna, čeprav težje kot mavec, tudi erodira.\cite{graphite_properties_brittle} %Mislim da je grafit praktično odporen na erozijo. Glej BPS space
			Kovine so pretežke, in imajo prenizka tališča. Njih struženje prav tako vzame veliko časa. Želela sva se držati tudi cilja prostodostopnosti.
			Na idejo nama je prišel cement, ki je pogost material za šobe v amaterskem raketarstvu.
			Ker pa ima cement daljše čase strjevanja in večja zrna, sva se odločila za električarski mavec. Da bi mavec zavzel želeno obliko, pa sva ga ulivala v kalupe.
			ki sva jih sama zmodelirala v odprtokodnem programu za modeliranje FreeCAD in jih je naredil 3D tiskalnik (Bambu Lab A1). Uporabljala 
			sva plastiko PLA (polilaktična kislina), saj je enostavna za tiskanje in dovlj trpežna za najino uporabo. Model je sestavljen iz štirih delov, zato da je šobo kasneje sploh možno dobiti iz modela.

			\begin{figure}
			\centering
			
			\caption[Primerjava sveže in erodirane šobe]{Primerjava sveže (premer grla 10 mm) in erodirane (premer grla 15 mm) šobe}
			\label{erodirana_šoba}
			\end{figure}
			\subsubsection{Ulivanje šob}
			Ulivanje šob je v primerjavi z ulivanjem goriva zelo enostavno. Ko imamo čist kalup, zatehtamo mavec ter vodo in ju zmešamo v razmerju $1/0,7$. Pripravljeno mešanico vlijemo v kalup, 
			kot prikazuje slika \ref{napolnjen_kalup}. Opazimo lahko, da mešanica ne doseže roba kalupa, saj pokrov izpodrine del mešanice. Pravšnja masa mešanice za eno šobo je približno 30 gramov.
			Da šoba nima nepravilnosti zaradi ujetih zračnih mehurčkov, kalup, v katerem je mešanica, večkrat potolčemo ob trdno podlago. Mešanica se strjuje približno 15 minut. Po tem času lahko iz kalupa vzamemo šobo tako, 
			da daljše ploščato kovinsko orodje zataknemo med pokrov in ročaja in na tako ustvarjen vzvod delujemo s silo. Enako naredimo s spodnjim pokrovom kalupa. Potem lahko isto orodje vtaknemo še med ročaja in ju po istem
			principu ločimo. Najina zasnova modela je namenjena pridobivanju nepoškodovanih šob, saj je vzemanje iz kalupa zanje najnevarnejše. Če se je šoba dobro strdila jo bomo ven dobili celo, lahko pa se nam tudi razlomi. Pri majhnih šobah je težava tudi, da se oddrobijo njeni tanjši deli. Za šobe sva uporabljala električarski mavec Murexin Gips GI 70, 
			ki je bil, enako kot cevi, kupljen v trgovini s tehničnim blagom.\cite{murexin_gips}

			\begin{figure}
			\centering
			
			\caption{Napolnjen kalup}
			\label{napolnjen_kalup}
			\end{figure}

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

			\caption{Prikaz šobe brez posameznih kosov modela.}
			\end{figure}

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

		\begin{figure}
		\centering
		
		\caption{Shema motorja.} \label{shema_motorja}
		\end{figure}

		\subsection{Merjenje potiska}
		Za merjenje potiska sva uporabila Vernierjev Force Plate, katerega natančnost je \SI{0,3}{N} na intervalu \SI{-85}{N} do \SI{850}{N} ali \SI{1}{N} na intervalu \SI{-350}{N} do \SI{3500}{N}.
		Ker najini motorji ne proizvedejo več kakor 850N potiska sva lahko merila z natančnostjo \SI{0,3}{N}. Za držanje motorja sta nama hišnika Gimnazije Vič po najinem načrtu
		izdelala stojalo iz aluminija.
		Stojalo je narejeno iz dveh L-profilov in štirih kotnikov, kot je videno na sliki \ref{stojalo}.
		V aluminijasto ploščo in L-profila so bile izvrtane luknje in narejeni navoji. Z vijaki so bili kotniki pritrjeni na ploščo in L-profili na kotnike.
		Za tako držalo sva se odločila, saj varno drži motor med testiranjem ter vidno ne pomaga k zadrževanju tlaka. Držalo je tudi narejeno tako,
		da ima dve reži, skozi kateri lahko termalna kamera meri temperaturo cevi motorja.
		Stojalo sva postavila na Force Plate in se zaščitila s pleksi steklom. Force Plate sva preko Vernirjevega vmesnika povezala na računalnik,
		na katerem program LoggerPro beleži in shranjuje podatke o potisku motorja, sproti pa tudi izrisuje graf.

		\begin{figure}
		\centering
		
		\begin{minipage}{0.45\textwidth}
			\centering
			
			\hspace{0.3cm}
			
		\end{minipage}
		\hspace{1cm}
		\begin{minipage}{0.45\textwidth}
			\centering
			
			\hspace{0.3cm}
			
		\end{minipage}
		
		\caption[Stojalo iz aluminija]{Stojalo iz aluminija iz različnih zornih kotov in prikaz stojala z motorjem}
		\label{stojalo}
		\end{figure}

		\subsection{Vžig motorja}
		Ker bi bil vžig z vžigalico lahko nevaren zaradi potencialne eksplozije, sva se odločila poizkusiti elektronski vžig.
		Za to sva pripravila elektronsko "vžigalico". Izdelala sva jo iz dvo žilnega mehkožilnega kabla, tako da sva vzela po eno nit iz vsake žile in ju zvezala skupaj.
		Ker se je presek žice močno zmanjša se njen upor poveča. To pove sledeča enačba: \cite{wiki:resistance}

			\begin{figure}
			\centering
			
			\caption{Žička za elektronski vžig}
			\label{zicka}
			\end{figure}

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

		\subsection{Statično testiranje}

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

			\subsubsection{Drugi test}
			Za drugi test sva izbrala dan s primernejšim vremenom. Pripravila sva tri motorje, enake kot v prvem testu.
			Gorivo v teh testih je bilo slabše kvalitete, saj metode iz odstavka \ref{gorivo} še nisva dokončno razvila.
			Zato je bilo gorivo bolj karamelizirano. V času izdelave motorjev za drugi test se še nisva zavedala, kako katastrofalen vpliv ima vlaga na gorenje goriva.
			Ker gorivnih celic in kasneje sestavljenih motorjev nisva shranjevala v tesno zaprtih posodah v prisotnosti silika gela,
			predvidevava, da so absorbirali veliko količino vlage. To sva opazila tudi kot nečisto gorenje, primarno pa kot primankljaj potiska.
			Vsi trije motorji so proizvedli nič potiska, kot poslidica premajhnega tlaka v komori, ki ga je povzročila počasnejša reakcija.
			Kljub težavam s potiskom motorja je izolator varoval zunanjo cev, kot sva pričakovala.

			\subsubsection{Tretji test}
			V tretjem testu sva metodo iz odstavka \ref{gorivo} dodelala do trenutnega stanja. To se je izkazalo za neprecenljivo, saj je zelo izboljšalo kvaliteto goriva.
			Gorivne celice in motor sva prav tako začela shranjevati v neprodušno zatesnjenih posodah v prisotnosti silika gela.
			Gorivne celice tretjega testa žal takoj po ulitju nisva dala v eksikator, kot sva kasnejše celice, ampak sva to naredila en dan kasneje.
			Ta je bila zaradi nepremišljenosti iz najine strani že vstavljena v cev in se je zato na zadnji strani slabše posušila, kar bi lahko pripomoglo k odklonu
			izmerjenih podatkov od začetne simulacije. Tretji test je bil za razliko od prvega in drugega delno uspešen. Izmerila sva krivuljo potiska, ki je vidna na sliki \ref{graf:potisk}.
			Temperatura površine zunanje cevi je tudi pri tem motorju bila zmerna, kar dokončno potrdi izolativne sposobnosti papirja kot izolatorja v raketnem motorju.
			Večina papirja, kot je vidno na sliki \ref{prerezan}, kjer sva motor iz tretjega testa prerezala po dolžini za analizo, je preživelo visok tlak in temperaturo ekstremnih pogojev v
			raketnem motorju in s tem opravilo svojo nalogo z odliko.
			\begin{figure}
			\centering
			
			
			\caption{Prerezan motor tretjega testa.}
			\label{prerezan}
			\end{figure}
		
			\begin{figure}
			\centering
			
			
			
			\caption[Tretji test: prikaz delovanja izolatorja]{Tretji test: prikaz delovanja izolatorja. Na levi strani vidimo temperaturo zunanje cevi pred vžigom, v sredini takoj po končanem izgorevanju in na desni 30 sekund po koncu izgorevanja}
			\label{cetrti_temp}
			\end{figure}

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

			Iz prerezanega motorja sva izmerila tudi končni premer grla šobe, ki je \SI{15}{mm}. To je kar \SI{5}{mm} več od začetnega premera, kar nakazuje na močno erozijo šobe in relativno slabo vzdržljivost šob iz mavca.
			To je drugi razlog za neskladnost izmerjenih in v simulaciji izračunanih vrednosti. V prerezu motorja sva tudi dobro videla, da je epoksi smola, tako zaprtje cevi kot tudi ta, ki je držala šobo,
			preživela tlak in temperaturo in ostala praktično nespremenjena.
			\begin{figure}[H]
			\centering
			
			\caption{Tretje statično testiranje motrja}
			\end{figure}

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

		\subsubsection{Prilagajanje simulacije}
		Izkazalo se je, da je motor tretjega testa proizvedel drugačno krivuljo potiska, kot sva jo pričakovala.
		Največji doseženi potisk je manjši in čas gorenja je daljši. Tako impulz kot tudi specifični impulz sta manjša od pričakovanih vrednosti.
		Simulacijo sva se odločila prilagoditi, da bo bolje opisovala pridobljene podatke.
		Najprej sva spreminjala vrednost koeficienta erozije grla ("Throat Erosion Coefficien" v openMotorju), ki v simulaciji določa, kako hitro bodo izpuhi šobo erodirali.
		Z metodo poizkušanja sva prišla do vrednosti \SI[per-mode = symbol]{4,25}{\micro\meter\per\second\per\milli\pascal}, ki je se je ujemala z najinimi podatki,
		in sicer se je skozi celo gorenje premer šobe spremenil za \SI{5}{mm}. Zanimivo je, kako linearna je erozija šobe, kar je posledica skoraj konstantnega tlaka.
		Ker simulacije nisva mogla prilagoditi na tak način, da bi v vseh aspektih ponazarjala resničnost, sva se odločila resničnosti približati na dva različna načina.

		Najprej sva nastavila parametre simulacije tako, da je bil največji doseženi potisk enak kot ta, ki sva ga izmerila.
		To sva v glavnem dosegla s spreminjanjem učinkovitosti šobe. Prišla sva do vrednosti 28,7 \%.
		Na sliki \ref{graf:prilagojeno_potisk} je viden posnetek zaslona, na katerem je graf potiska, erozije šobe in tlaka v komori v odvisnosti od časa, ki ga izriše openMotor.

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

		Obeh načinov nisva mogla združiti, saj se najino gorivo obnaša drugače od profila KNSU v openMotorju. Glavna razlika je bila v času gorenja, ki ga nisva mogla dovolj podaljšati.
		V primeru, ko sva to poizkusila, sva prišla do rezultata, da večina goriva ne zgori, kar pa po najinih meritvah ne drži.

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

		\subsubsection{Neprimernost kovergentno-divergentne šobe}
		Ko sva prilagajala simulacijo, nama je openMotor javil opozorilo za nizek izhodni tlak in možnost odmika izpuhov od strani šobe.
		Po premisleku sva s pomočjo enačbe \ref{eq:šoba-vA} prišla do zaključka, da izpuhi ne dosegajo pravilnih hitrosti v šobi.
		Ker je tlak prenizek, izpuhi v grlu šobe ne dosežejo zvočne hitrosti, kar pomeni, da v divergentnem delu šobe izpuhi
		ne pospešujejo, ampak kvečjemu izgubljajo hitrost, kot nam pravi prej omenjena enačba. Tako sva prišla do zaključka,
		da je KD šoba v tem primeru škodi učinkovitosti motorja in da bi šoba brez divergentnega dela imela boljši izkoristek.
		To sva tudi simulirala in opazila, da se je impulz povečal na \SI{19,64}{Ns}, kar je 14 \% več kot izmerjen impulz
		s KD šobo.

	\section{Rezultati}
	Skozi ustvarjanje te raziskovalne naloge sva prišla do številnih rezultatov, s katerimi sva lahko ovrednotila vse štiri hipoteze.
	Raketni motor, ki sva ga razvila, ima veliko potenciala za izbošanje, a vsaj v zdajšnji obliki ni primerljiv s učinkovitostjo komercialnih motorjev za raketno modelarstvo.
	Proizvedel je \SI{17,26}{Ns} impulza, kar ga uvršča v kategorijo D (10,1 - 20,0 Ns).\cite{wiki:MRMC} Ker je razmerje med potiskom in težo motorja večje od ena (približno 2,8 ob začetku gorenja),
	vemo, da bi ta motor začel pospeševati. Ta motor bi zato lahko bil vgrajen v lahko raketo, ki bi poletela. To je v skladu z najino prvo hipotezo, da je raketni motor na trdno gorivo mogoče narediti iz nizkocenovnih in dostopnih materialov.

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

	Proces priprave goriva nama je vzel daleč največ časa, saj je bilo potrebno veliko poizkušanja, da sva prišla do deluječe metode. Tudi metoda, do katere sva prišla, je zamudna in ne deluje dobro za večje količine goriva.
	
	Zadnji pomemben del raketnega motorja, ki sva mu namenila čas, je šoba. Šobe, ki sva jih naredila iz mavca, so se izkazale za neprimerne.
	Pri njih sva opazila močno erozijo, zaradi katere je tlak znotraj motorja manj predvidljiv.
	Tako sva hipotezo 3, da šobe iz mavca lahko prenesejo tlak in visoke temperature, katerim so izpostavljene v motorju, lahko ovrgla.

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

Skozi raziskovanje sva hipoteze ovrednotila in prišla do raznih zaključkov. Papir debeline 1,75 mm se je izkazal za učinkovit izolator, šobe iz mavca pa so se zaradi erozije izkazale za dokaj neprimerne.
Simulacije z openMotorjem so zahtevale prilagoditve in niso bile zadostno natančne za nizkotlačne sisteme in za preveč karamelizirana goriva, sploh pa ne podpirajo spreminjanja hitrosti gorenja.

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

	\printbibliography
	[
	heading=bibintoc,
	title={Literatura}
	]

\end{document}
