qyx22122/projekt-RC/raziskovalna_naloga/predstavitev_kompresirana.pdf

Uvod | Sestava motorja | Simuliranje | Testiranje izolatorjev | Statično testiranje | Analiza podatkov | Zaključek | Dodatna Gradiva

# Energijski izkoristek raketnih motorjev na trdno gorivo

# Tibor Maček, 2. letnik Leon Smrekar Voskobojnik, 2. letnik

Mentor: Jure Ausec, univ. dipl. fiz.

| Gimnazija Vič
| 2026
Tibor Maček, Leon Smrekar Voskobojnik | Gimnazija Vič
Energijski izkoristek raketnih motorjev na trdno gorivo

# Leteča raketa

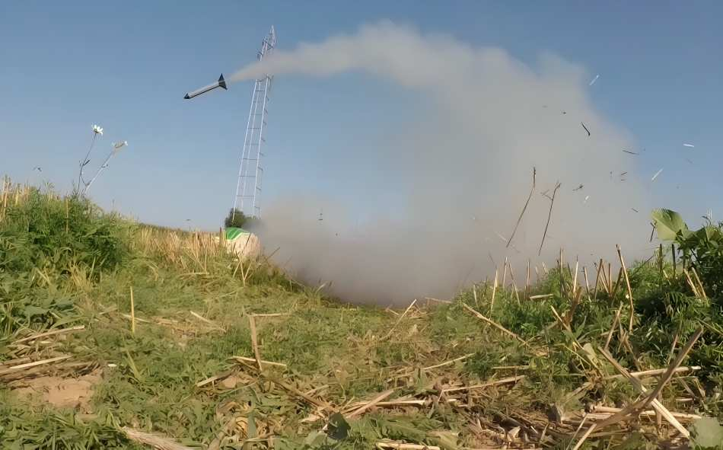
[picture p50: figure]

# Staljena raketa

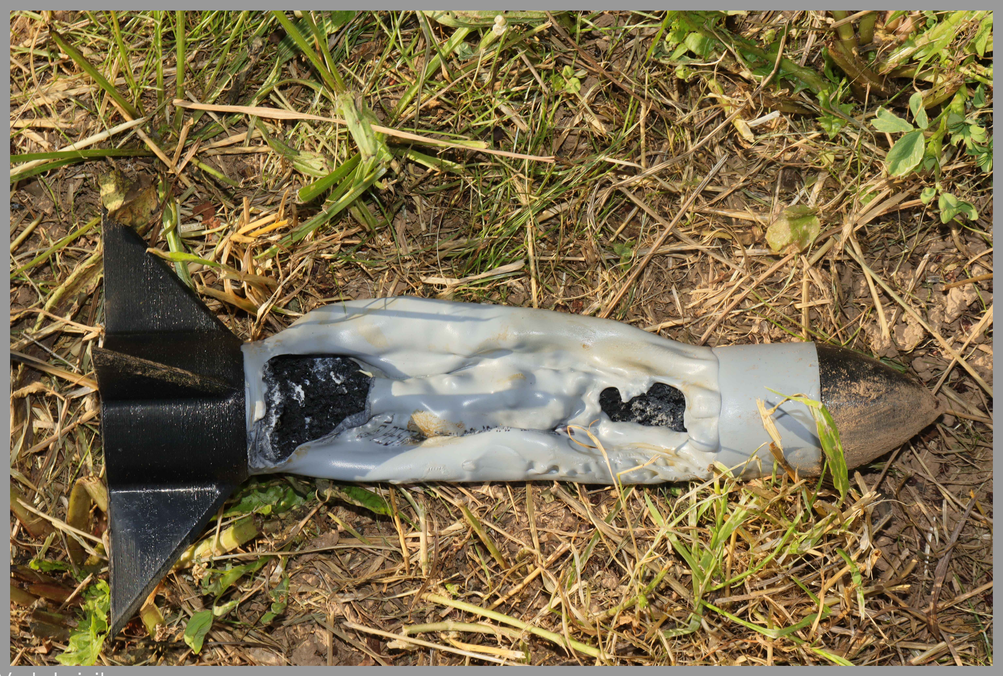
[picture p51: figure]

# Sestava motorja

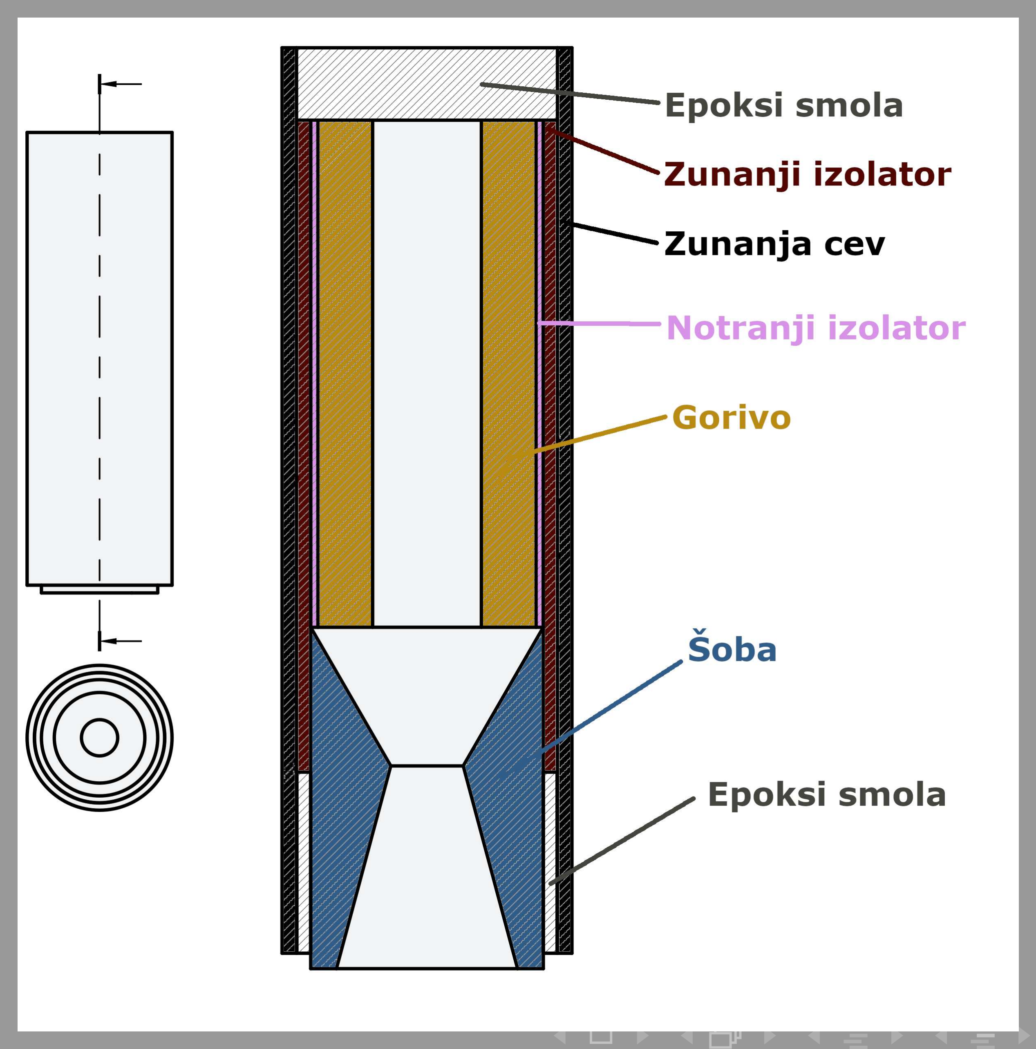
[picture p52: figure]

# 1 Zunanja cev

## Notranji premer 36 mm Debelina stene 1,9 mm Dolžina 125 mm

# 2 Izolator

## Debelina 1,75 mm

# 3 Gorivna celica

## Masa 75 g 60 : 40 KNO3 : C12H22O11

# 4 Soba ˇ

## Masa 30 g Premer grla 10 mm

# Simuliranje v programu openMotor

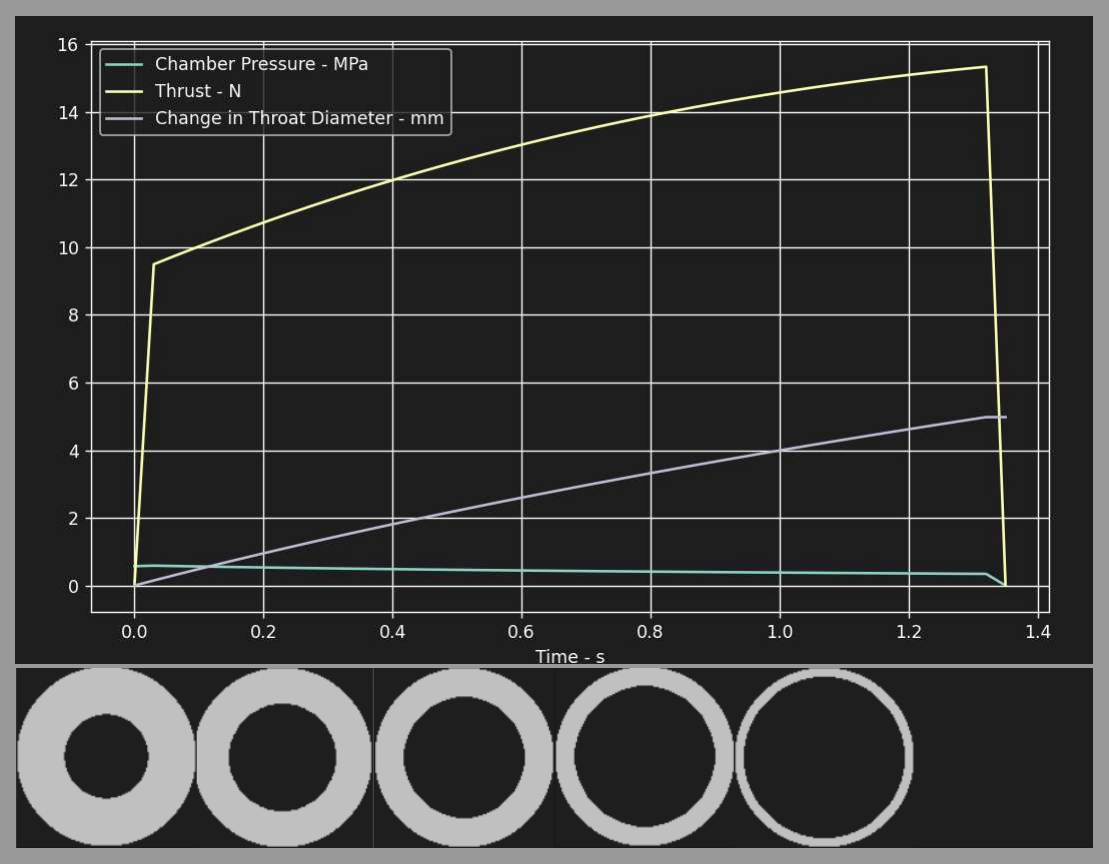
[picture p53: figure]

## Slika: Graf in regresija goriva - posnetek zaslona programa openMotor

# Prvi in drugi test izolatorjev

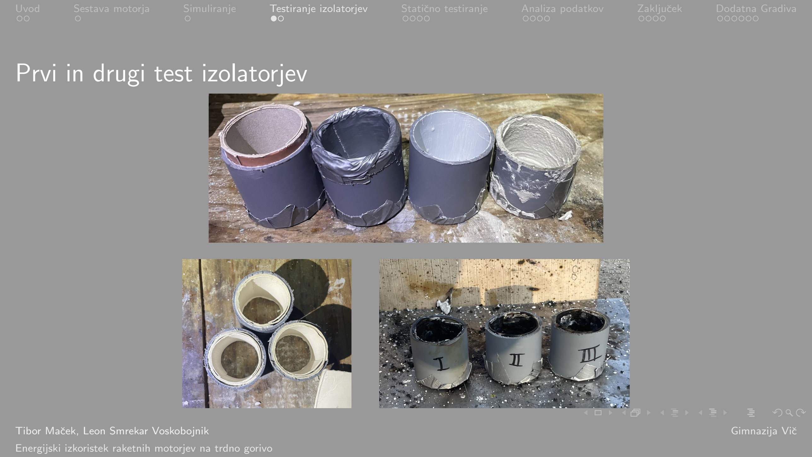
[picture p54: page 6]

# Tretji in četrti test izolatorjev

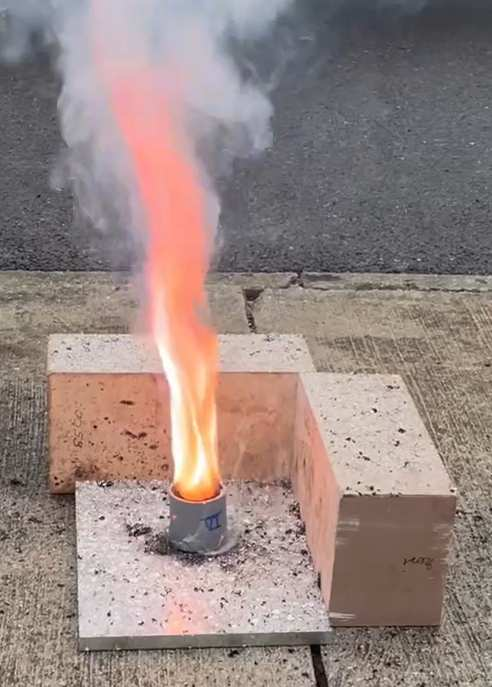
[picture p55: figure]
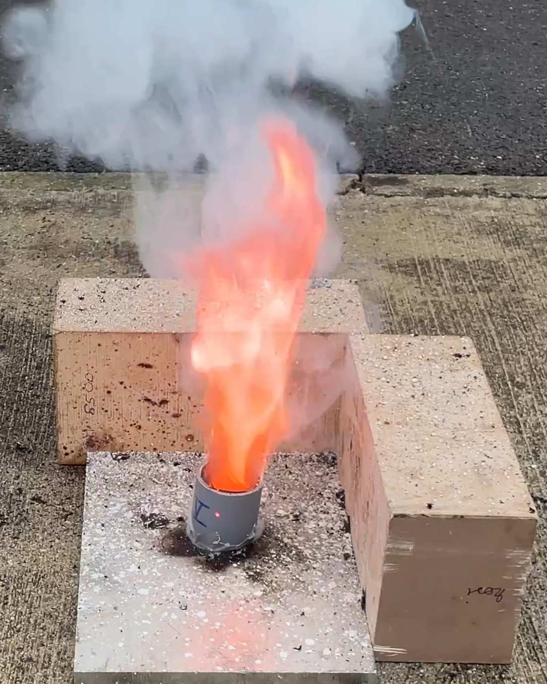
[picture p56: figure]

# Statično testiranje

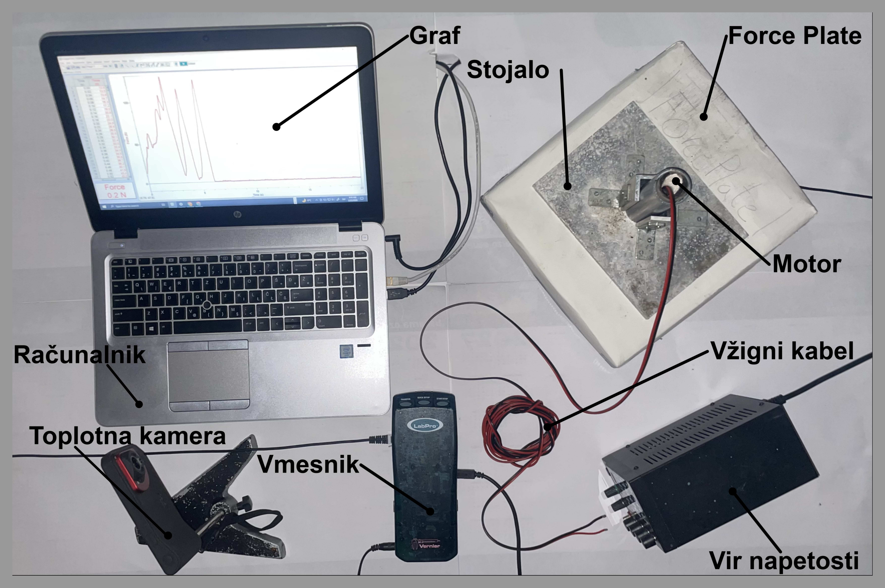
[picture p57: figure]

Slika: Prikaz povezanih pripomočkov za testiranje.

# Prvi in drugi test motorja

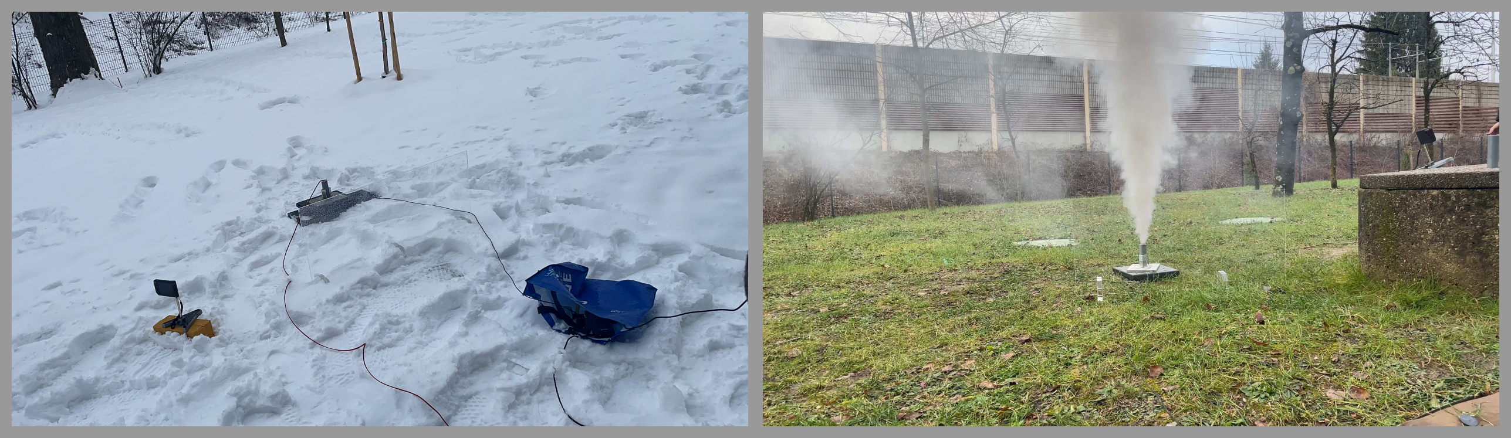
[picture p58: figure]

Slika: Prvo in drugo statično testiranje motorja.

# Tretji test motorja

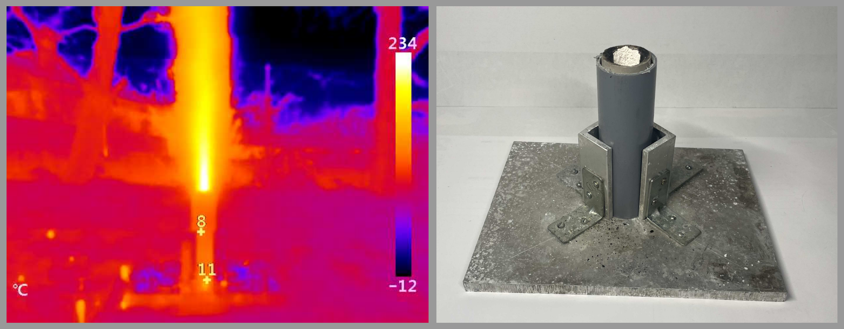
[picture p59: figure]

## Slika: Tretji test sneman s termalno kamero, stojalo motorja

# Tretji test motorja

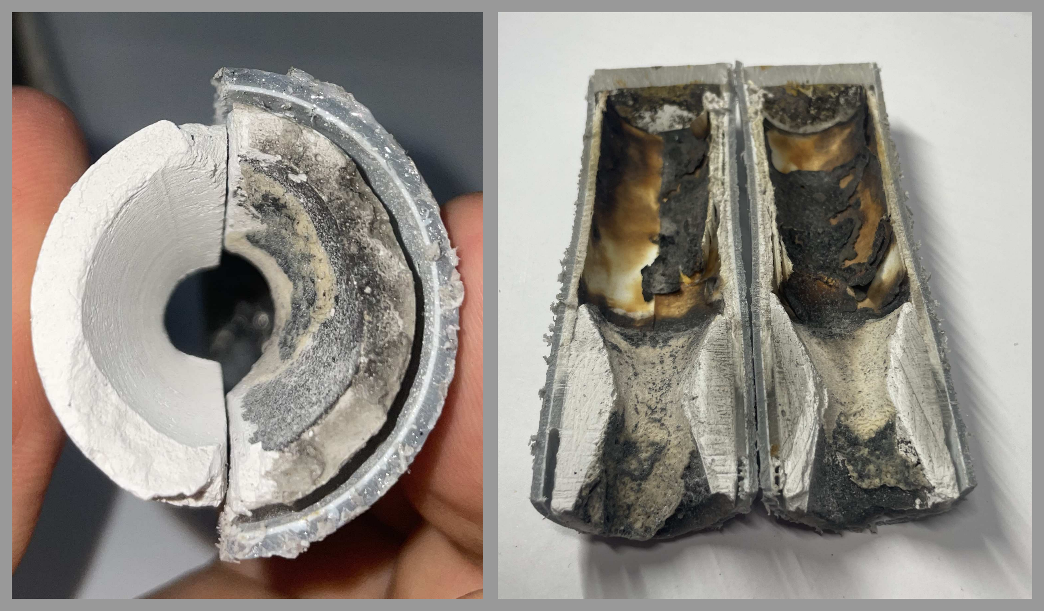
[picture p60: figure]

## Slika: Primerjava sveže in erodirane šobe, prerezan testiran motor

# Analiza podatkov

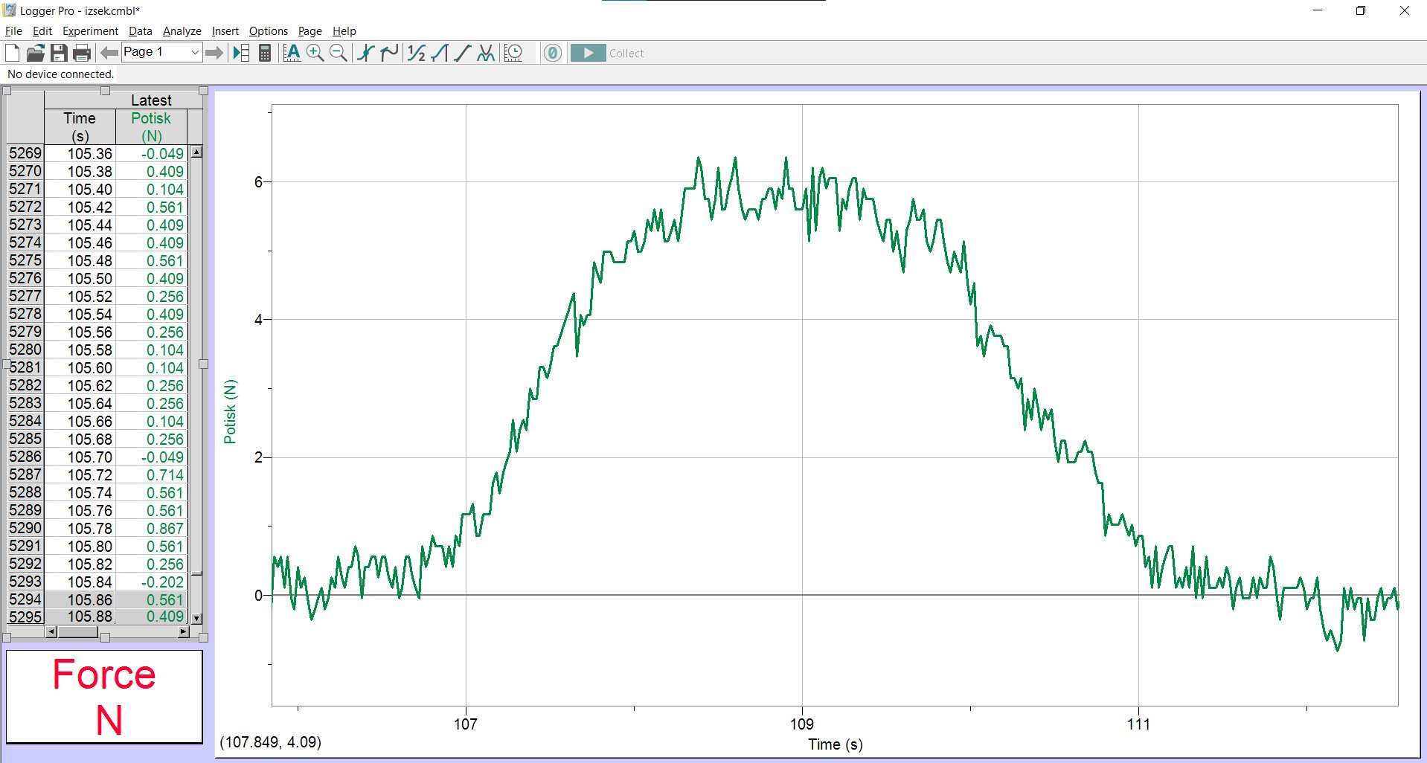
[picture p61: figure]

# I = F ∆t = 17,3 Ns ± 1,6 Ns

# Povprečni potisk in specifični impulz

F¯ =

I
t

=

# 17,3 Ns ± 1,6 Ns

3,6 s ± 0,1 s

= 4,8 N ± 0,6 N

# Povprečni potisk in specifični impulz

F¯ =

I
t

=

# 17,3 Ns ± 1,6 Ns

3,6 s ± 0,1 s

= 4,8 N ± 0,6 N

# ISP =

I
m · g0

=

# 17,3 Ns ± 1,6 Ns (0,075 kg ± 0,001 kg) · 9,806 65 m/s

2

= 23,5 s ± 2,3 s

# Izhodna hitrost izpuhov in sprememba hitrost rakete

v¯e =

I
m

=

# 17,3 Ns ± 1,6 Ns 0,075 kg ± 0,001 kg = 230 m/s ± 23 m/s

# Izhodna hitrost izpuhov in sprememba hitrost rakete

v¯e =

I
m

=

# 17,3 Ns ± 1,6 Ns 0,075 kg ± 0,001 kg = 230 m/s ± 23 m/s

# ∆v = ve ln

m0
m1

# = (230 m/s ± 23 m/s) · ln 0,170 kg ± 0,001 kg

# 0,095 kg ± 0,001 kg

# = 134 m/s ± 17 m/s

Raketni motor | Vrsta | ISP [s]
NERVA NRX A6 | Nuklearni | 869
RS-25 | Tekoče gorivo 453
RD-843 | Tekoče gorivo 315,5
Merlin 1D | Tekoče gorivo 310
Avio Zefiro 9A | Trdno gorivo | 295,2
Avio Zefiro 23 | Trdno gorivo | 287,5
Space Shuttle SRB Trdno gorivo | 250
Najin motor | Trdno gorivo | 23,5

(https://www.dl1.en-us.nina.az/Specific impulse.html, 7. 2. 2026)

# Rezultati

# Izdelava cenovno ugodnega motorja Dokaz papirja kot dobrega izolatorja Odkritje neprimernosti KD šobe za najin motor Omogočanje nadaljnjega testiranja motorja ostalim Ponovljiv način pridobivanja goriva Preverjena točnost simulacije

# Opredelitev do preostalih hipotez

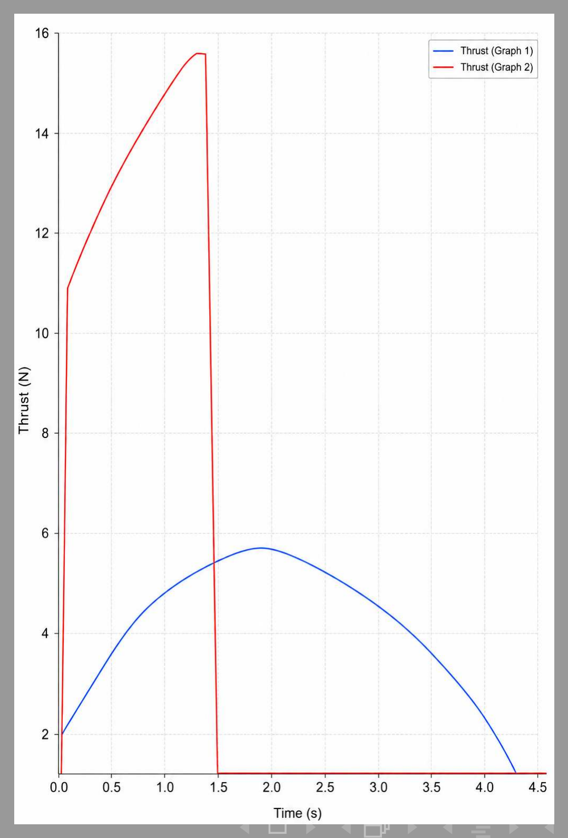
[picture p62: figure]

# 1 Primerjava simulacije in izmerjenih podatkov 2 Nizkocenovnost motorja

## Cena materialov enega motorja

približno 1,15 evra.

# Zaključek in ideje za naprej

# Ideje za naprej : Drugi materiali za šobe Drugačna oblika šobe Raziskava vpliva vlage na gorivo Alternativna goriva Preizkusiti druge metode izdelave goriva Dinamično testiranje motorja v raketi

# Hvala za pozornost

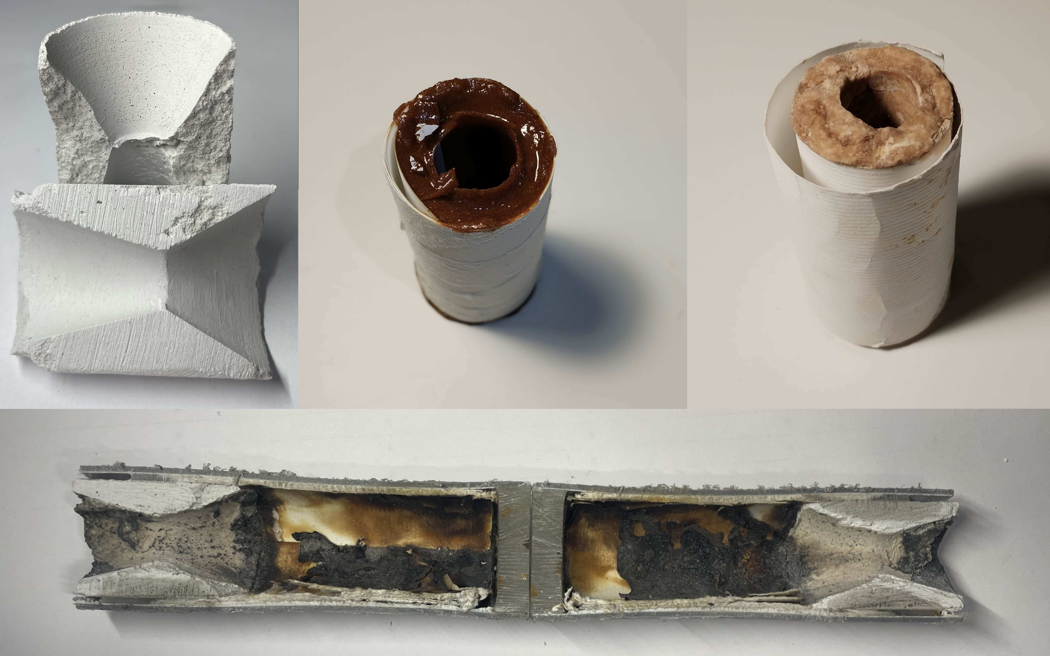
[picture p63: figure]

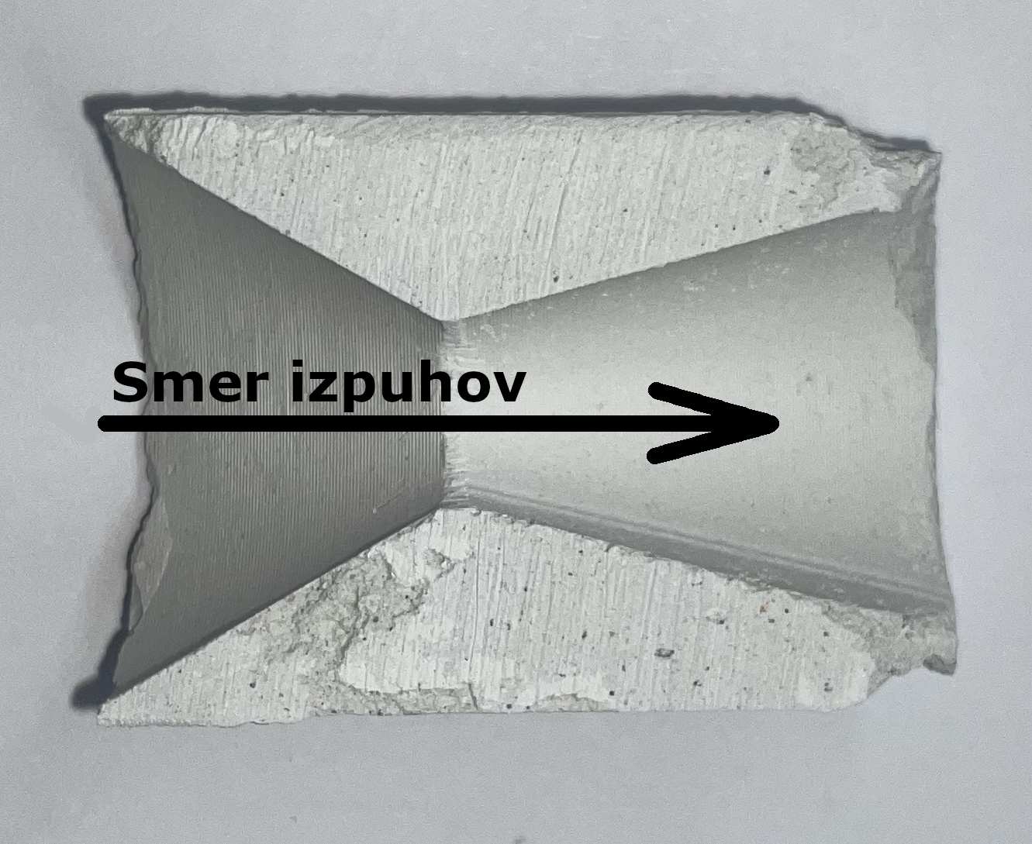
[picture p64: figure]

(1 − M²
)

dv
v

= −

dA
A

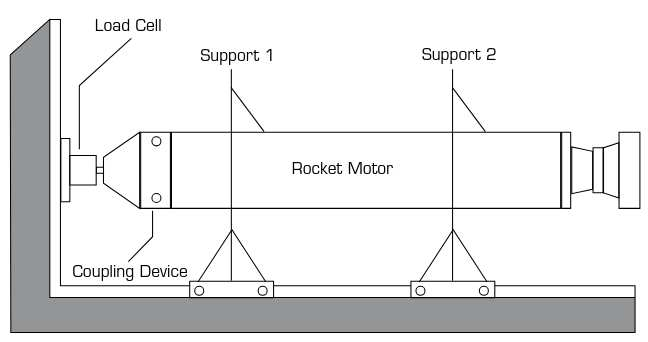
[picture p65: figure]

Slika: Shema tipičnega statičnega testa.

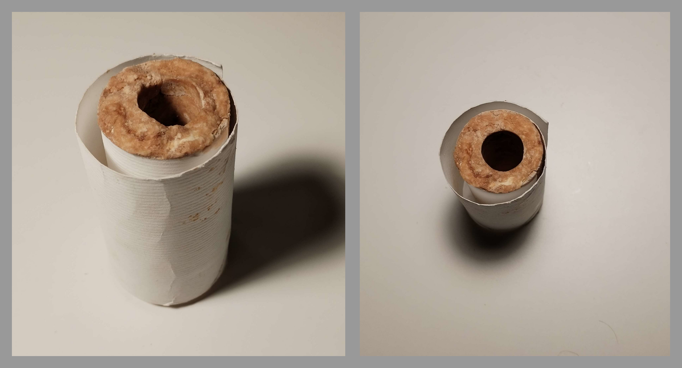
[picture p66: figure]
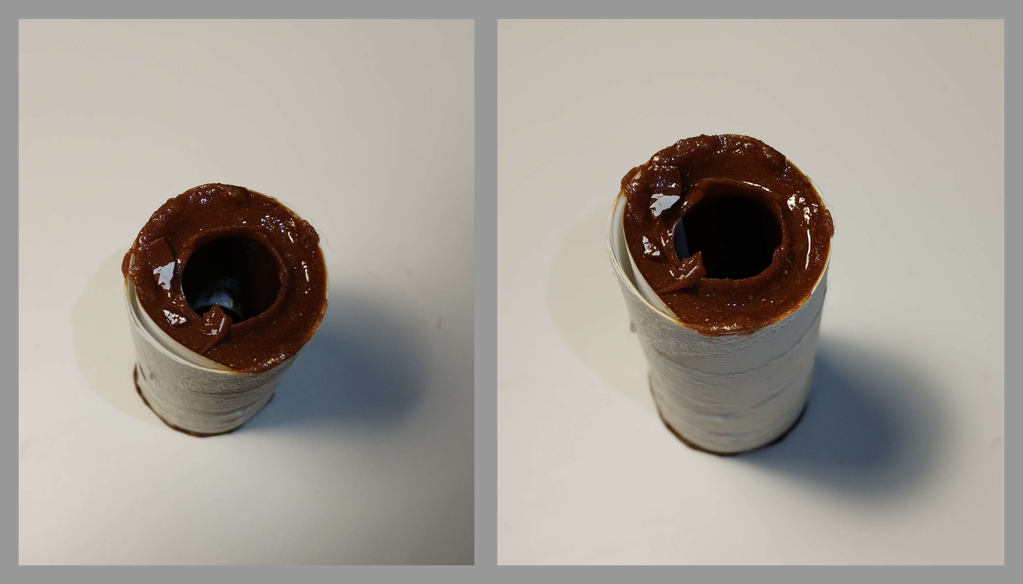
[picture p67: figure]

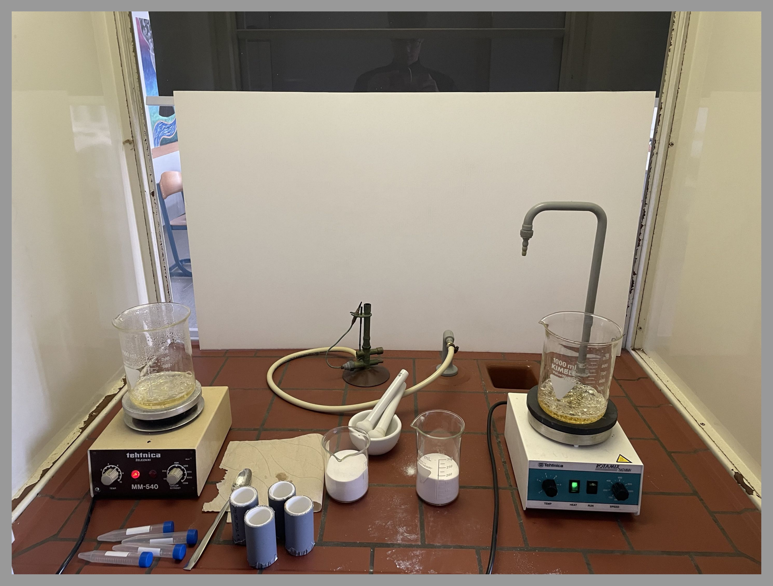
[picture p68: figure]

Slika: Digestorij (odduha), kjer je pripravljeno vse za pripravo gorivnih celic.

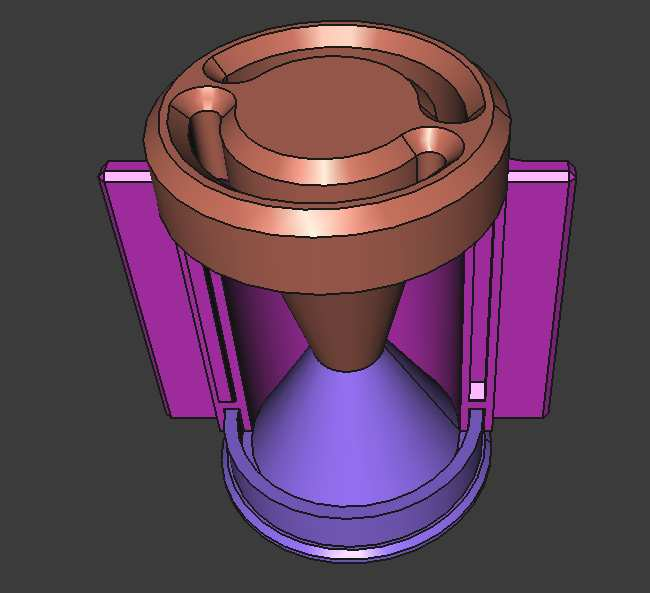
[picture p69: figure]
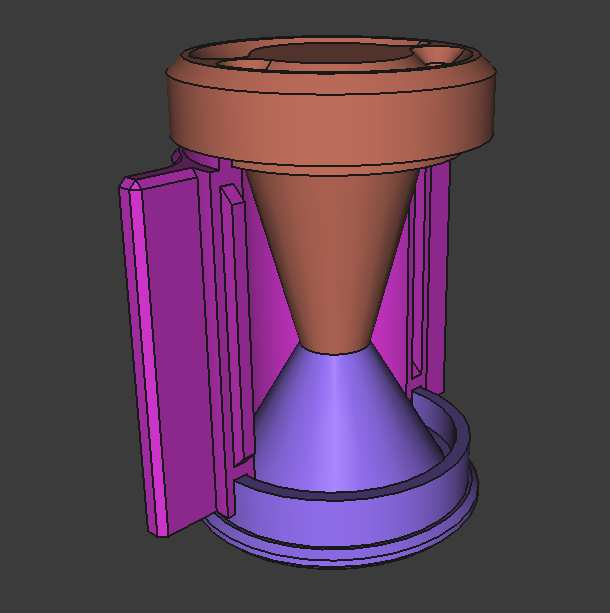
[picture p70: figure]
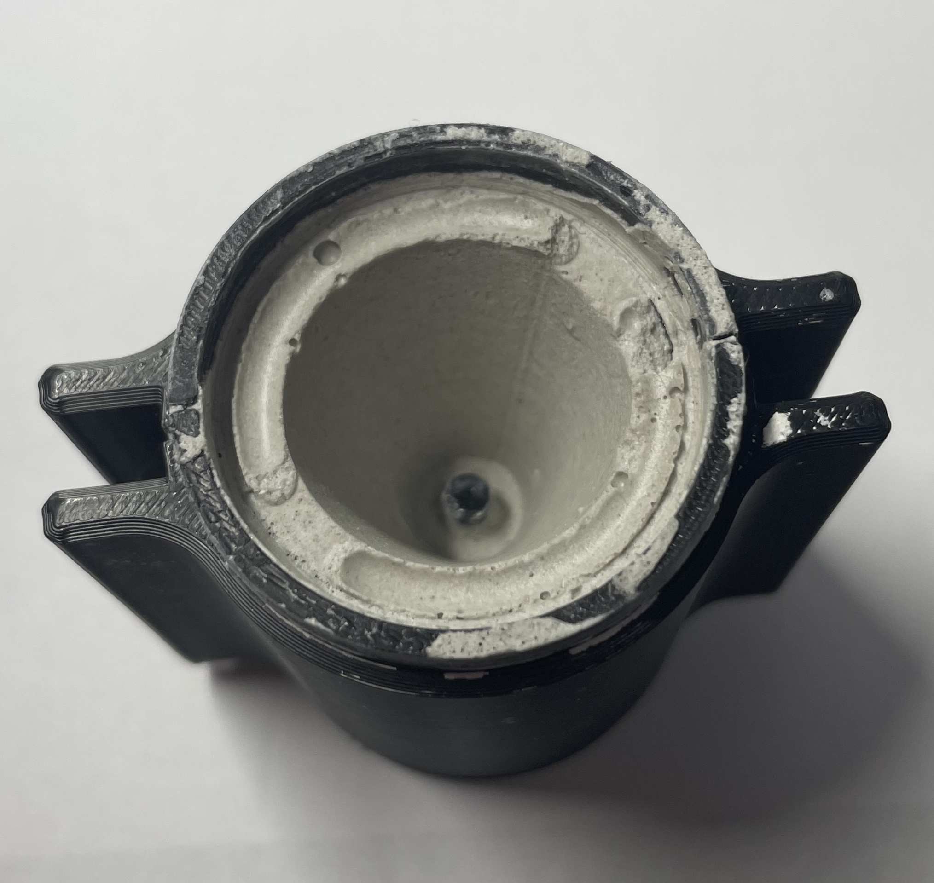
[picture p71: figure]
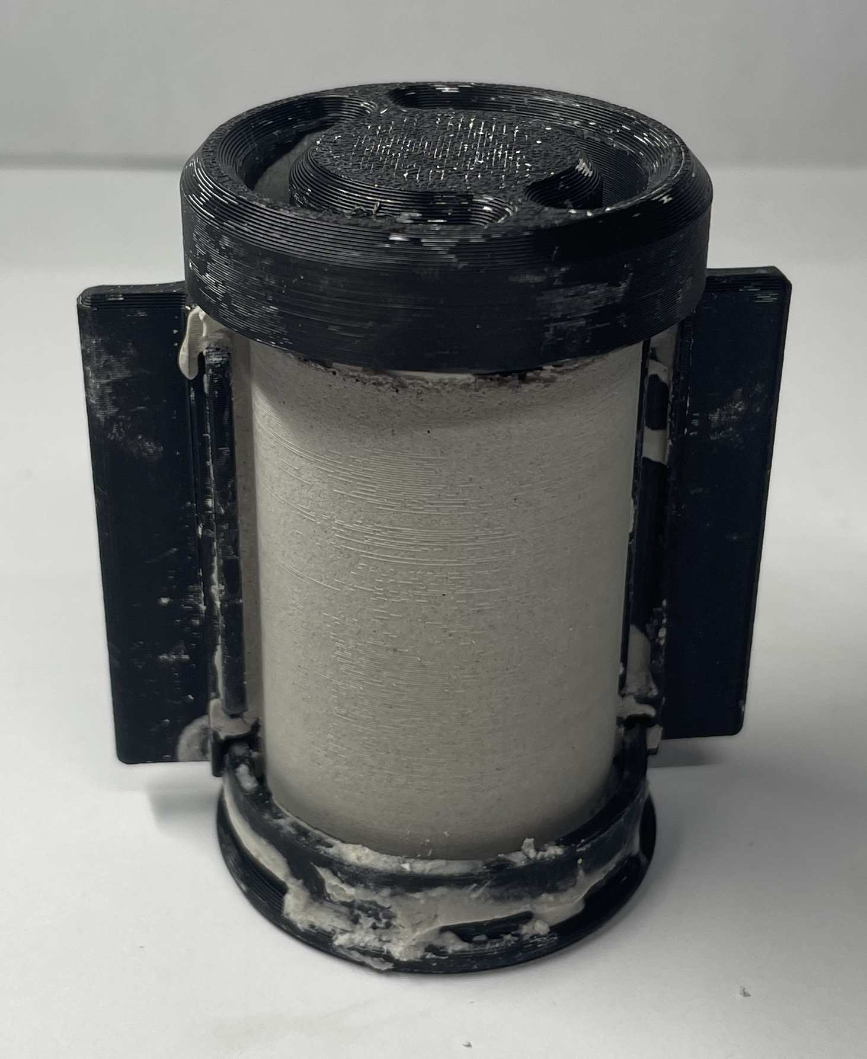
[picture p72: figure]
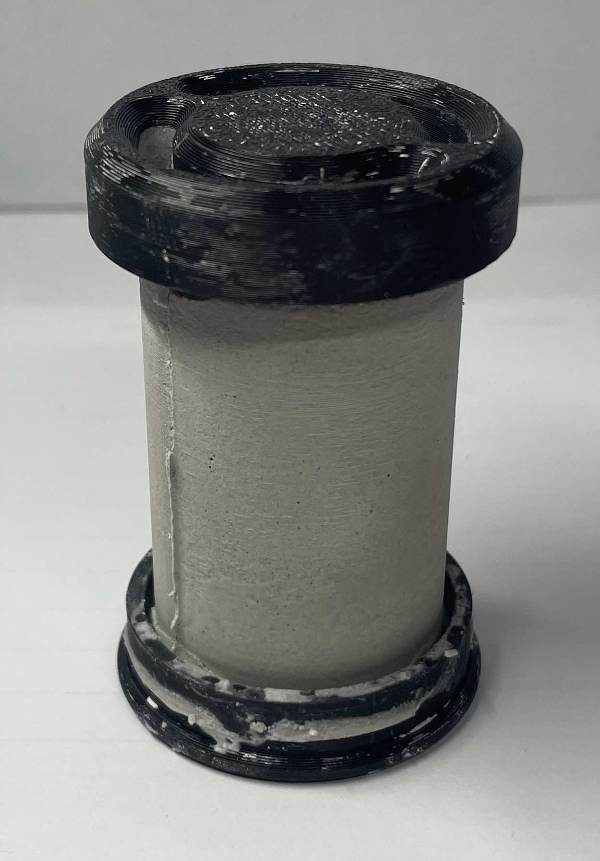
[picture p73: figure]

# C12H22O11(s) + 6.288 KNO3(s) −−→ −−→ 3.796 CO2(g) + 5.205 CO(g) + 7.794 H2O(g) + 3.065 H2(g) + + 3.143 N2(g) + 2.998 K2CO3(l) + 0.274 KOH(g)
