qyx22122/projekt-RC/raziskovalna_naloga/slike/QFau_označen.pdf

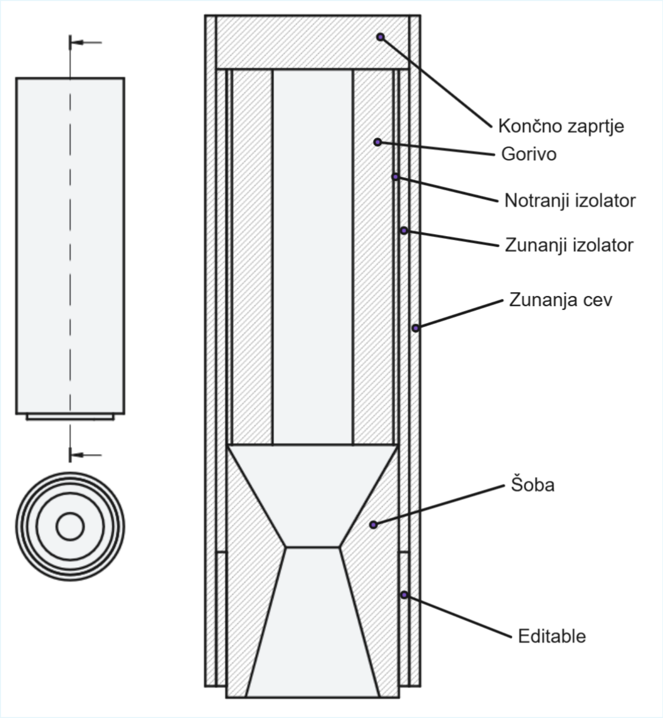
[picture p80: page 1]
