qyx22122/projekt-RC/raziskovalna_naloga/slike/shema_QFau_označena.pdf

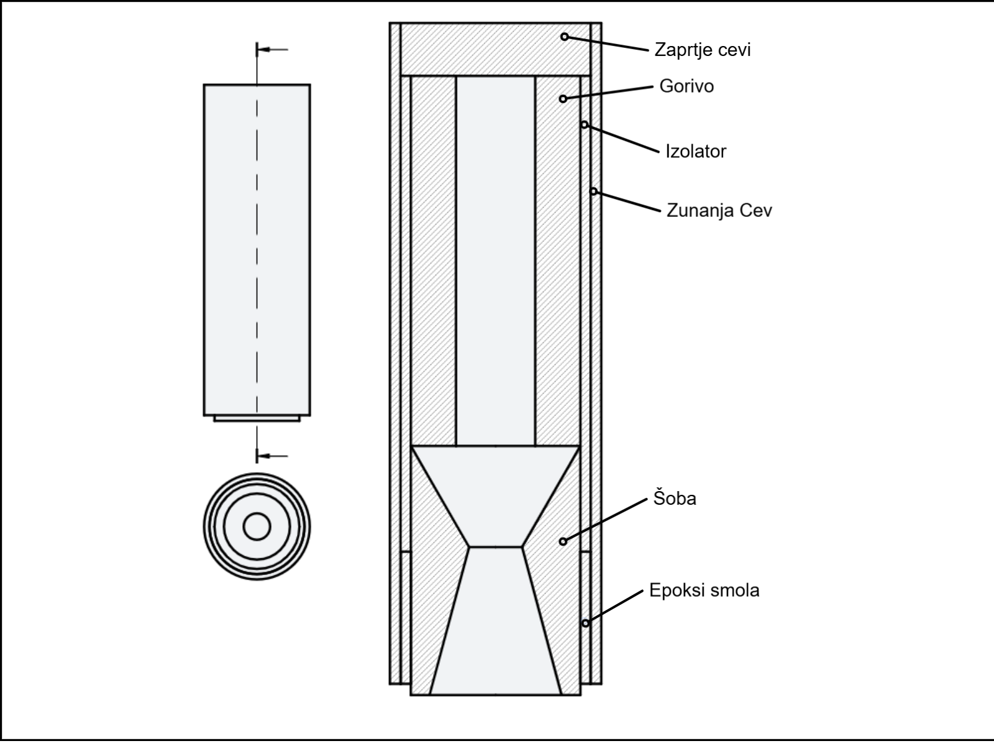
[picture p81: page 1]
