qyx22122/projekt-RC/CAD/Shema_QFaU.png

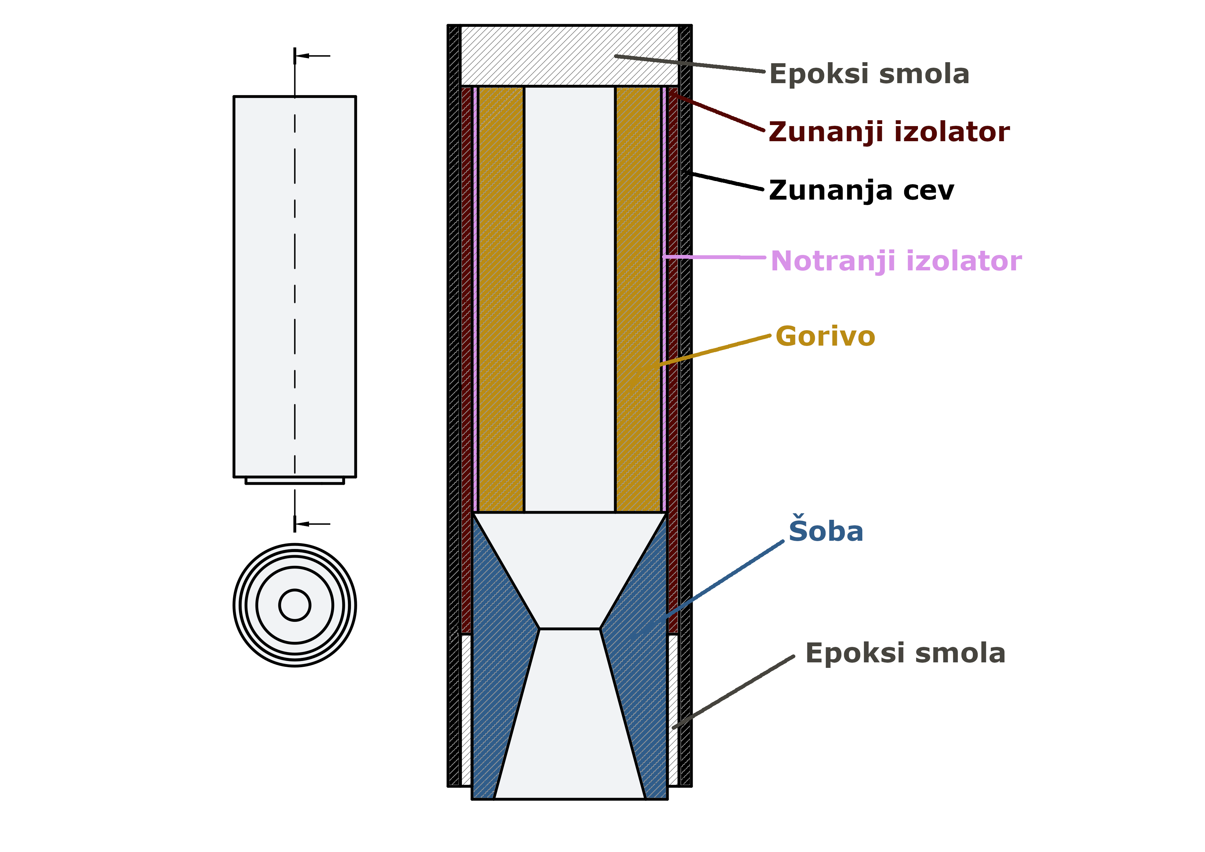
CAD/Shema_QFaU.png
