qyx22122/projekt-RC/finance/Fertilizante_cristalino_con_potásio_KNO-3_puro_NPK_13-00-46._5_Kg.png

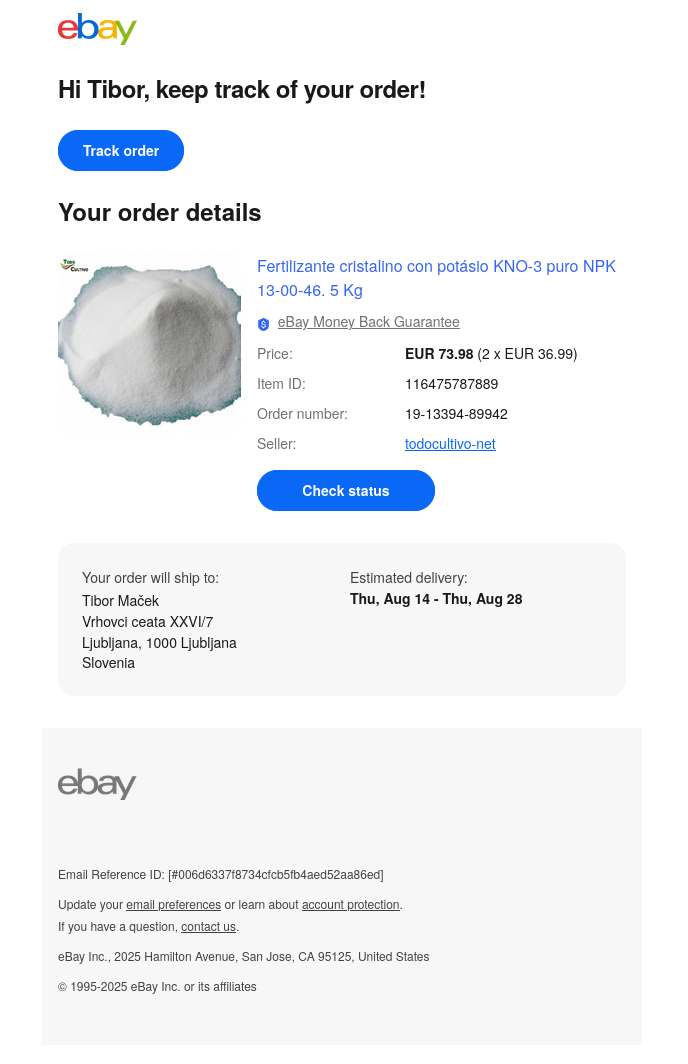
finance/Fertilizante_cristalino_con_potásio_KNO-3_puro_NPK_13-00-46._5_Kg.png
