qyx22122/projekt-RC/meritve/openMotor_files/graf_originalen.png

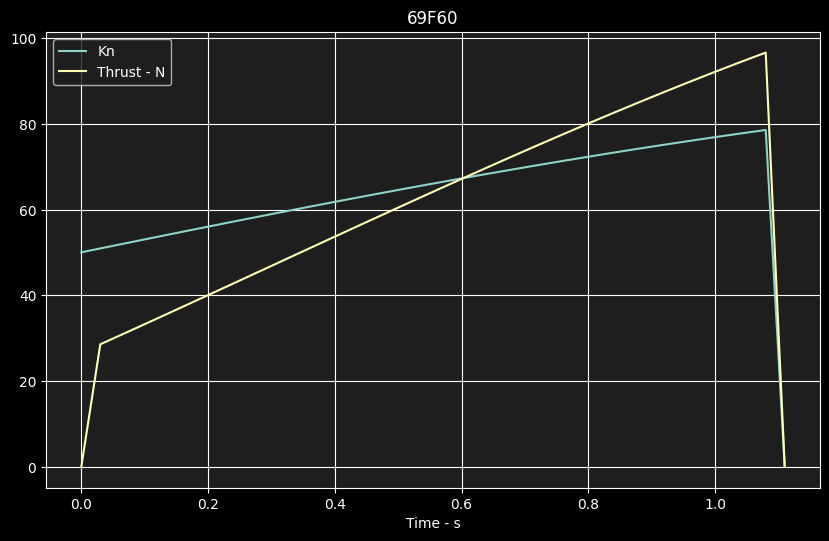
meritve/openMotor_files/graf_originalen.png
