qyx22122/projekt-RC/meritve/openMotor_files/graf_potiska.png

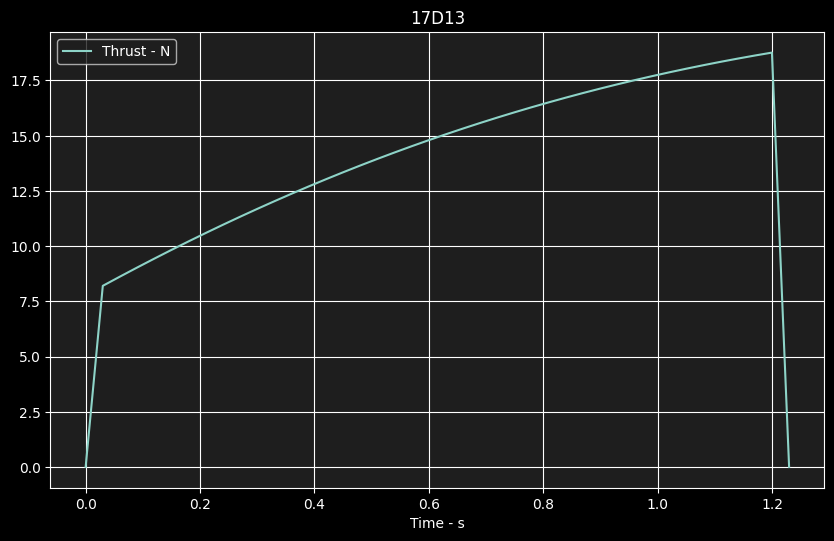
meritve/openMotor_files/graf_potiska.png
