qyx22122/projekt-RC/meritve/openMotor_files/graf_sprememba_grla.png

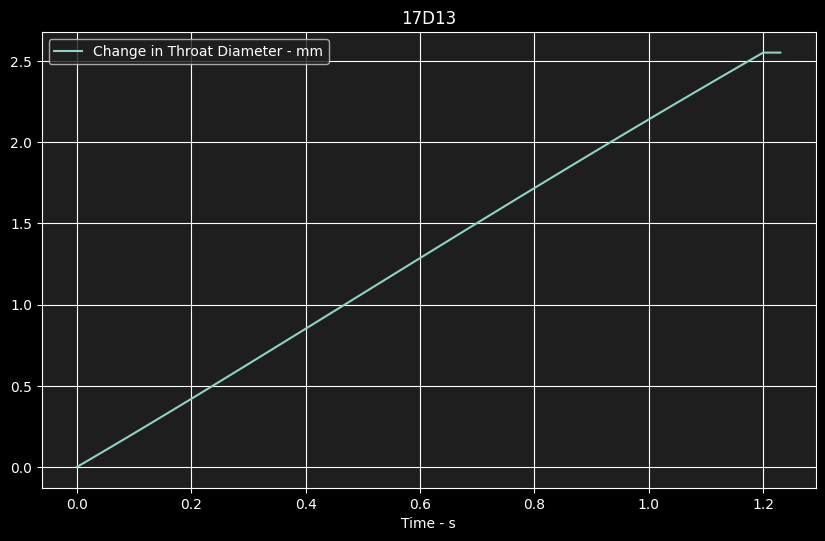
meritve/openMotor_files/graf_sprememba_grla.png
