qyx22122/projekt-RC/meritve/openMotor_files/graf_tlak.png

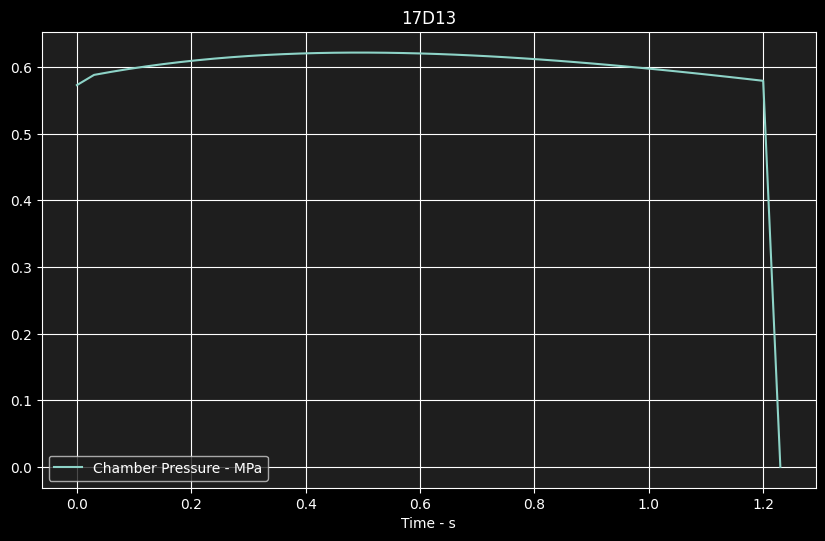
meritve/openMotor_files/graf_tlak.png
