qyx22122/projekt-RC/meritve/openMotor_files/prilagojen_impulz_soba.png

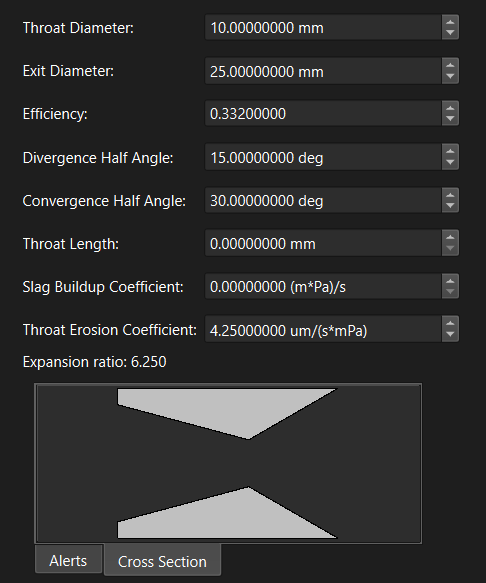
meritve/openMotor_files/prilagojen_impulz_soba.png
