qyx22122/projekt-RC/meritve/openMotor_files/prilagojeno_impulz.png

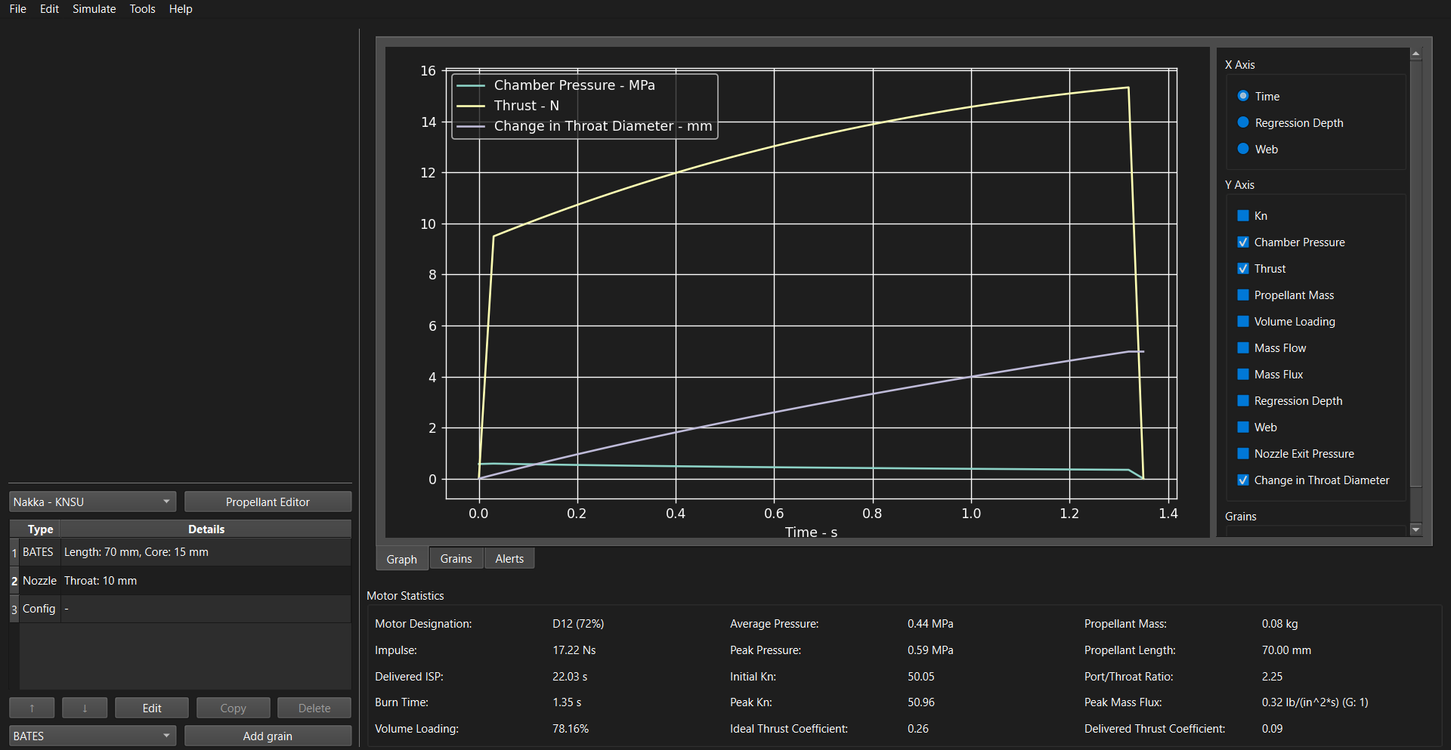
meritve/openMotor_files/prilagojeno_impulz.png
