qyx22122/projekt-RC/raziskovalna_naloga/slike/epoksi_cev.jpg

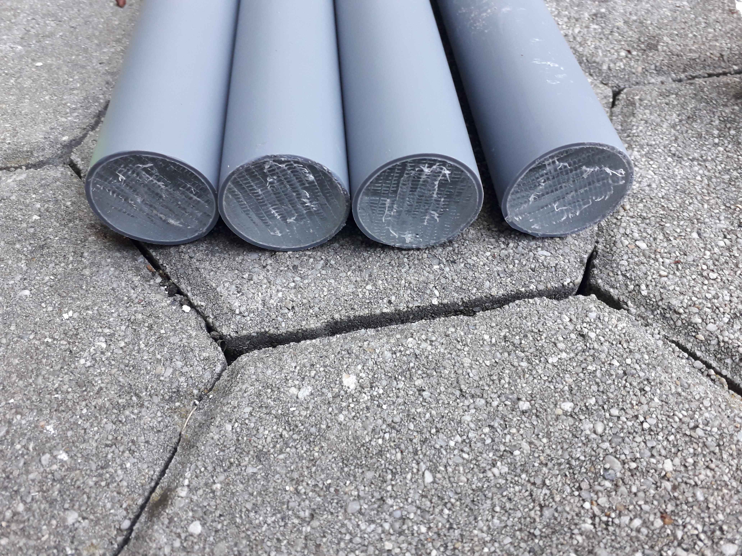
raziskovalna_naloga/slike/epoksi_cev.jpg
