qyx22122/projekt-RC/raziskovalna_naloga/slike/graf_originalen2.png

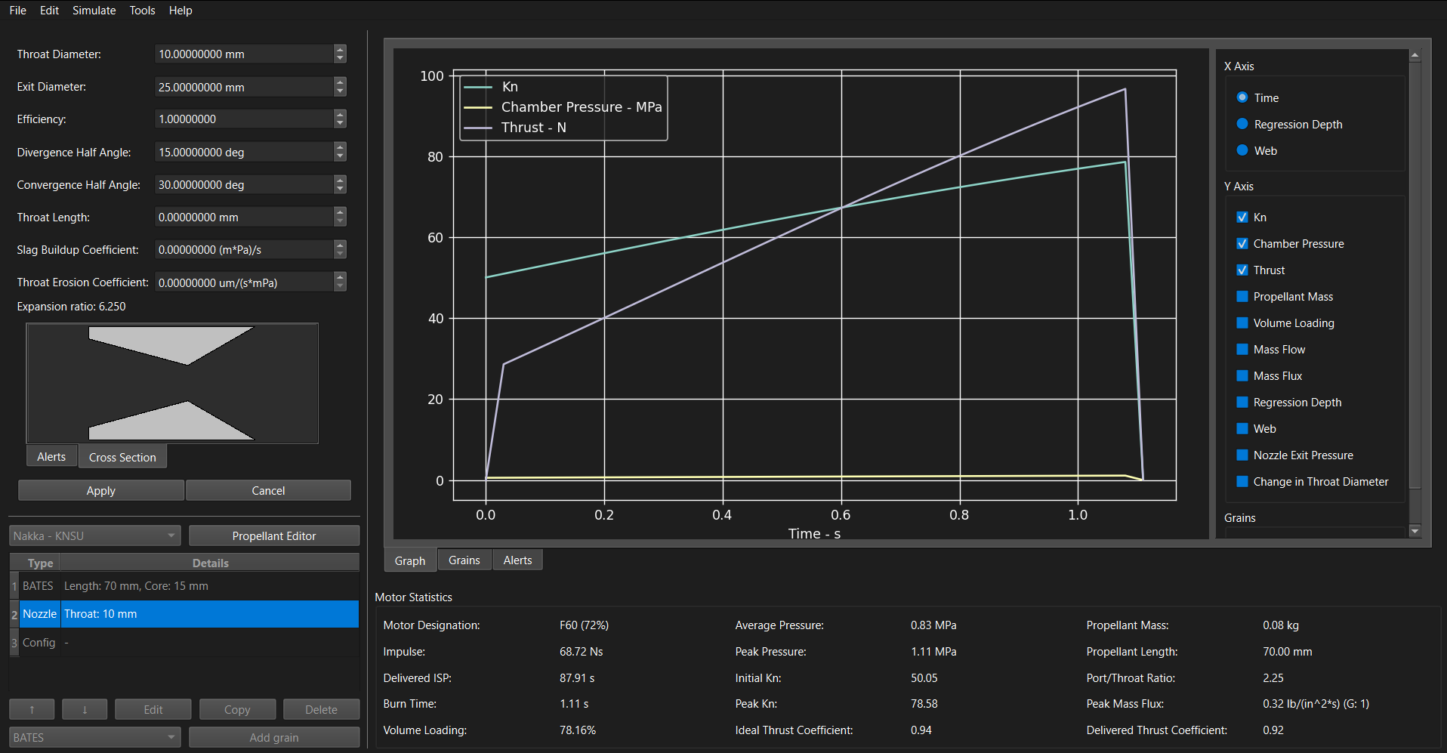
raziskovalna_naloga/slike/graf_originalen2.png
