qyx22122/projekt-RC/raziskovalna_naloga/slike/integral2.png

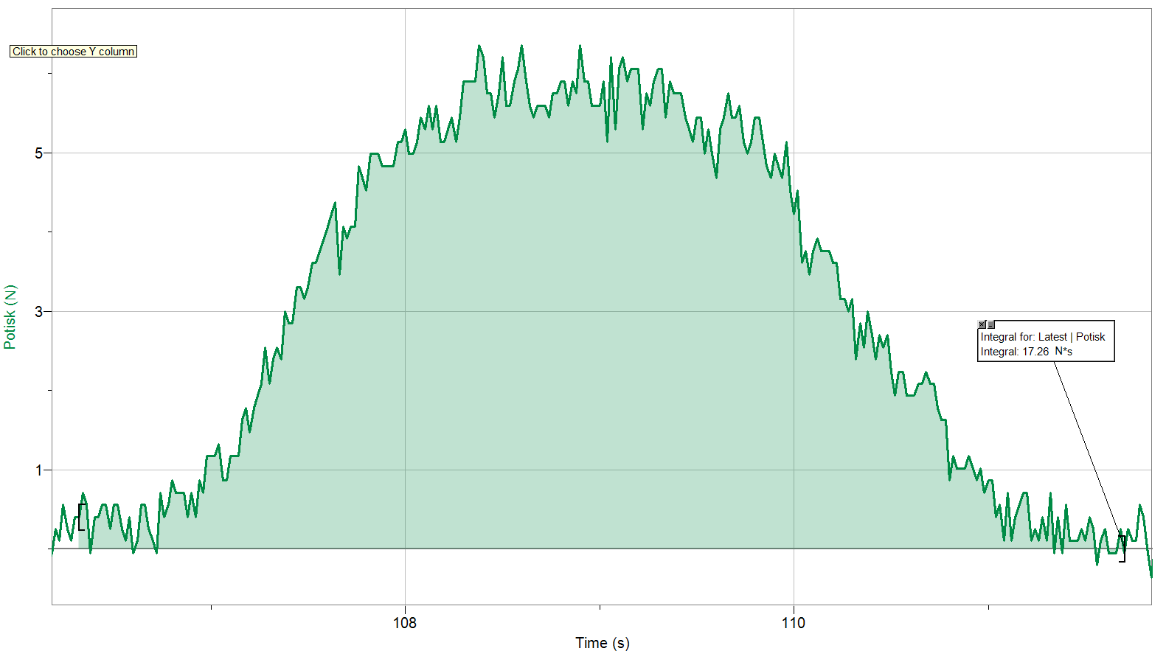
raziskovalna_naloga/slike/integral2.png
