qyx22122/projekt-RC/raziskovalna_naloga/slike/roka.png

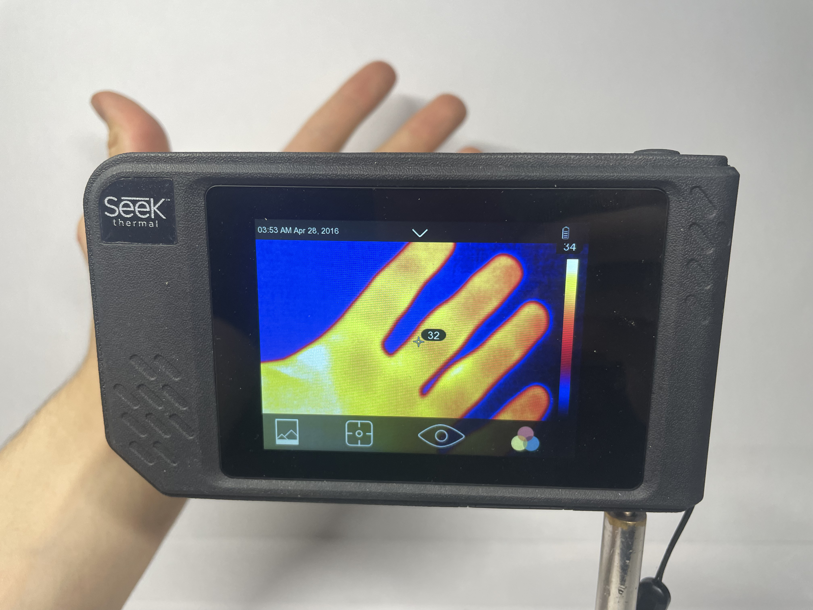
raziskovalna_naloga/slike/roka.png
