qyx22122/projekt-RC/raziskovalna_naloga/slike/soba_s_strani.png

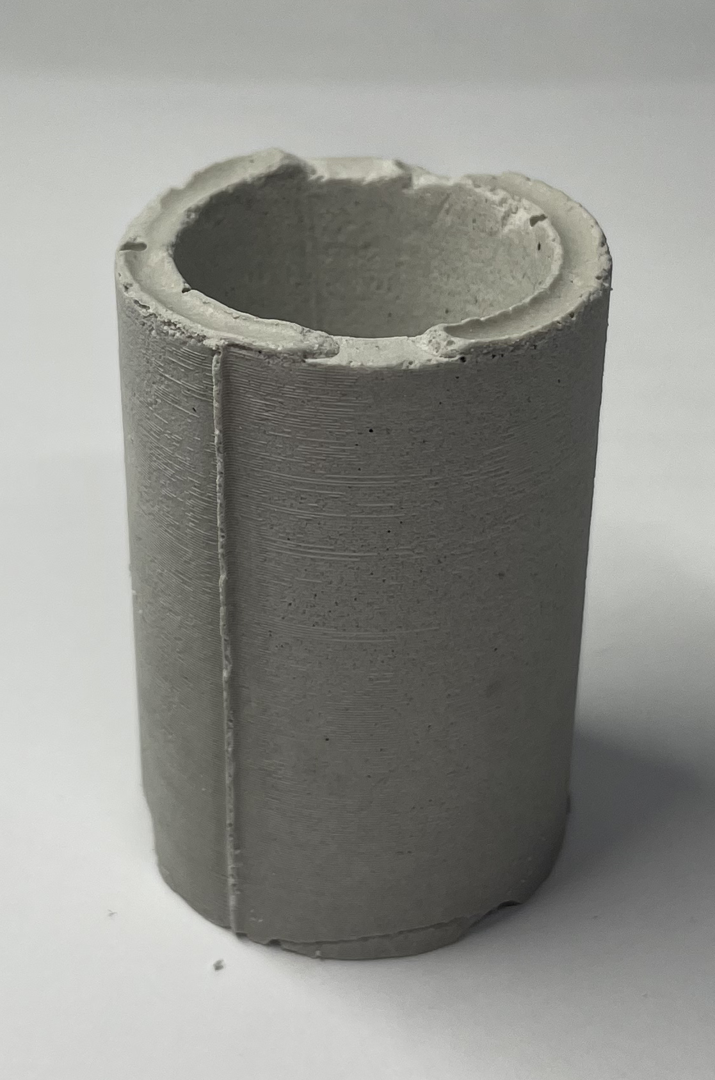
raziskovalna_naloga/slike/soba_s_strani.png
