qyx22122/projekt-RC/raziskovalna_naloga/slike/soba_zgoraj.png

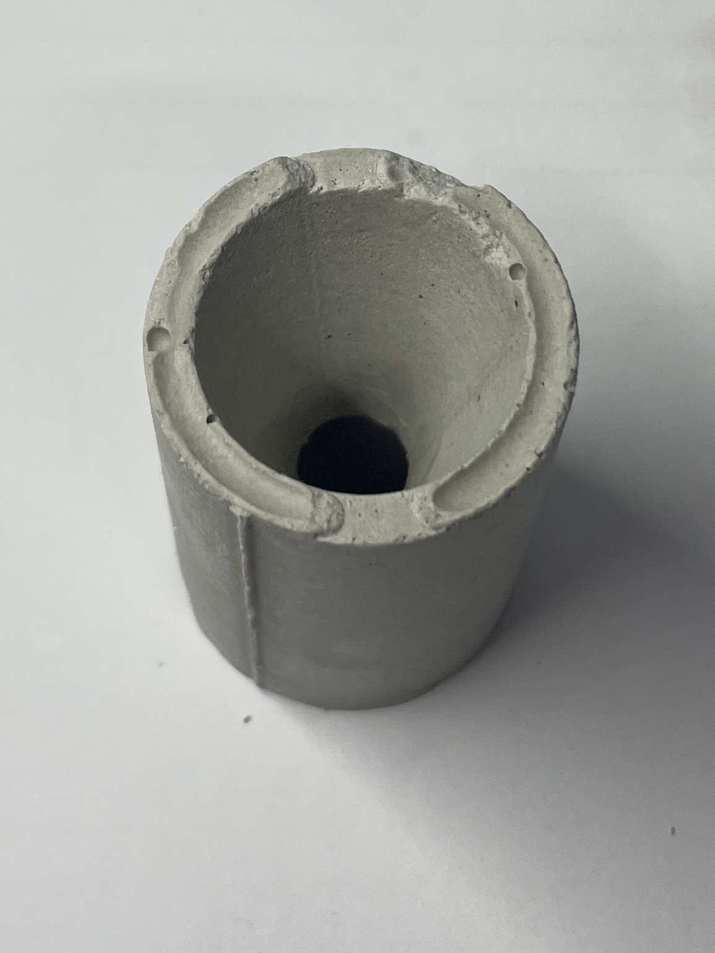
raziskovalna_naloga/slike/soba_zgoraj.png
