qyx22122/projekt-RC/slike_in_posnetki/tibor_dal/IMG_20250807_151228.jpg

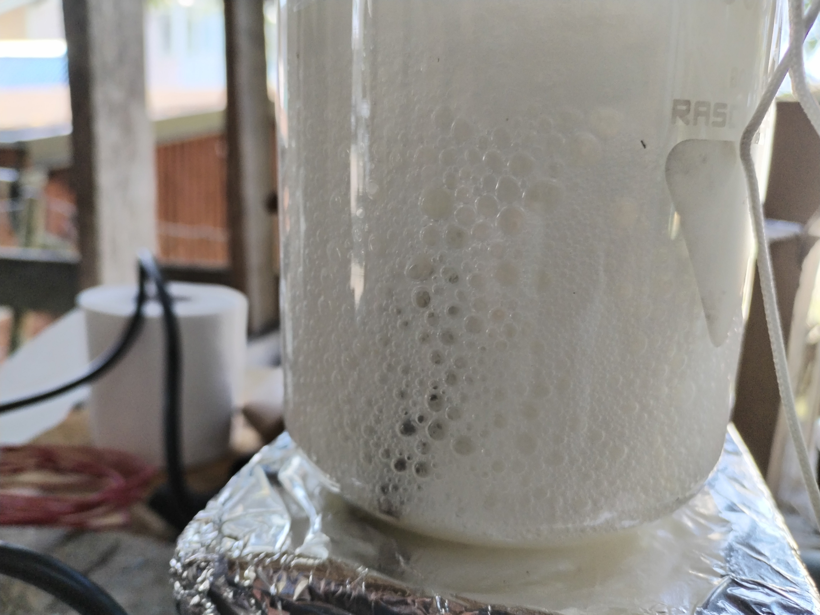
slike_in_posnetki/tibor_dal/IMG_20250807_151228.jpg
