qyx22122/projekt-RC/CAD/QFaU.FCStd

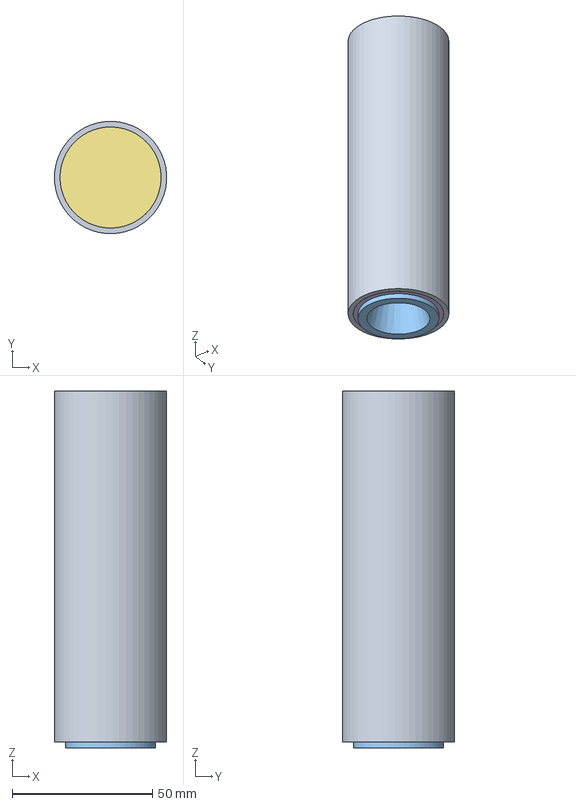
[picture p100: CAD file, 2026-02-19]
CAD/QFaU.FCStd
40.0 x 40.0 x 127.1 mm
cev
zunanji_izolator
šoba
gorivo
notranji_izolator
epoksi_šoba
epoksi
