qyx22122/projekt-RC/CAD/šoba.FCStd

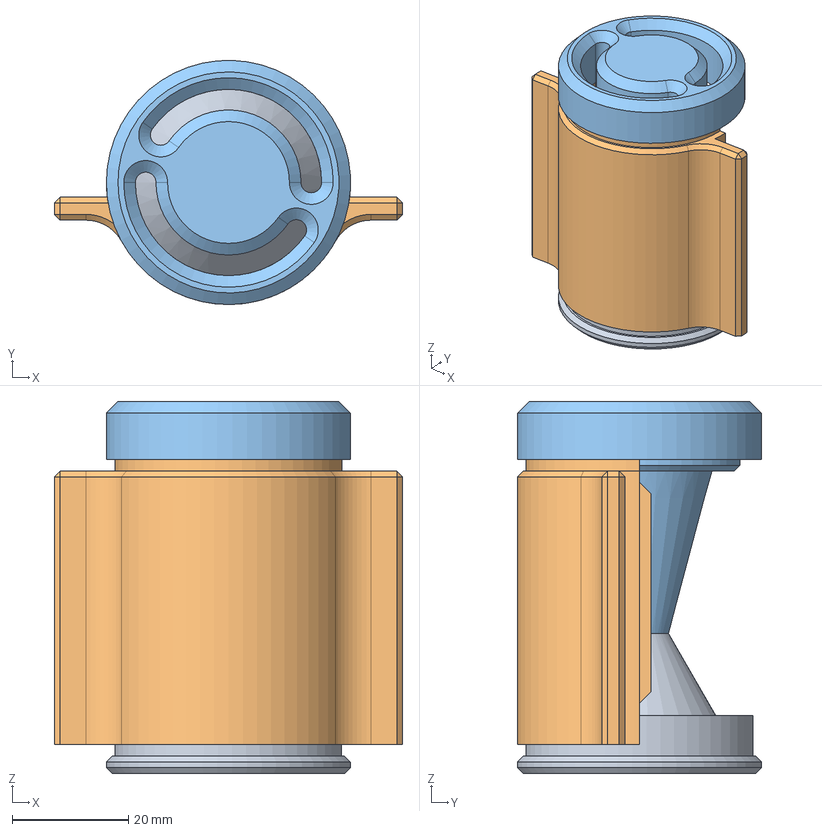
[picture p101: CAD file, 2026-02-19]
CAD/šoba.FCStd
60.0 x 42.1 x 64.1 mm
Spodji_del
Srednji_del
Zgornji_del
