qyx22122/projekt-RC/(list of files, cad)

Other CAD files:
CAD/šoba.3mf
