qyx22122/projekt-RC/raziskovalna_naloga/slike/test2_2.png

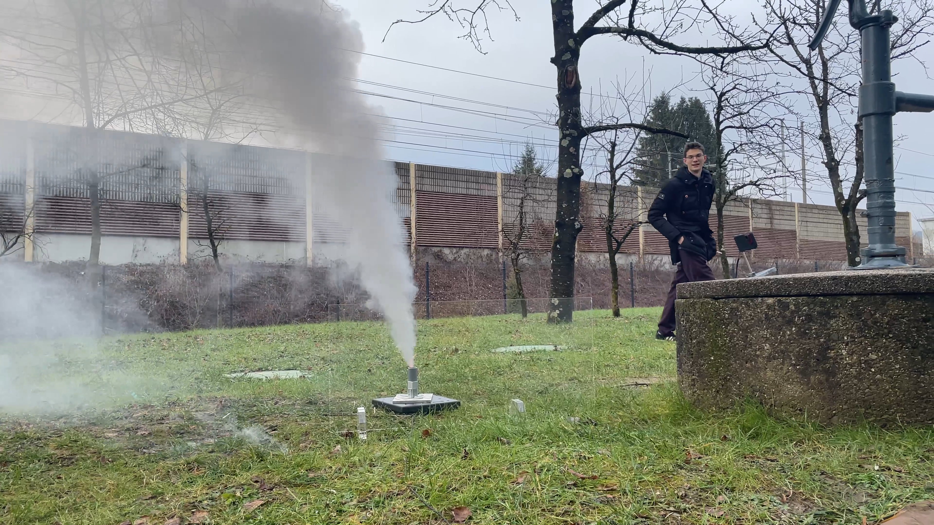
raziskovalna_naloga/slike/test2_2.png
