qyx22122/projekt-RC/CAD/Shema_QFaU.pdf

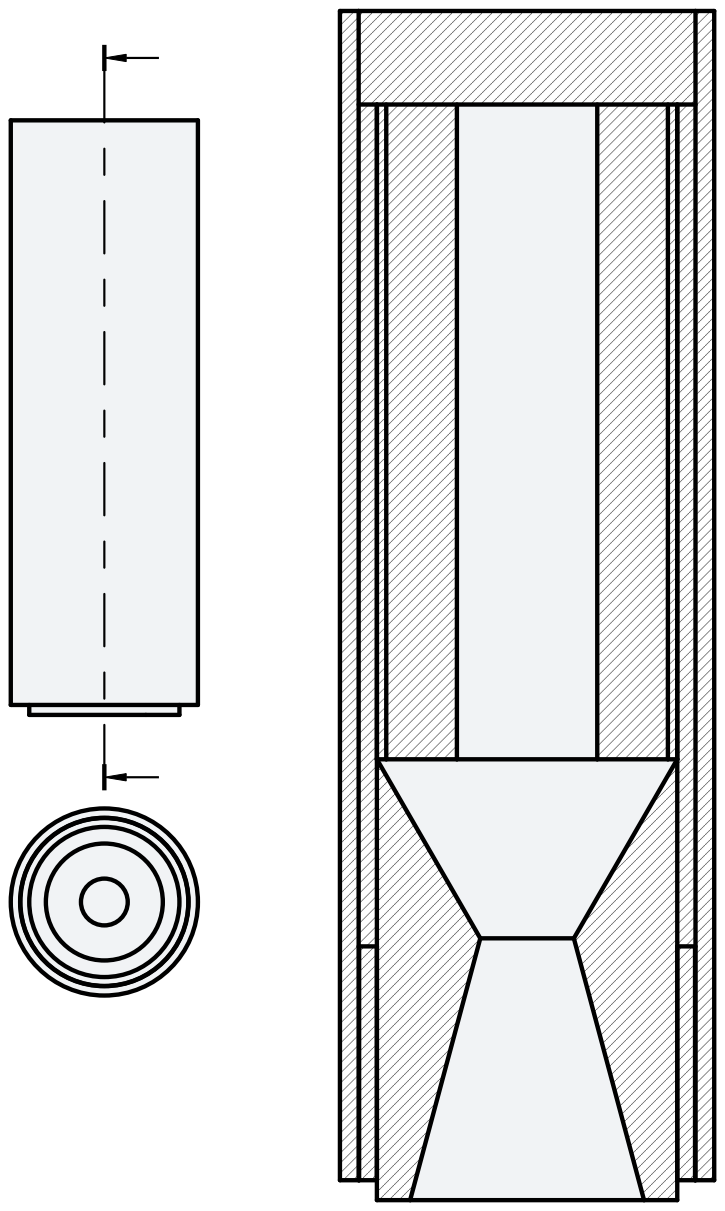
[picture p103: page 1]
