qyx22122/projekt-RC/CAD/Shema_šobe.pdf

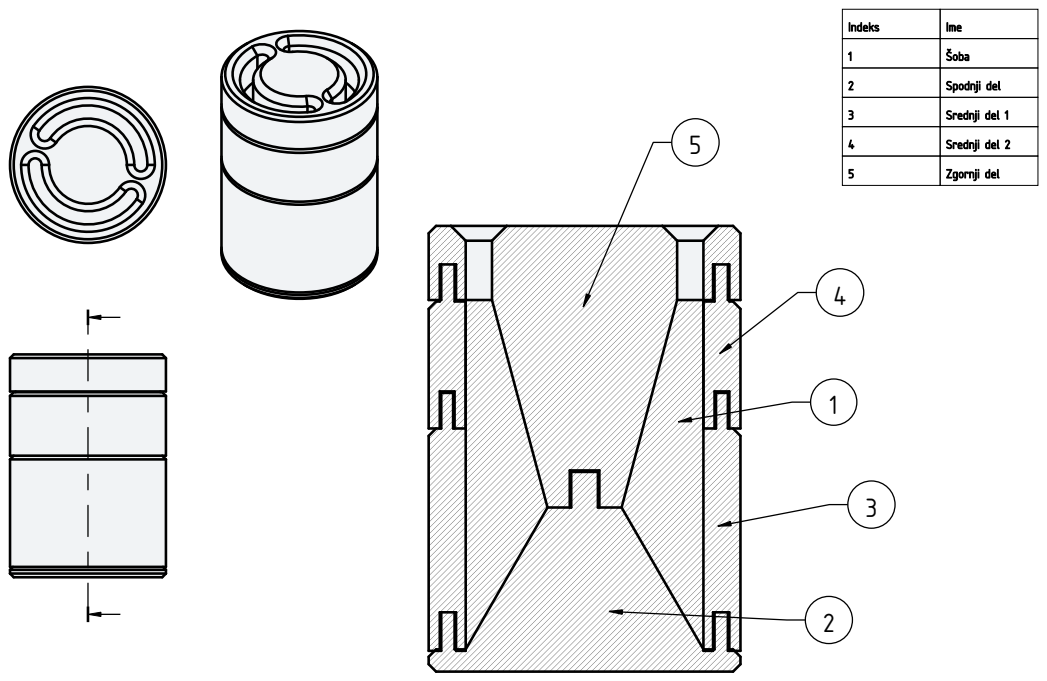
[picture p104: page 1]
