qyx22122/projekt-RC/(commit log)

2025-12-05 Dodal meritve
    [meritve.ods]
2025-12-05 Dodal podatke o masi
    [meritve.ods]
2025-12-07 Dodal direktori finance in slike_in_posnetki
    [finance.ods]
2025-12-12 Dodal meritve temperature od termalne kamere
    [meritve.ods]
2025-12-13 dodal mapo za motorje, simuliral
    v mapi za motorje je file QFaU, predlagam da zacneva z takimi velikostmi sobe, potem pa spreminjava
2025-12-21 Naredi model za šobo in cel motor
    [QFaU.FCStd, šoba.FCStd]
2025-12-21 Malo spremenil šobo in dodal max tlak v simu
    [šoba.FCStd]
2025-12-26 Naredil sheme
    [QFaU.FCStd, šoba.3mf, šoba.FCStd]
2025-12-31 Izboljšal design modela
    [šoba.3mf, šoba.FCStd]
2026-01-07 dodal vir in delam na izdelavi motorja
2026-01-10 delal na izdelavi in sestavi motorja
2026-01-16 CAD in merjenje potiska
    Nov model za šobo in v osnutku narejen opis držala
    [šoba.3mf, šoba.FCStd]
2026-01-28 formatiral in popravil enote
    [šoba.3mf, šoba.FCStd]
2026-02-17 dodal sestavljanju motorja
2026-02-19 Nova shema
    [QFaU.FCStd, šoba.FCStd]
2026-02-19 Nova shema 2.0
    [QFaU.FCStd]
2026-02-19 Dopolnil del o openMotorju in formatiral
    [QFaU.FCStd]
2026-02-19 Nadaljeval Merjenje potiska in dodal Vžig motorja
    dodal sem tudi nov vir za temperaturo vžiga KNSU
2026-03-09 dodal sestava motorja
