qyx22122/projekt-RC/raziskovalna_naloga/slike/setup_anotiran.png

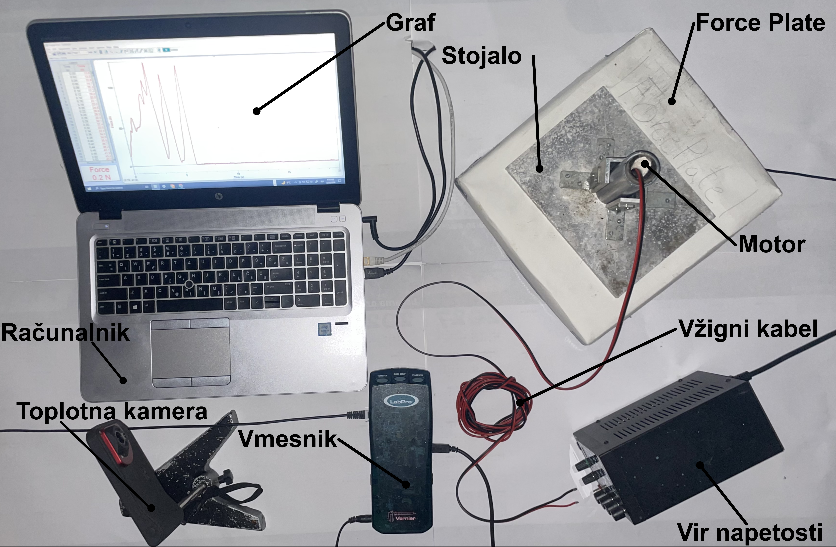
[picture p11: raziskovalna_naloga/slike/setup_anotiran.png]
raziskovalna_naloga/slike/setup_anotiran.png
