qyx22122/projekt-RC/raziskovalna_naloga/slike/test2_3.png

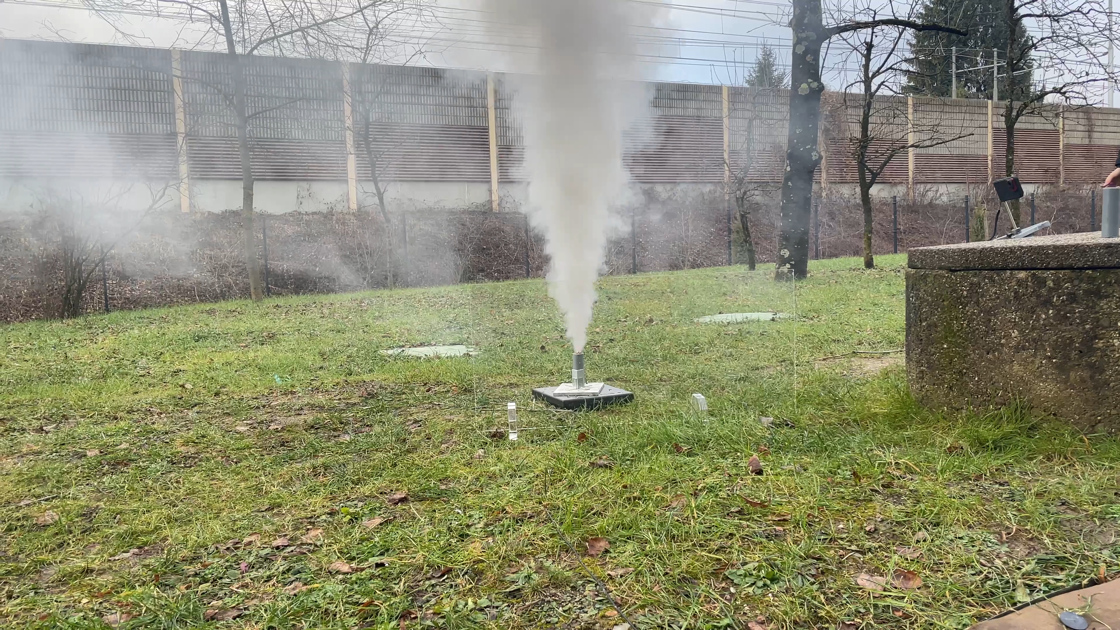
[picture p13: raziskovalna_naloga/slike/test2_3.png]
raziskovalna_naloga/slike/test2_3.png
