qyx22122/projekt-RC/raziskovalna_naloga/slike/model-poln-strjen.png

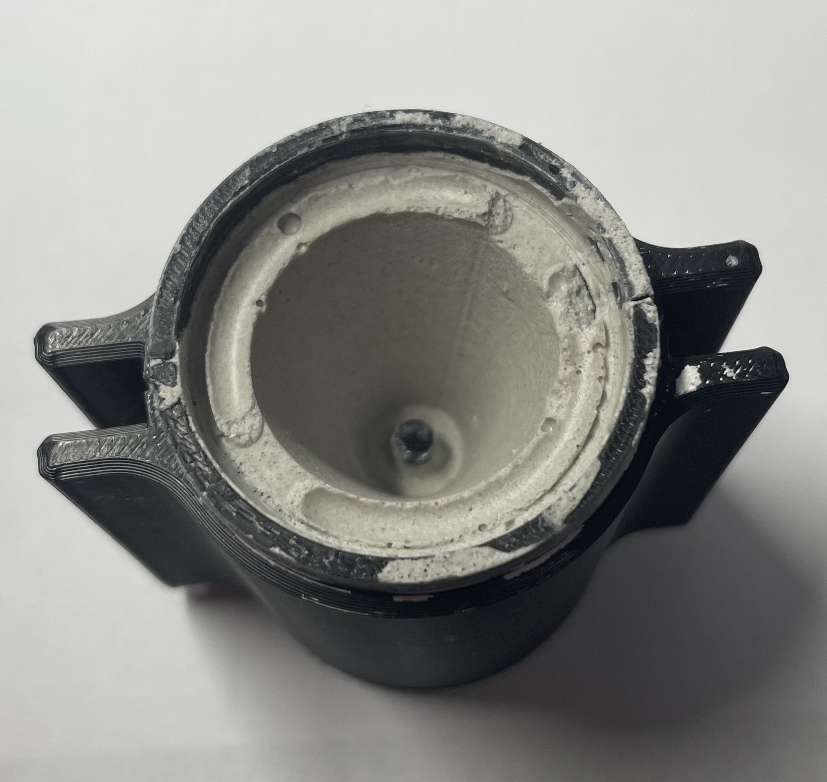
[picture p28: raziskovalna_naloga/slike/model_poln_strjen.png]
raziskovalna_naloga/slike/model-poln-strjen.png
