qyx22122/projekt-RC/raziskovalna_naloga/slike/beaker_mavec.png

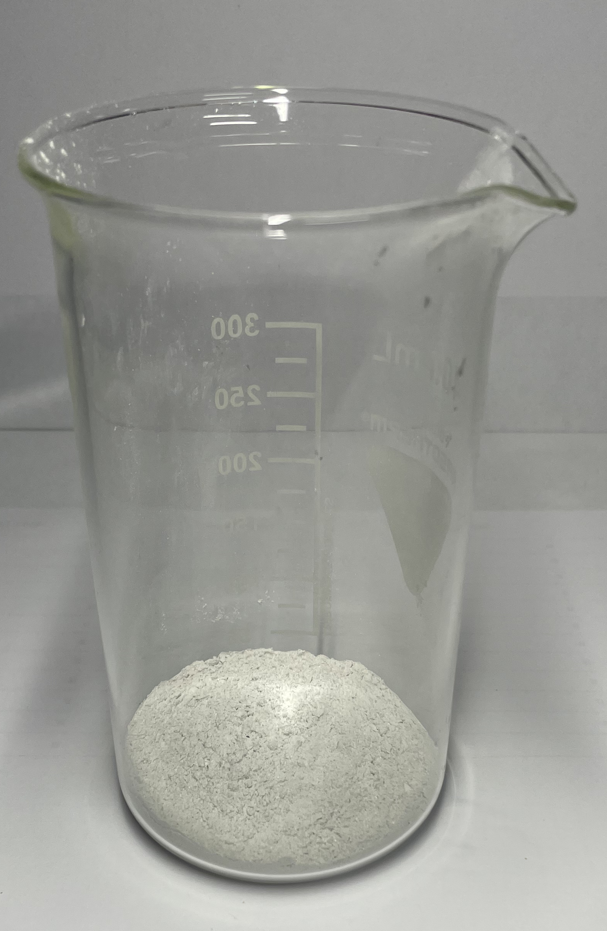
raziskovalna_naloga/slike/beaker_mavec.png
