qyx22122/projekt-RC/raziskovalna_naloga/slike/prerezana_soba2.png

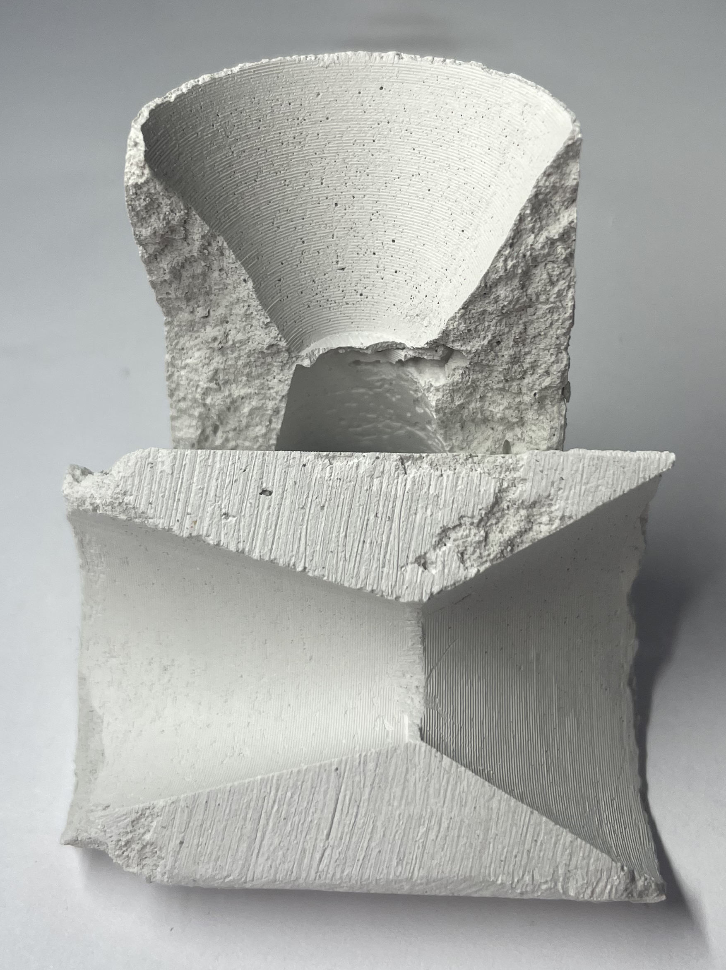
raziskovalna_naloga/slike/prerezana_soba2.png
